yi-aditya/LCEC-IO/docs/review/M4-ethercat.md

# M4 - EtherCAT sheet for review

KiCad project: `hardware/lcec-io.kicad_pro`. New sheet `04_ethercat.kicad_sch` (page 4). The root sheet now wires the ten MCU/EtherCAT nets between sheets 3 and 4. Generated by `scripts/build_schematics.py`, checked from KiCad's own netlist by `scripts/check_sheets.py`.

**To review in the browser:** [`M4-schematics.pdf`](M4-schematics.pdf) (all four sheets, A3), [`M4-sheet4-ethercat.png`](M4-sheet4-ethercat.png), [`M4-sheet1-root.png`](M4-sheet1-root.png). ERC report: [`M4-erc.rpt`](M4-erc.rpt). Sheets 2 and 3 are unchanged from M3 (`M3-sheet2-power.png`, `M3-sheet3-mcu.png`).

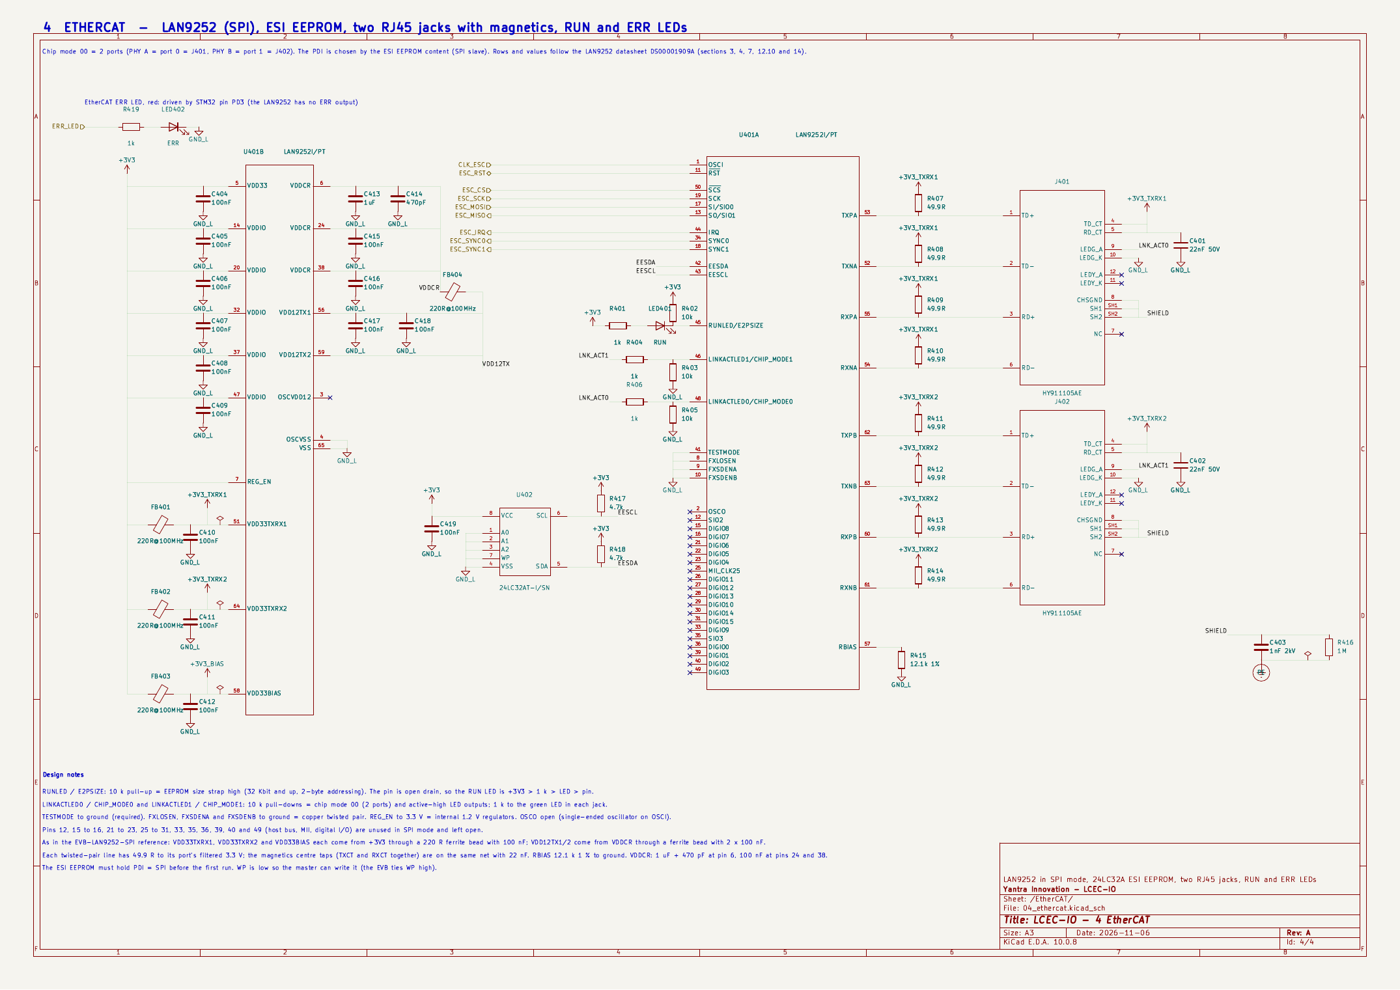
[picture p2: docs/review/M4-sheet4-ethercat.png]
EtherCAT


## Compared with the EVB-LAN9252-SPI reference (you supplied it)

I first drew this sheet from the datasheet because the reference could not be downloaded, then compared it with your PDF (`EVB_LAN9252-SPI` sheets 2 to 4) and **changed the sheet to match it where it differed**: the three PHY supplies and the VDD12TX supply each now come through their own 220 R ferrite bead (BLM18EG221SN1D, C85827, 187,060 on lcsc.com), the terminations and centre taps use each port's own filtered supply, and the centre-tap capacitor is 22 nF.

| Item | EVB reference | This sheet |
|---|---|---|
| SPI pins, IRQ, SYNC0/1 | SCK 19, SCS# 50, SI 17, SO 13, IRQ 44, SYNC0 34, SYNC1 18 | same |
| Straps | TESTMODE, FXLOSEN, FXSDENA/B to ground; REG_EN to 3.3 V; LINKACT0/1 pins 10 k to ground; E2PSIZE 10 k to 3.3 V | same |
| PHY supplies | FB1/FB2/FB3 from 3.3 V to VDD33TXRX1, VDD33TXRX2, VDD33BIAS, 100 nF each | same (FB401 to FB403, 100 nF each; the DNP 1 uF footprints are not drawn) |
| VDD12TX1/2 | from VDDCR through FB4, 2 x 100 nF | same (FB404, 2 x 100 nF) |
| VDDCR, VDD33, VDDIO | 1 uF + 470 pF + 2 x 100 nF; 6 x 100 nF | same |
| Terminations | 4 x 49.9 R per port to that port's VDD33TXRX net | same |
| Centre taps | both tied, 0 R to the port's VDD33TXRX net, 22 nF to ground | same, direct (no 0 R), 22 nF |
| RBIAS, OSCVDD12, OSCVSS | 12.1 k; OSCVDD12 open; OSCVSS to ground | same |
| Link LEDs | 1 k to the jack's green LED | same |

Differences, all from the plan or my choice (please confirm):

| Item | EVB | This sheet | Why |
|---|---|---|---|
| Clock | 25 MHz crystal with 18 pF caps | shared 25 MHz oscillator on OSCI, OSCO open | plan |
| EEPROM | 24FC512, 2 k pull-ups, A0-A2 through 4.7 k to ground, **WP tied high** | 24LC32A, 4.7 k pull-ups, A0-A2 direct to ground, **WP low** | plan; WP low so the master can write the ESI (with WP high it can only be programmed externally) |
| RUN LED resistor | 270 R | 1 k | same part as the other status LEDs, about 1 mA |
| RST# | 10 k pull-up, 0.1 uF, push-button | STM32 PC5 with 10 k pull-up (open drain), no capacitor | plan; the LAN9252 has its own power-on reset |
| Shield / chassis | CHS GND to ground, 10 pF EMI capacitors DNP | CHS GND and shield tabs to 1 nF/2 kV in parallel with 1 M to PE | plan |

## Definition of done

| Requirement | Result |
|---|---|
| `kicad-cli sch erc` zero errors, run from the root | **0 errors**, the same 2 warnings as M3 (`ground_pin_not_ground` on U201/U203) |
| LAN9252 matches the reference circuit | compared with the EVB-LAN9252-SPI schematic (table above); differences listed; every item checked by script against the netlist |
| SPI/IRQ/SYNC/RST nets match the pin map in `docs/plan.md` | checked from the netlist: STM32 PA4/PA5/PA6/PA7/PC4/PA0/PC13/PC5 are on the same nets as LAN9252 pins 50/19/13/17/44/34/18/11 |
| Drawing rules from M3 | style check passes on all four sheets: every instance at rotation 0, none mirrored, all text horizontal, no pin on the top or bottom edge |
| Every symbol has Value, Footprint, LCSC, MPN, Manufacturer, Datasheet | all parts, checked by script; BOM quantities not exceeded |

## What is on the sheet

- **U401 LAN9252I/PT**, two units: signals (U401A) and power (U401B). Host interface is **SPI** (SCS#, SCK, SI, SO); IRQ, SYNC0, SYNC1, RST# go to the STM32; OSCI takes the 25 MHz clock from the MCU sheet (OSCO open, as the datasheet says for a single-ended oscillator).
- **Chip mode 00 (2 ports):** CHIP_MODE0/1 share the link LED pins and are held low by 10 k pull-downs. PHY A is port 0 (J401), PHY B is port 1 (J402).
- **EEPROM:** U402 24LC32A on EESDA/EESCL with 4.7 k pull-ups, WP low so the master can write the ESI. **E2PSIZE** (RUNLED pin) has a 10 k pull-up: strap high = 32 Kbit and up, 2-byte addressing, as the 24LC32A needs. The EEPROM image must set PDI = SPI.
- **Straps:** TESTMODE to ground (datasheet: must be VSS); FXLOSEN, FXSDENA, FXSDENB to ground = copper; REG_EN to 3.3 V = internal 1.2 V regulators.
- **Supplies:** 100 nF at VDD33 and each of the 5 VDDIO pins; VDDCR (3 pins) 1 uF + 470 pF at pin 6 and 100 nF on the others; VDD12TX1 and VDD12TX2 tied together and fed from VDDCR through FB404 with 2 x 100 nF (datasheet: fed from the regulator via the PCB; EVB uses the ferrite). OSCVDD12 left open (datasheet: no external capacitor required).
- **PHY 3.3 V:** VDD33TXRX1, VDD33TXRX2 and VDD33BIAS each from +3V3 through a 220 R ferrite bead (FB401 to FB403) with 100 nF, nets `+3V3_TXRX1`, `+3V3_TXRX2`, `+3V3_BIAS`.
- **Twisted pairs:** TXP/TXN/RXP/RXN of each port go straight to the jack; each line has 49.9 R to its port's filtered supply (8 resistors). RBIAS 12.1 k 1 % to ground.
- **Jacks:** the HY911105AE has its own Bob Smith termination (4 x 75 R and 1 nF/2 kV to chassis, from its datasheet drawing). Both centre taps go to the port's `+3V3_TXRX` net with 22 nF. Green LED = link/activity from the LAN9252 pin through 1 k (active high, because the strap is low). Yellow LED unused. CHS GND and both shield tabs go to the shield net: **1 nF/2 kV in parallel with 1 M to PE** (plan).
- **RUN LED:** +3V3 > 1 k > LED401 > RUNLED pin (open drain, active low because E2PSIZE is high). **ERR LED:** LED402 red, driven from the STM32 (PD3 via the `ERR_LED` hierarchical label) through 1 k.
- **Unused pins** (host bus, MII, digital I/O, OSCO, 20 pins) carry no-connect flags.

## BOM changes (this milestone)

- 49.9 R is now a fixed quantity of 8 (was an estimate).
- Added 470 pF 50 V X7R 0603, **C1620** (77,200 in stock on lcsc.com); 4 ferrite beads 220 R **C85827** (FB401 to FB404, 187,060 in stock); 2 x 22 nF 50 V X7R **C106222** (246,700 in stock).
- LED references: RUN is LED401, ERR is LED402 (the plan list had LED401-LED402 and LED403).
- Removed the "10 uF x 4 (per LAN9252 reference in M4)" estimate row: the datasheet needs no 10 uF capacitor on this sheet.
- Still open from M3: Omron P2R-05P relay socket (C1524860) shows low stock, 44 on lcsc.com for 8 needed.

## Library changes

- `scripts/relayout_symbols.py` re-lays out the LAN9252 (two units, SPI signals grouped, blank rows where parts hang), the HY911105AE jack, and the 24LC32A EEPROM so no pin is on the top or bottom edge. Pin numbers are unchanged; the LAN9252 shows only the SPI-mode name of each pin, and `scripts/pin_tables.py` now compares by token for it. Datasheet pin check: 44 of 44 symbols clean.

## How it was built and checked

```
python3 -I scripts/relayout_symbols.py   # after fix_symbols.py; then finalize_lib.py
python3 -I scripts/build_schematics.py   # writes hardware/*.kicad_sch
python3 -I scripts/check_sheets.py       # ERC, pin map, netlist checks for sheets 2-4, style, fields, BOM quantities
```
