yi-aditya/LCEC-IO/docs/review/M3-sheet1-root.png

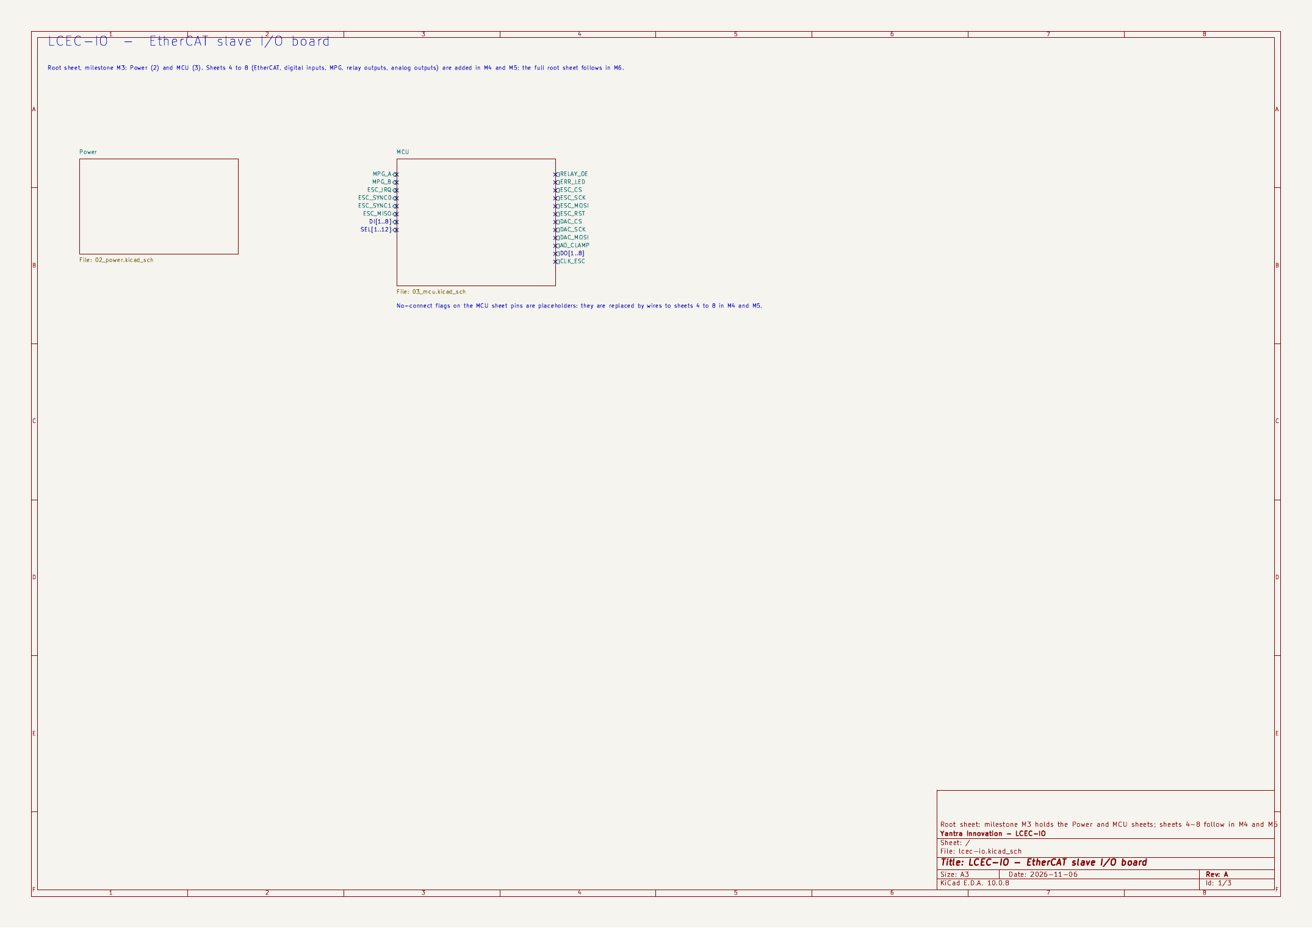
docs/review/M3-sheet1-root.png
