yi-aditya/LCEC-IO/docs/review/M4-sheet1-root.png

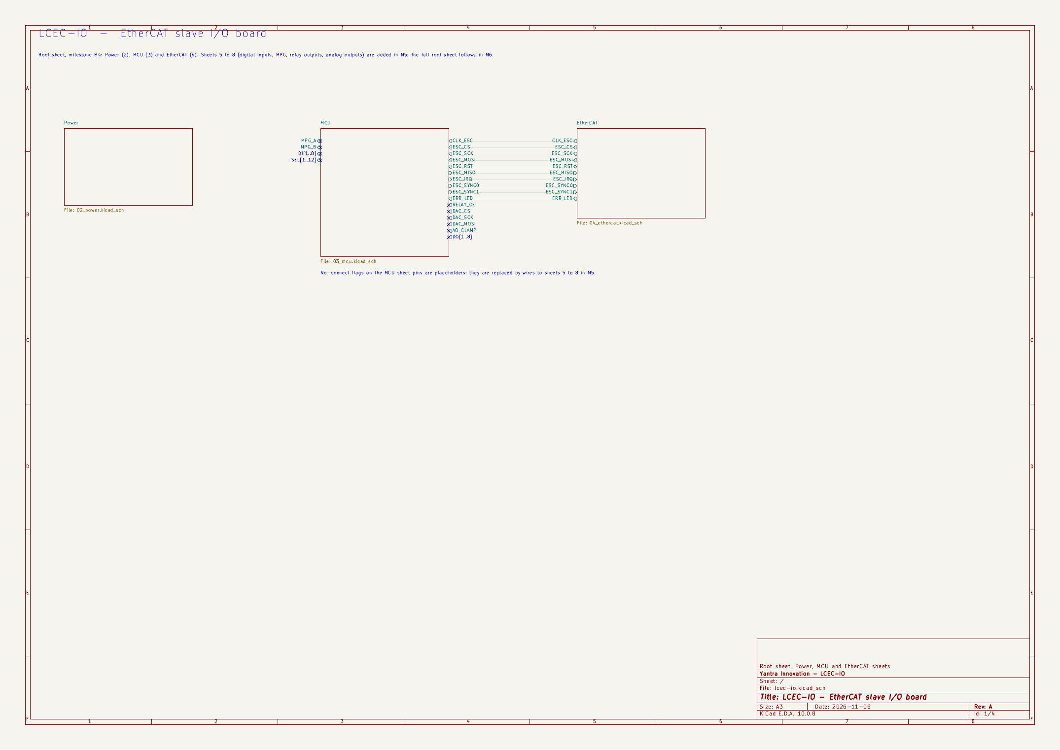
docs/review/M4-sheet1-root.png
