yi-aditya/LCEC-IO/docs/review/M5-sheet1-root.png

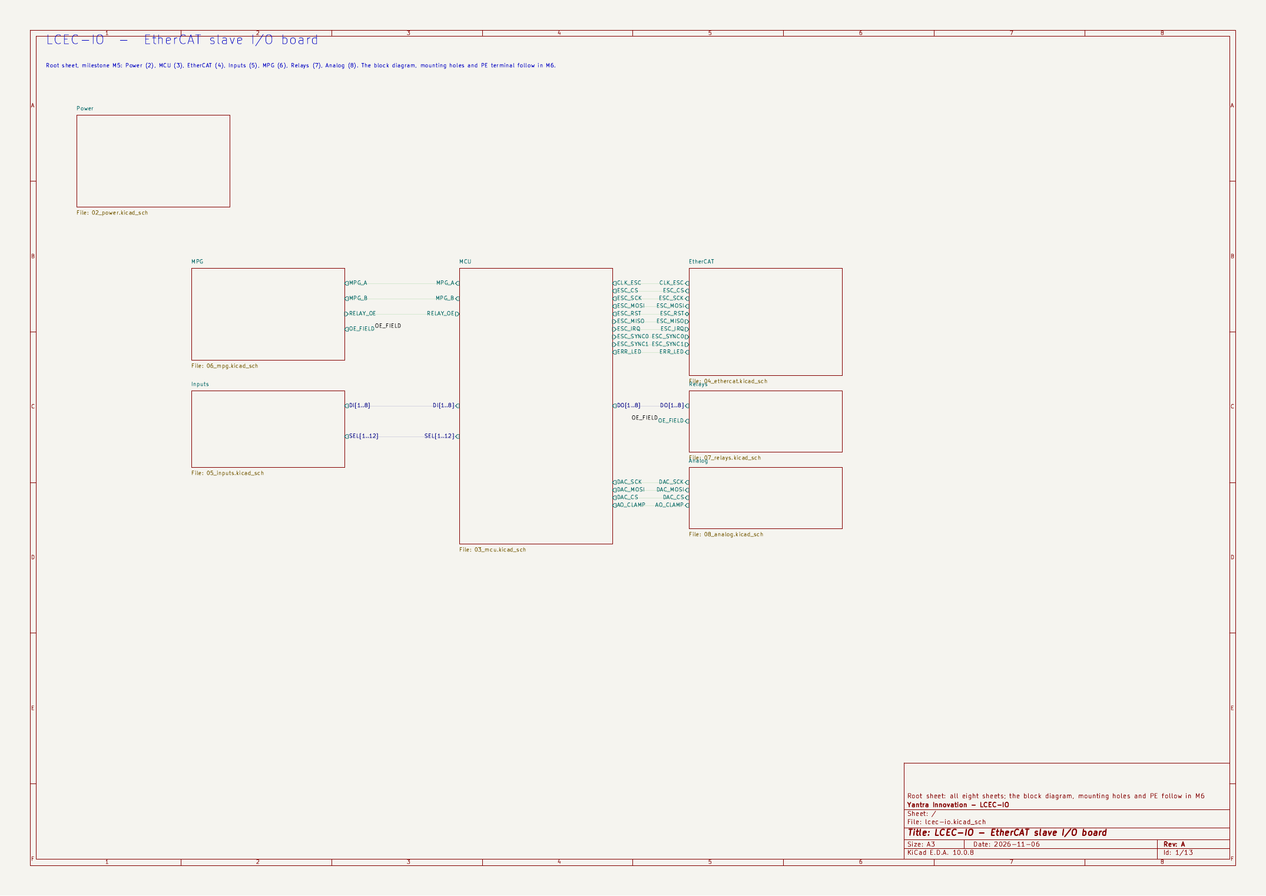
docs/review/M5-sheet1-root.png
