yi-aditya/LCEC-IO/docs/review/M5-sheet5-inputs.png

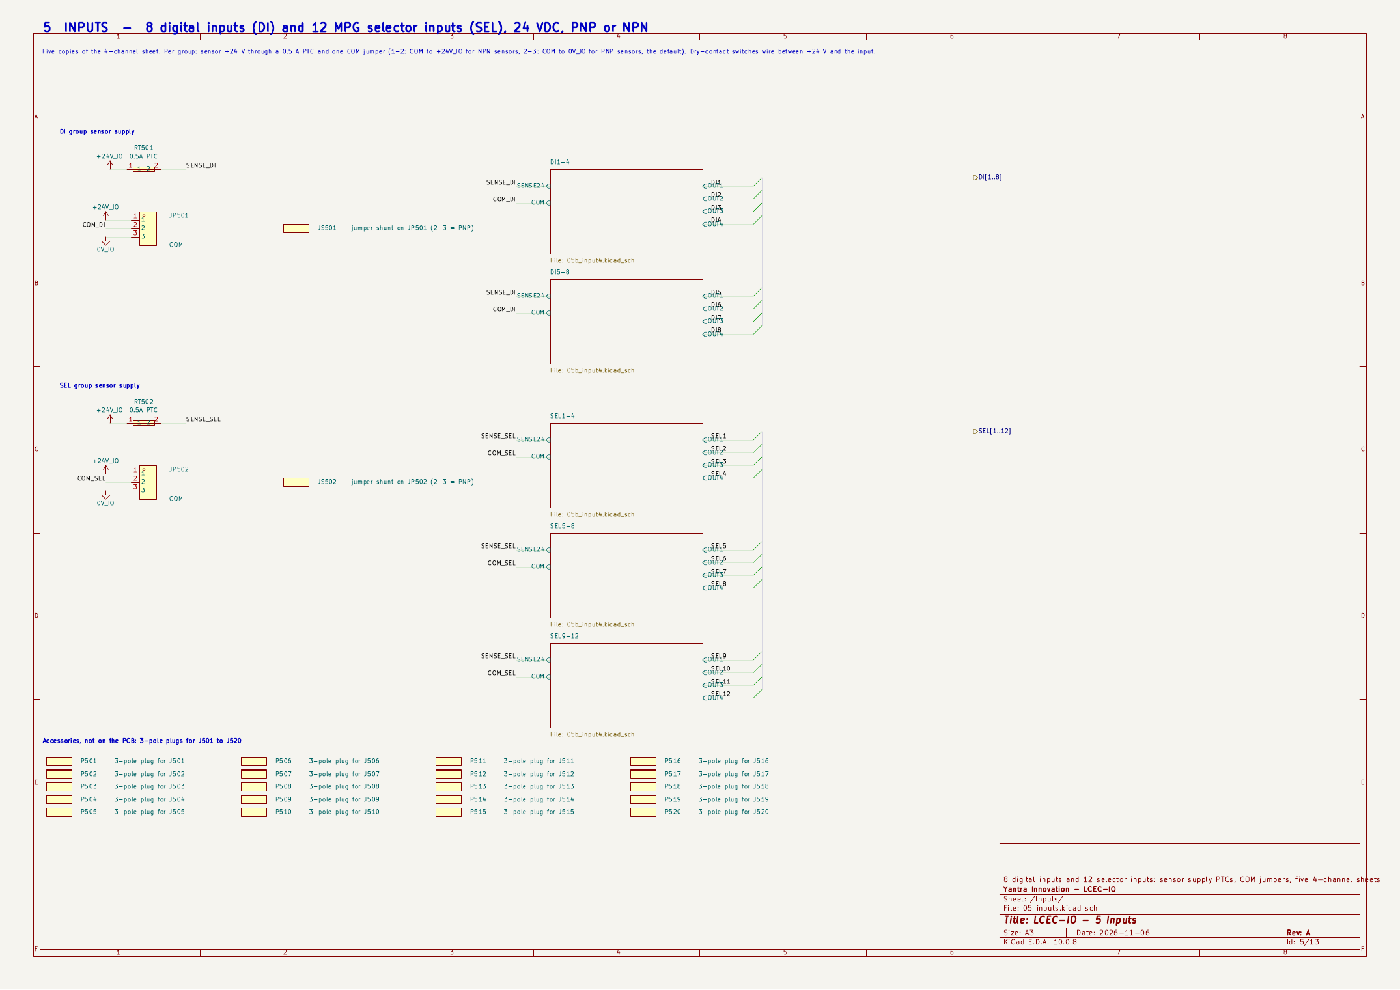
docs/review/M5-sheet5-inputs.png
