yi-aditya/LCEC-IO/docs/review/M5-sheet5b-input4.png

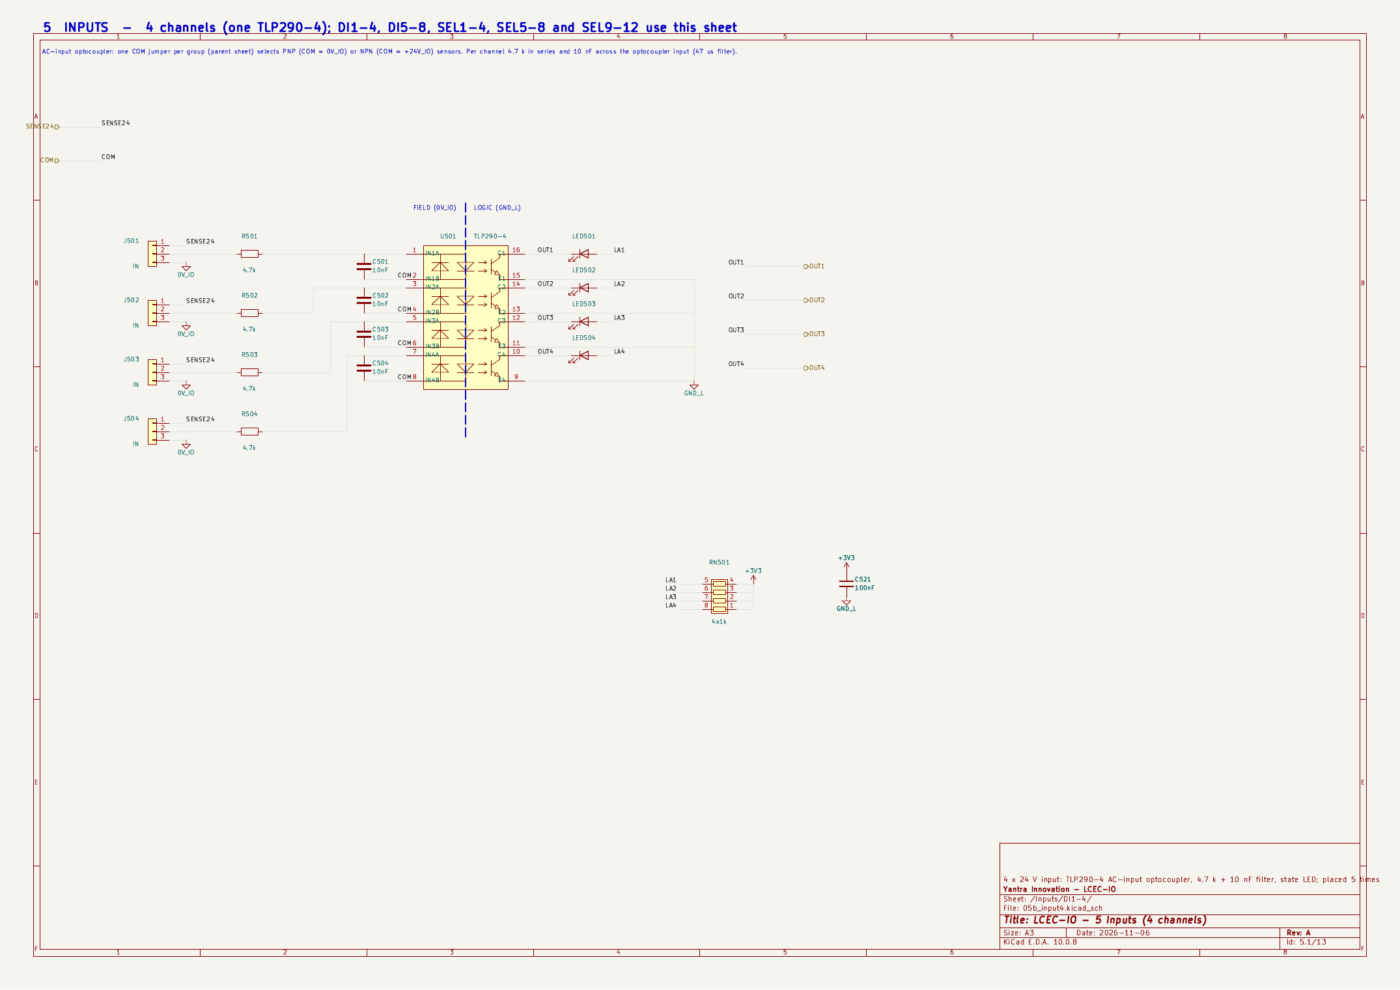
docs/review/M5-sheet5b-input4.png
