yi-aditya/LCEC-IO/docs/review/M5-sheet6-mpg.png

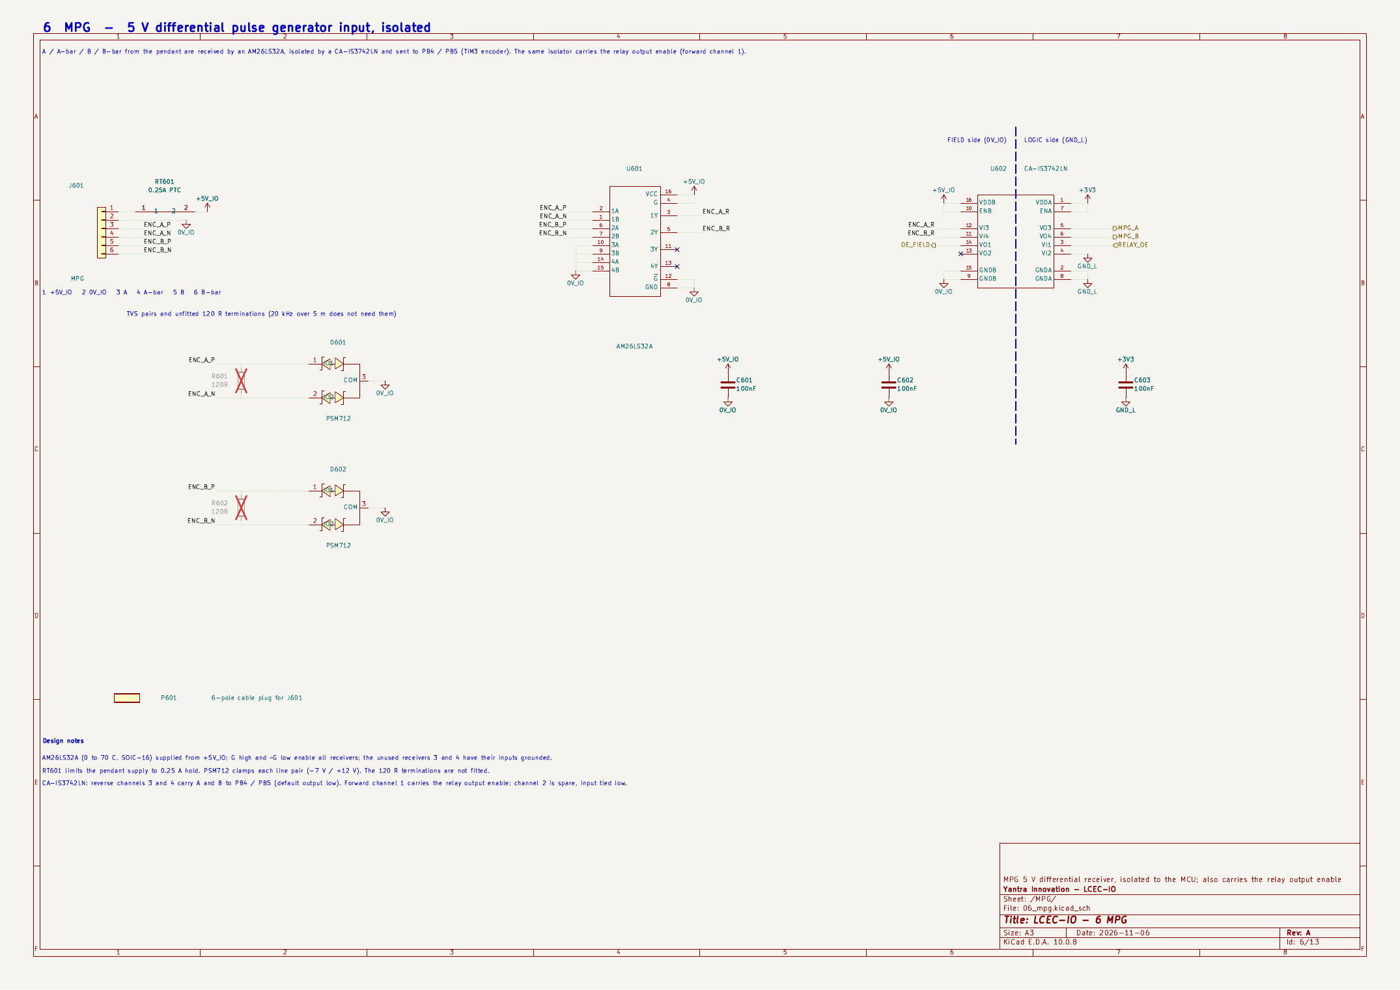
docs/review/M5-sheet6-mpg.png
