yi-aditya/LCEC-IO/docs/review/M5-sheet7-relays.png

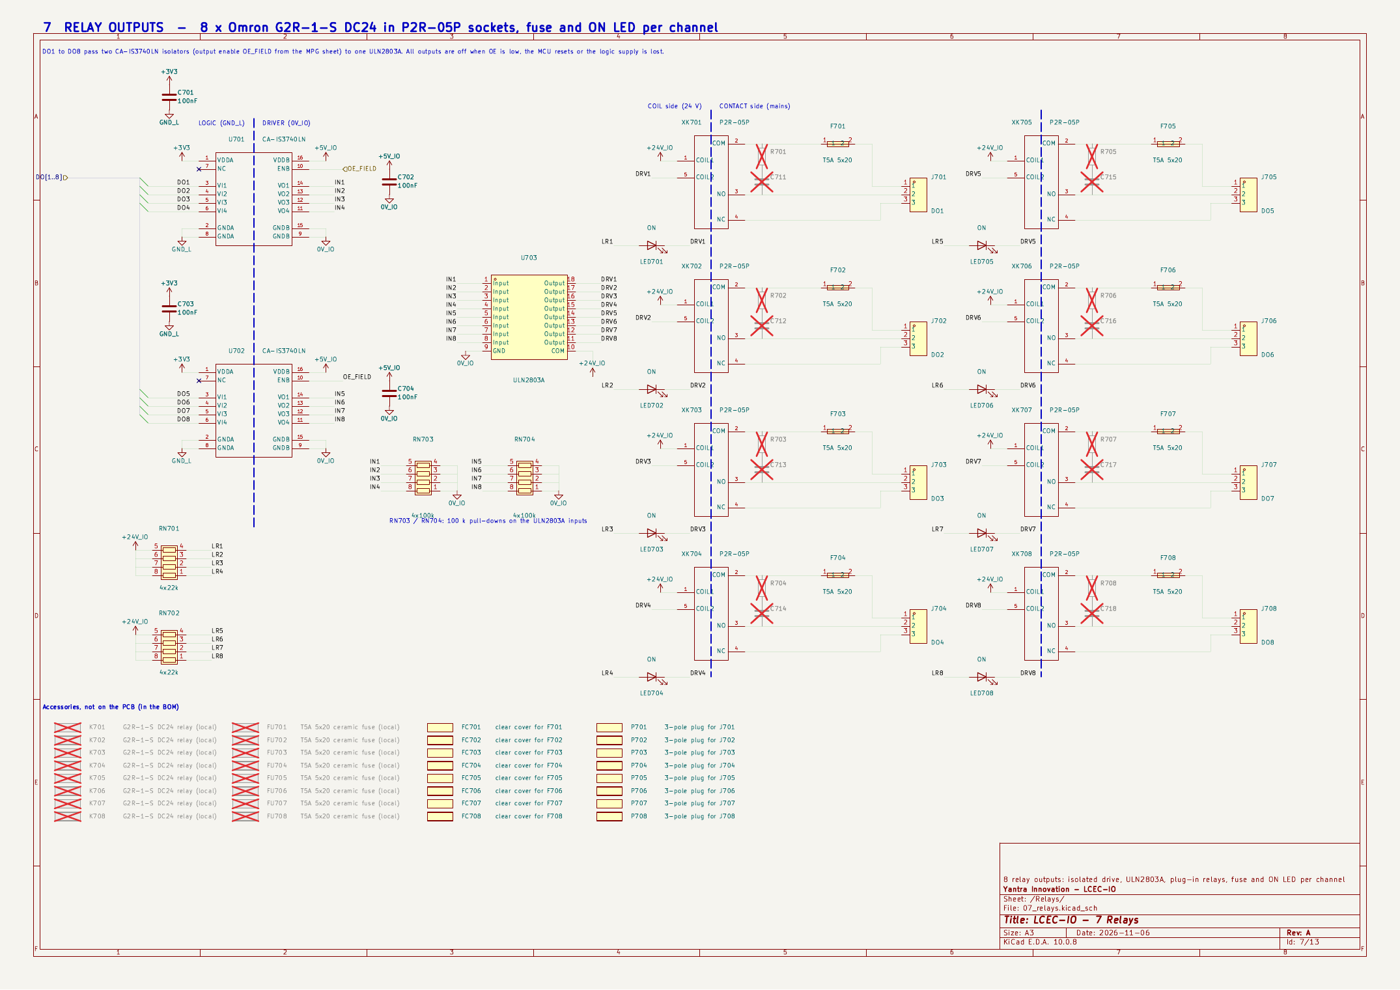
docs/review/M5-sheet7-relays.png
