yi-aditya/LCEC-IO/docs/review/M5-sheet8-analog.png

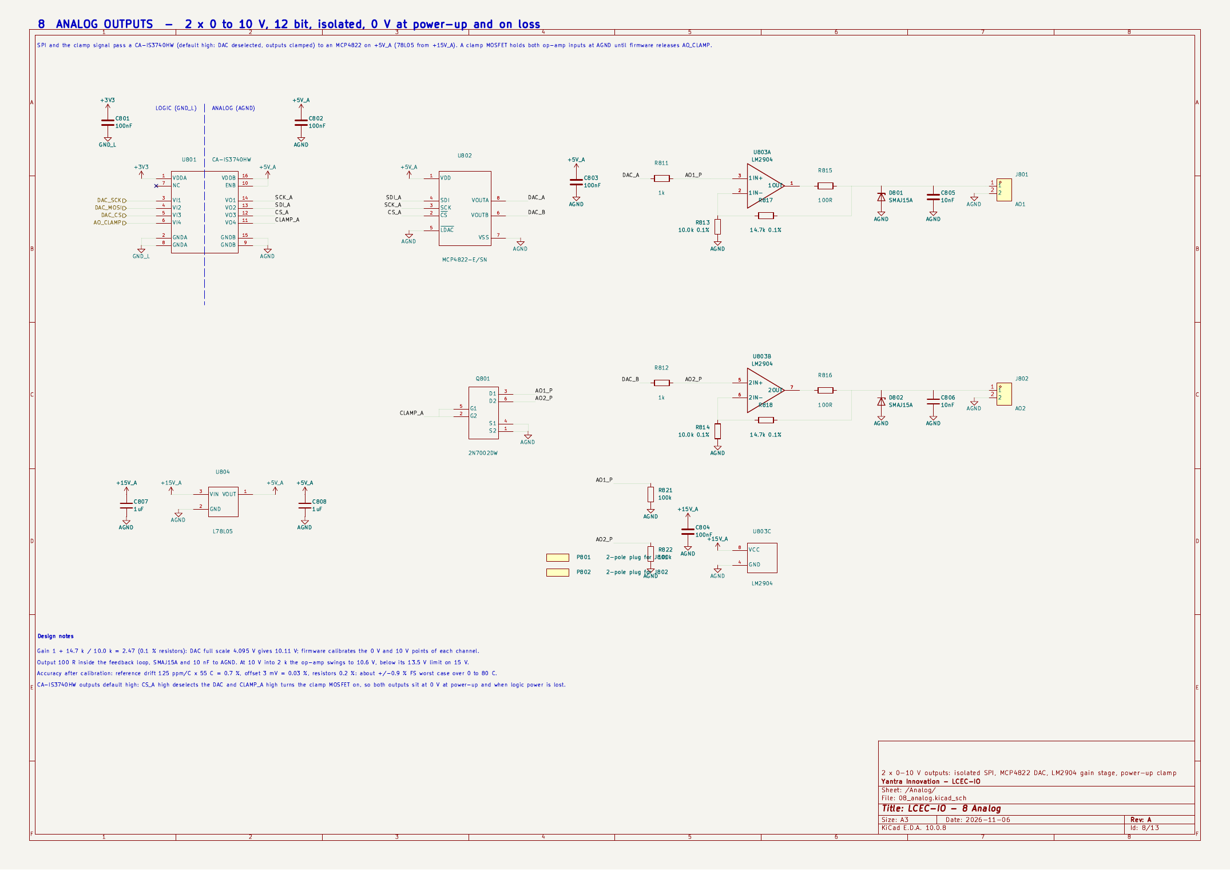
docs/review/M5-sheet8-analog.png
