yi-aditya/LCEC-IO/docs/review/M6-floorplan-v1-260x160.png

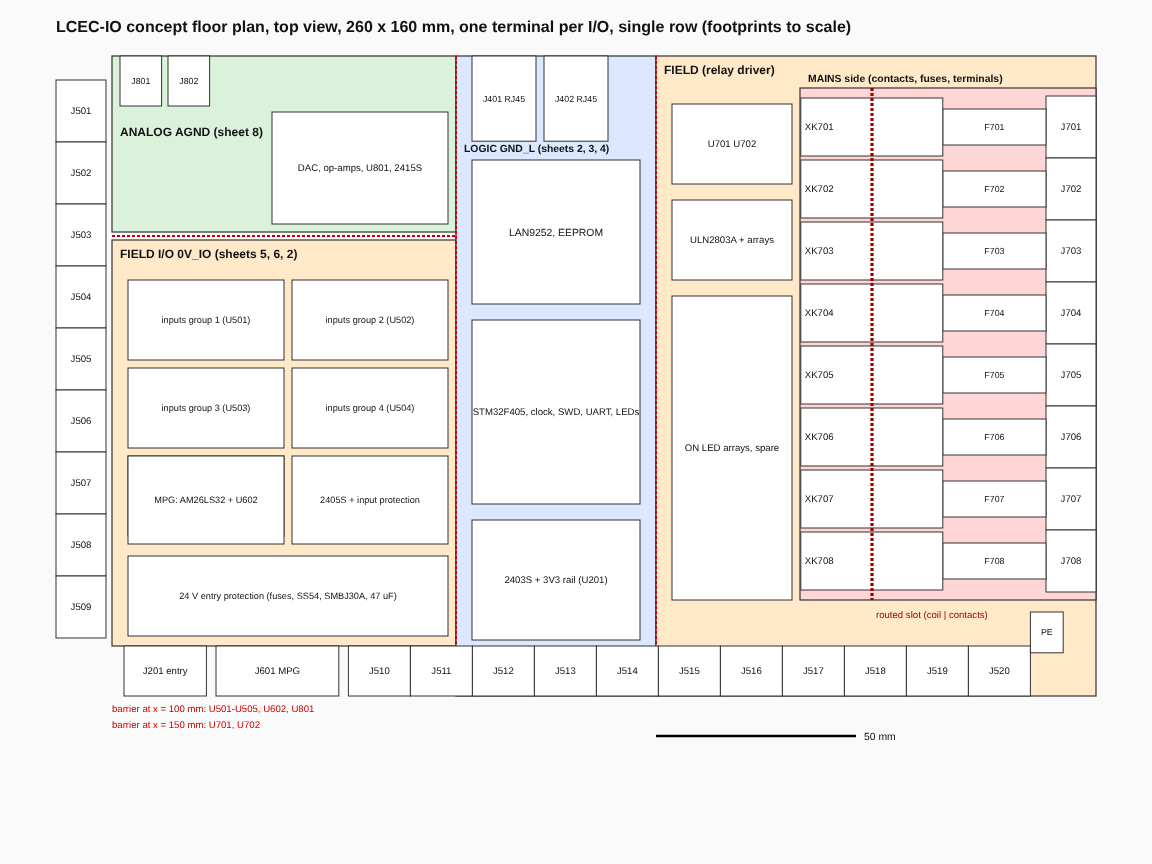
docs/review/M6-floorplan-v1-260x160.png
