yi-aditya/LCEC-IO/docs/review/M6-sheet1-root.png

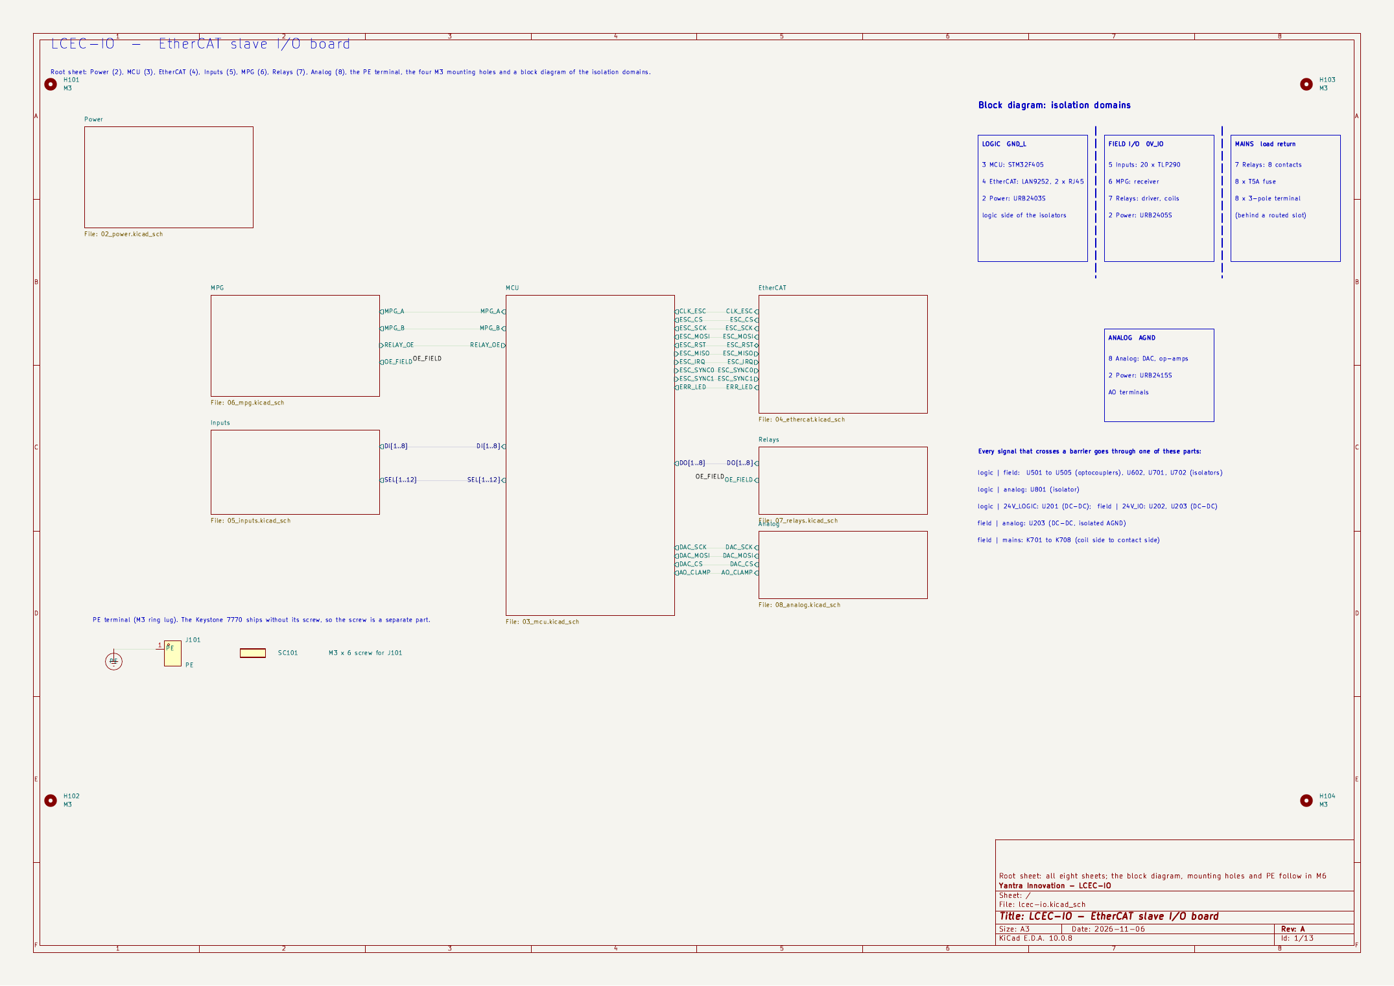
docs/review/M6-sheet1-root.png
