yi-aditya/LCEC-IO/bom/parts.csv

Sheet | RefGroup | Description | Qty | Qty_basis | Footprint | LCSC | MPN | Manufacturer | Package_LCSC | Temp_range | Stock | Price_USD_qty1 | Library | Fit | Status | Proposed_LCSC | Notes | Checked
3 MCU | U301 | STM32F405VGT6 MCU LQFP-100 | 1 | fixed | lcsc:LQFP-100_L14.0-W14.0-P0.50-LS16.0-BL | C56621 | STM32F405VGT6 | ST | LQFP-100(14x14) | -40℃~+85℃ | 920 | 7.6428 | extended | Y | CHANGED |  | Owner decision 2026-11-06: 100-pin package instead of the plan's LQFP-64 F405RGT6 (82 I/O, room for the EtherCAT ERR LED and future pins). Same F4 core, 1 MB flash. About $7.6 at qty 1 (plan: about $3.2) with about 900 in stock on lcsc.com. 6 VDD pins need 6 decoupling capacitors. | 2026-11-06
3 MCU | X301 | 25 MHz CMOS oscillator, 3.2x2.5 mm | 1 | fixed | lcsc:OSC-SMD_4P-L3.2-W2.5-BL_KYOCERA_KC3225A | C2595919 | ECS-3225MVQ-250-CN-TR | ECS | SMD3225-4P | -40℃~+85℃ | 45 | 2.028 | extended | Y | PLAN-FLAG |  | Ordering code -CN decodes to +/-25 ppm, -40..+85 C (datasheet ordering table), meets the <= +/-50 ppm target. Datasheet note says +/-25 ppm is 'contact ECS for availability' and LCSC stock is under 100: confirm before ordering. | 2026-11-06
3 MCU | J301 | SWD header 2x5 1.27 mm SMD | 1 | fixed | lcsc:HDR-SMD_10P-P1.27-V-M-R2-C5-LS5.3 | C3975188 | PZ127-2-05-S | HCTL | SMD,P=1.27mm | -40℃~+105℃ | 14970 | 0.1472 | extended | Y | NEW |  | PA13, PA14, PB3 SWO, NRST, 3V3, GND. | 2026-11-06
3 MCU | J302 | USART2 header 1x3 2.54 mm | 1 | fixed | lcsc:HDR-TH_3P-P2.54-V-M_PZ254V-11-03P | C2937625 | PZ254V-11-03P | XFCN | Through Hole,P=2.54mm | -40℃~+105℃ | 1011340 | 0.0201 | extended | Y | NEW |  | PA2/PA3 + GND. Same part as the two COM jumper headers. | 2026-11-06
3 MCU | FB301 | Ferrite bead 600R@100MHz 0603 (VDDA) | 1 | fixed | Inductor_SMD:L_0603_1608Metric | C19330 | BLM18AG601SN1D | muRata | 0603 | -55℃~+125℃ | 431100 | 0.0122 | extended | Y | NEW |  | VDDA filter. Murata, 500 mA. (Sunlord C1002 is basic but has no LCSC product page, so its stock cannot be checked.) | 2026-11-06
3 MCU | LED301 | Heartbeat LED yellow 0603 | 1 | fixed | LED_SMD:LED_0603_1608Metric | C2287 | KT-0603Y | Hubei KENTO Elec | 0603 | -40℃~+85℃ | 91350 | 0.0108 | extended | Y | NEW |  | PA1. | 2026-11-06
4 EtherCAT | U401 | LAN9252I/PT EtherCAT slave controller TQFP-64 | 1 | fixed | lcsc:TQFP-64_L10.0-W10.0-P0.50-LS12.0-BL-EP | C80933 | LAN9252I/PT | MICROCHIP | TQFP-64(10x10) | -40℃~+85℃ | 4189 | 8.6354 | extended | Y | PLAN |  |  | 2026-11-06
4 EtherCAT | U402 | 24LC32AT-I/SN EEPROM 32 Kbit SOIC-8 | 1 | fixed | lcsc:SOIC-8_L4.9-W3.9-P1.27-LS6.0-BL | C615715 | 24LC32AT-I/SN | MICROCHIP | SOIC-8 | -40℃~+85℃ | 2185 | 0.4696 | extended | Y | PLAN |  | ESI EEPROM. | 2026-11-06
4 EtherCAT | J401-J402 | RJ45 jack with integrated magnetics and LEDs | 2 | fixed | lcsc:RJ45-TH_HR911105A | C69427 | HY911105AE | HANRUN(Zhongshan HanRun Elec) | Through Hole | -40℃~+85℃ | 3023 | 2.8377 | extended | Y | PLAN |  | Datasheet checked: 1CT:1CT magnetics, green + yellow LEDs, 1500 Vrms, -40..+85 C. Image-only PDF, so magnetics wiring is re-read in M2/M4. | 2026-11-06
4 EtherCAT | LED401 | EtherCAT RUN LED (yellow-green) 0603 | 1 | fixed | LED_SMD:LED_0603_1608Metric | C89809 | NCD0603C3 | NATIONSTAR | 0603 | -30℃~+85℃ | 20640 | 0.0261 | extended | Y | CHANGED |  | Yellow-green accepted 2026-11-05 in place of 'green': no ~2 V green exists on LCSC and emerald-green (Vf 2.6-3.6 V) may not light from 3.3 V through 1 kOhm. | 2026-11-06
4 EtherCAT | LED402 | EtherCAT ERR LED red 0603 | 1 | fixed | LED_SMD:LED_0603_1608Metric | C2286 | KT-0603R | Hubei KENTO Elec | 0603 | -40℃~+85℃ | 4158200 | 0.0077 | basic | Y | NEW |  |  | 2026-11-06
4 EtherCAT | R4xx | 49.9 R 1% 0603 (LAN9252 TX/RX termination) | 8 | fixed | Resistor_SMD:R_0603_1608Metric | C23185 | 0603WAF499JT5E | UNI-ROYAL | 0603 | -55℃~+155℃ | 555100 | 0.002 | basic | Y | NEW |  | M4: one 49.9 R from each of the 8 twisted-pair lines (TXP/TXN/RXP/RXN, two ports) to the port's ferrite-filtered 3.3 V (EVB reference R4-R7, R15-R18). | 2026-11-06
4 EtherCAT | R4xx | 12.1 k 1% 0603 (RBIAS) | 1 | fixed | Resistor_SMD:R_0603_1608Metric | C22864 | 0603WAF1212T5E | UNI-ROYAL | 0603 | -55℃~+155℃ | 154400 | 0.0016 | extended | Y | NEW |  | Extended part (no basic 12.1 k). | 2026-11-06
4 EtherCAT | R4xx | 4.7 k 1% 0603 (EEPROM pull-ups) | 2 | fixed | Resistor_SMD:R_0603_1608Metric | C23162 | 0603WAF4701T5E | UNI-ROYAL | 0603 | -55℃~+155℃ | 4065700 | 0.0028 | basic | Y | NEW |  |  | 2026-11-06
4 EtherCAT | R4xx | 1 M 1% 0603 (shield bleed) | 1 | fixed | Resistor_SMD:R_0603_1608Metric | C22935 | 0603WAF1004T5E | UNI-ROYAL | 0603 | -55℃~+155℃ | 1542400 | 0.0018 | basic | Y | NEW |  | In parallel with the 1 nF/2 kV cap, shield to PE. | 2026-11-06
4 EtherCAT | FB401-FB404 | Ferrite bead 220R@100MHz 0603 (LAN9252 PHY supplies, VDD12TX) | 4 | fixed | Inductor_SMD:L_0603_1608Metric | C85827 | BLM18EG221SN1D | muRata | 0603 | -55℃~+125℃ | 186860 | 0.0597 | extended | Y | NEW |  | Same part as the EVB-LAN9252-SPI reference (FB1-FB4): one each for VDD33TXRX1, VDD33TXRX2, VDD33BIAS and VDD12TX. | 2026-11-06
4 EtherCAT | C4xx | 22 nF 50 V X7R 0603 (magnetics centre taps) | 2 | fixed | Capacitor_SMD:C_0603_1608Metric | C106222 | CC0603KRX7R9BB223 | YAGEO | 0603 | see MPN datasheet | 246600 | 0.0032 | extended | Y | NEW |  | EVB reference C27/C33 (0.022 uF/50 V), one per jack. | 2026-11-06
4 EtherCAT | C4xx | 470 pF 50 V X7R 0603 (LAN9252 VDDCR) | 1 | fixed | Capacitor_SMD:C_0603_1608Metric | C1620 | 0603B471K500NT | FH | 0603 | see MPN datasheet | 77100 | 0.0058 | basic | Y | NEW |  | DS00001909A section 3.x: 1 uF and 470 pF in parallel on the VDDCR pin 6. | 2026-11-06
4 EtherCAT | C4xx | 1 nF 2 kV X7R 1206 (shield to PE) | 1 | fixed | Capacitor_SMD:C_1206_3216Metric | C9196 | 1206B102K202NT | FH | 1206 | see MPN datasheet | 219120 | 0.0229 | basic | Y | NEW |  |  | 2026-11-06
2 Power | U201 | URB2403S-6WR3 isolated DC-DC 24V to 3.3V 1.35 A | 1 | fixed | lcsc:PWRM-TH_URBXXXXS-6WR3_1 | C5369843 | URB2403S-6WR3 | YLPTEC | SIP,22x9.5mm | -40℃~+105℃ | 182 | 5.6911 | extended | Y | PLAN-FLAG |  | Datasheet: absolute max input 40 V ('exceeding may cause permanent damage'). The plan's SMBJ33A clamped at 53.3 V; replaced by the SMBJ30A (48.4 V) on 2026-11-06. | 2026-11-06
2 Power | U202 | URB2405S-6WR3 isolated DC-DC 24V to 5V 1.2 A | 1 | fixed | lcsc:PWRM-TH_YLPTEC_URXXXXXS-6WR3 | C3031185 | URB2405S-6WR3 | YLPTEC | SIP,22x9.5mm | -40℃~+105℃ | 6188 | 4.8336 | extended | Y | PLAN-FLAG |  | Same 40 V input maximum. | 2026-11-06
2 Power | U203 | URB2415S-6WR3 isolated DC-DC 24V to 15V 0.4 A | 1 | fixed | lcsc:PWRM-TH_URBXXXXS-6WR3 | C5369844 | URB2415S-6WR3 | YLPTEC | SIP,22x9.5mm | -40℃~+105℃ | 109 | 5.7982 | extended | Y | PLAN-FLAG |  | LCSC rates -40..+105 C (plan said 'check datasheet'). Same 40 V input maximum; stock about 100. | 2026-11-06
2 Power | D201-D202 | SMBJ30A TVS 600 W, 30 V stand-off, SMB | 2 | fixed | lcsc:SMB_L4.4-W3.6-LS5.4-RD | C83851 | SMBJ30A | Littelfuse | DO-214AA | -65℃~+150℃ | 17085 | 0.1279 | extended | Y | CHANGED |  | Owner decision 2026-11-06: SMBJ30A replaces the plan's SMBJ33A (C320242). Vc = 48.4 V at 12.4 A, below the URB 50 V / 1 s surge rating; 30 V stand-off is above the 28.8 V maximum input. | 2026-11-06
2 Power | D203-D204 | SS54 Schottky 40 V 5 A SMA (reverse polarity) | 2 | fixed | lcsc:SMA_L4.4-W2.8-LS5.4-R-RD | C22452 | SS54 | MDD(Microdiode Semiconductor) | SMA(DO-214AC) | see MPN datasheet | 1462890 | 0.045 | basic | Y | NEW |  | Basic part. 40 V reverse rating vs 28.8 V max input. | 2026-11-06
2 Power | F201-F202 | Fuse block 5x20 mm PCB, Littelfuse 646 (24V_LOGIC, 24V_IO) | 2 | fixed | lcsc:64600001003 | C206887 | 64600001003 | Littelfuse | Through Hole | see MPN datasheet | 963 | 0.9428 | extended | Y | CHANGED |  | Owner chose replaceable 5x20 fuses for the two 24 V inputs (2026-11-05). Same block as the relay fuses (replaces the C58066 holder, which had no dimensioned drawing). Footprint checked against the Littelfuse hole-pattern drawing (22.6 mm). | 2026-11-06
2 Power | F201 | Fuse 5x20 mm 1 A 250 V glass (24V_LOGIC) | 1 | fixed | n/a (accessory, not on the PCB) | C3116 | 5F.1000210000R1 | Xucheng Elec | D5.2xL20mm | -40℃~+125℃ | 10940 | 0.0648 | extended | Y | CHANGED |  | Fitted at assembly (cheap, on LCSC). 5F series = fast-acting; confirm blow characteristic vs inrush into 47 uF at M3. | 2026-11-06
2 Power | F202 | Fuse 5x20 mm 3 A 250 V glass (24V_IO) | 1 | fixed | n/a (accessory, not on the PCB) | C3118 | 5G.3000210000S1 | Xucheng Elec | D5.2xL20mm | -40℃~+125℃ | 1830 | 0.0648 | extended | Y | CHANGED |  | Fitted at assembly. Confirm blow characteristic at M3. | 2026-11-06
2 Power | C2xx | 47 uF 50 V aluminium electrolytic SMD 6.3x7.7 | 2 | fixed | lcsc:CAP-SMD_BD6.3-L6.6-W6.6-LS7.2-FD | C970679 | RVT1H470M0607 47UF 50V | DMBJ | SMD,D6.3xL7.7mm | -55℃~+105℃ | 31920 | 0.0378 | extended | Y | NEW |  | One per 24 V input. | 2026-11-06
2 Power | C2xx | 1 uF 50 V X7R 0805 | 2 | fixed | Capacitor_SMD:C_0805_2012Metric | C91185 | CC0805KKX7R9BB105 | YAGEO | 0805 | see MPN datasheet | 154860 | 0.035 | extended | Y | CHANGED |  | One per 24 V input. Replaces C28323 (lcsc.com stock 0). | 2026-11-06
2 Power | C2xx | 22 uF 25 V X5R 0805 (URB output capacitor) | 3 | fixed | Capacitor_SMD:C_0805_2012Metric | C45783 | CL21A226MAQNNNE | Samsung Electro-Mechanics | 0805 | see MPN datasheet | 118800 | 0.1851 | basic | Y | NEW |  | Datasheet Cout: 22 uF/16 V for 3.3 V and 5 V, 22 uF/25 V for 15 V. One 25 V part covers all three. | 2026-11-06
2 Power | C2xx | 100 uF 100 V electrolytic radial (URB input capacitor) | 3 | fixed | lcsc:CAP-TH_BD10.0-P5.00-D0.6-FD | C2960285 | 100V100uF CD288 | HRK | Through Hole,D10xL20mm | -40℃~+105℃ | 2075 | 0.094 | extended | Y | CHANGED |  | Approved 2026-11-05. URB datasheet (Fig. 2/3) recommends Cin 100 uF/100 V per module on a 24 V input. 10 mm diameter radial: reserve layout space. | 2026-11-06
3 MCU | C3xx | 2.2 uF 16 V X5R 0603 (VCAP) | 2 | fixed | Capacitor_SMD:C_0603_1608Metric | C23630 | CL10A225KO8NNNC | Samsung Electro-Mechanics | 0603 | see MPN datasheet | 225750 | 0.012 | basic | Y | NEW |  |  | 2026-11-06
3 MCU | C3xx | 4.7 uF 16 V X5R 0603 (bulk) | 1 | fixed | Capacitor_SMD:C_0603_1608Metric | C19666 | CL10A475KO8NNNC | Samsung Electro-Mechanics | 0603 | see MPN datasheet | 1103370 | 0.0151 | basic | Y | NEW |  | STM32 bulk plus LAN9252 supply; final count at schematic. | 2026-11-06
3 MCU | R3xx | 22 R 1% 0603 (clock series) | 2 | fixed | Resistor_SMD:R_0603_1608Metric | C23345 | 0603WAF220JT5E | UNI-ROYAL | 0603 | -55℃~+155℃ | 2563300 | 0.0017 | basic | Y | NEW |  | Oscillator to PH0 and to LAN9252 OSCI. | 2026-11-06
3 MCU | R3xx | 10 k 1% 0603 | 7 | fixed | Resistor_SMD:R_0603_1608Metric | C25804 | 0603WAF1002T5E | UNI-ROYAL | 0603 | -55℃~+155℃ | 4409600 | 0.0024 | basic | Y | NEW |  | BOOT0, PD2 pull-down, PB14 and PC5 pull-ups, LAN9252 straps. Final count at schematic. | 2026-11-06
3 MCU | R3xx | 1 k 1% 0603 (status LED resistors) | 5 | fixed | Resistor_SMD:R_0603_1608Metric | C21190 | 0603WAF1001T5E | UNI-ROYAL | 0603 | -55℃~+155℃ | 2407100 | 0.0017 | basic | Y | NEW |  | Heartbeat, RUN, ERR and four jack LEDs. | 2026-11-06
all | C xx | 100 nF 50 V X7R 0603 | 40 | fixed | Capacitor_SMD:C_0603_1608Metric | C1591 | CL10B104KB8NNNC | Samsung Electro-Mechanics | 0603 | see MPN datasheet | 1328900 | 0.0072 | extended | Y | CHANGED |  | Estimate: 6 VDD + VDDA + VBAT on the STM32, 1 NRST, about 10 LAN9252, 2 per isolator package x4, oscillator, EEPROM, DAC, op-amp, 78L05. Exact count at schematic. | 2026-11-06
5 Inputs | U501-U505 | TLP290-4(GB) AC-input quad optocoupler SOP-16 | 5 | fixed | lcsc:SOP-16_L10.3-W4.4-P1.27-LS7.0-BL | C39031 | TLP290-4(GB-TP,E | TOSHIBA | SOP-16-4.4mm | -55℃~+110℃ | 15749 | 0.545 | extended | Y | PLAN |  | Datasheet input type AC/DC, -55..+110 C, 2.5 kV. | 2026-11-06
5 Inputs | R501-R520 | 4.7 k 1% 1206 (24 V input resistor) | 20 | fixed | Resistor_SMD:R_1206_3216Metric | C17936 | 1206W4F4701T5E | UNI-ROYAL | 1206 | -55℃~+155℃ | 1252900 | 0.0078 | basic | Y | NEW |  | 0.16 W worst case of 0.25 W. | 2026-11-06
5 Inputs | C501-C520 | 10 nF 50 V X7R 0603 (input filter) | 20 | fixed | Capacitor_SMD:C_0603_1608Metric | C1589 | CL10B103KB8NNNC | Samsung Electro-Mechanics | 0603 | see MPN datasheet | 1850750 | 0.0075 | extended | Y | CHANGED |  | Replaces C57112 (lcsc.com stock 0). | 2026-11-06
5 Inputs | LED501-LED520 | Input state LED (yellow-green) 0603 | 20 | fixed | LED_SMD:LED_0603_1608Metric | C89809 | NCD0603C3 | NATIONSTAR | 0603 | -30℃~+85℃ | 20640 | 0.0261 | extended | Y | CHANGED |  | Yellow-green accepted (see RUN LED). | 2026-11-06
5 Inputs | RN501-RN505 | 1 k x4 resistor array 0603 (LED resistors) | 5 | fixed | Resistor_SMD:R_Array_Convex_4x0603 | C20197 | 4D03WGJ0102T5E | UNI-ROYAL | 0603x4 | see MPN datasheet | 336800 | 0.0096 | basic | Y | NEW |  | Basic part. | 2026-11-06
5 Inputs | J501-J520 | Terminal header 3-pole 5.08 mm, one per input (+24V via PTC, IN, 0V) | 20 | fixed | lcsc:CONN-TH_3P-P5.08_KF2EDGR-5.08-3P | C441205 | KF2EDGR-5.08-3P | Cixi Kefa Elec | Through Hole,Right Angle,P=5.08mm | -40℃~+105℃ | 23010 | 0.0634 | extended | Y | CHANGED |  | Owner decision 2026-11-05: one 3-pole connector per input, DI1-8 and SEL1-12 (replaces the 10-pole and 14-pole terminals, which also removes the 14-pole stock problem). | 2026-11-06
5 Inputs | P501-P520 | Terminal plug 3-pole 5.08 mm | 20 | fixed | n/a (accessory, not on the PCB) | C440881 | KF2EDGK-5.08-3P-AA | Cixi Kefa Elec | P=5.08mm | -40℃~+105℃ | 25375 | 0.2848 | extended | Y | CHANGED |  | See J501-J520. | 2026-11-06
5 Inputs | RT501-RT502 | PTC 0.5 A hold, 30 V, 1812 (sensor +24 V) | 2 | fixed | lcsc:F1812 | C151168 | 1812L050/30PR | Littelfuse | 1812 | -40℃~+85℃ | 10620 | 0.1214 | extended | Y | NEW-FLAG |  | 0.5 A hold / 1 A trip, 30 V max vs 28.8 V input, thin margin. One per input terminal (DI, SEL). | 2026-11-06
5 Inputs | JP501-JP502 | COM jumper header 1x3 2.54 mm | 2 | fixed | lcsc:HDR-TH_3P-P2.54-V-M_PZ254V-11-03P | C2937625 | PZ254V-11-03P | XFCN | Through Hole,P=2.54mm | -40℃~+105℃ | 1011340 | 0.0201 | extended | Y | NEW |  | One for DI, one for SEL. | 2026-11-06
5 Inputs | JP501-JP502 | Jumper shunt 2.54 mm | 2 | fixed | n/a (accessory, not on the PCB) | C5305 | 2.54 | BOOMELE(Boom Precision Elec) | P=2.54mm | see MPN datasheet | 892550 | 0.0099 | extended | Y | NEW |  | Fitted shunt on each COM header. | 2026-11-06
6 MPG | U601 | AM26LS32ACDRG4 quad line receiver SOIC-16 (0..70 C) | 1 | fixed | lcsc:SOIC-16_L9.9-W3.9-P1.27-LS6.0-BL | C6180 | AM26LS32ACDR | TI | SOIC-16 | 0℃~+70℃ | 49432 | 0.4765 | extended | Y | CHANGED |  | Approved 2026-11-05. Plan number C2671811 (AM26LS32ACDRG4) has zero stock; C6180 is the same TI part and pinout, 0..70 C, SOIC-16. | 2026-11-06
6 MPG | U602 | CA-IS3742LN digital isolator 2 fwd + 2 rev SOIC-16 | 1 | fixed | lcsc:SOP-16_L10.0-W3.9-P1.27-LS6.0-BL | C5347249 | CA-IS3742LN | Chipanalog | SOIC-16NB | -40℃~+125℃ | 3174 | 0.8184 | extended | Y | PLAN |  | Default output low, -40..+125 C. | 2026-11-06
6 MPG | J601 | Terminal header 6-pole 5.08 mm | 1 | fixed | lcsc:CONN-TH_6P-P5.08_KF2EDGR-5.08-6P | C441208 | KF2EDGR-5.08-6P | Cixi Kefa Elec | Through Hole,Right Angle,P=5.08mm | -40℃~+105℃ | 2565 | 0.1251 | extended | Y | NEW |  |  | 2026-11-06
6 MPG | P601 | Terminal plug 6-pole 5.08 mm | 1 | fixed | n/a (accessory, not on the PCB) | C440884 | KF2EDGK-5.08-6P | Cixi Kefa Elec | P=5.08mm | -40℃~+105℃ | 5698 | 0.5051 | extended | Y | NEW |  |  | 2026-11-06
6 MPG | RT601 | PTC 0.25 A hold, 16 V, 1206 (+5V_IO to MPG) | 1 | fixed | lcsc:F1206 | C70068 | nSMD025 | TECHFUSE | 1206 | -40℃~+85℃ | 11320 | 0.0403 | extended | Y | NEW |  | 0.25 A hold / 0.5 A trip. | 2026-11-06
6 MPG | D601-D602 | PSM712 TVS pair SOT-23 (one per A and B pair) | 2 | fixed | lcsc:SOT-23-3_L3.0-W1.7-P0.95-LS2.9-BR | C32677 | PSM712-LF-T7 | PROTEK | SOT-23 | -55℃~+150℃ | 60690 | 0.347 | basic | Y | NEW |  | RS-485 class asymmetric clamp (-7/+12 V), basic part. | 2026-11-06
6 MPG | R6xx | 120 R 1% 0603 (line termination, not fitted) | 2 | fixed | Resistor_SMD:R_0603_1608Metric | C22787 | 0603WAF1200T5E | UNI-ROYAL | 0603 | -55℃~+155℃ | 1002600 | 0.0017 | basic | DNP | NEW |  | Footprints left unfitted per plan. | 2026-11-06
7 Relays | U701-U702 | CA-IS3740LN digital isolator 4 fwd SOIC-16 | 2 | fixed | lcsc:SOIC-16_L9.9-W3.9-P1.27-LS6.0-BL | C428888 | CA-IS3740LN | Chipanalog | SOIC-16 | -40℃~+125℃ | 2086 | 0.8184 | extended | Y | PLAN |  | Default output low. | 2026-11-06
7 Relays | U703 | ULN2803A 8-ch Darlington driver SOP-18 | 1 | fixed | lcsc:SOP-18_L11.4-W7.6-P1.27-LS10.6-BL | C845537 | ULN2803A | UMW | SOP-18-300mil | -40℃~+85℃ | 209205 | 0.2123 | extended | Y | CHANGED |  | Approved 2026-11-05. Plan number C181731 (Mixic) has zero stock; C845537 is UMW ULN2803A, SOP-18-300mil, -40..+85 C. Pin-check against its datasheet in M2. | 2026-11-06
7 Relays | XK701-XK708 | Omron P2R-05P PCB relay socket | 8 | fixed | lcsc:RELAY-TH_P2R-05P | C1524860 | P2R-05P | OMRON | - | see MPN datasheet | 44 | 6.4839 | extended | Y | PLAN-FLAG |  | Stock 44 (need 8 per board). Plan allows Mouser/DigiKey if LCSC runs out. | 2026-11-06
7 Relays | K701-K708 | Omron G2R-1-S DC24 relay (buy locally in India) | 8 | fixed | n/a (plugs into socket) |  |  | Omron |  | -40..+70 C (plan, check) |  |  |  | DNP | LOCAL |  | Not on the assembly line. Rating: -40..+70 C per plan, confirm against the Omron datasheet. | 2026-11-06
7 Relays | F701-F708 | Fuse block 5x20 mm PCB, Littelfuse 646 | 8 | fixed | lcsc:64600001003 | C206887 | 64600001003 | Littelfuse | Through Hole | see MPN datasheet | 963 | 0.9428 | extended | Y | CHANGED |  | Owner decision 2026-11-06: replace the C58066 holder (no dimensioned drawing, 80 C rating) with the Littelfuse 646 series, which has a full drawing. 250 V, 6.3 A (5 A / 1 W with the 648 cover). The datasheet states no operating temperature (PA 6.6 housing, UL 94 V-0): ask Littelfuse or accept. | 2026-11-06
7 Relays | F701-F708 + F201-F202 (cover) | Clear cover for the 646 fuse block (Littelfuse 648, polycarbonate) | 10 | fixed | n/a (accessory, not on the PCB) | C187509 | 64800001009 | Littelfuse | Through Hole,P=22.7mm | see MPN datasheet | 595 | 0.3258 | extended | Y | CHANGED |  | Covers the live fuse clips (mains side on F701-F708). Ordered with the block; accessory, no footprint. | 2026-11-06
7 Relays | F701-F708 (fuse) | Fuse 5x20 mm T5A 250 VAC ceramic (buy locally in India) | 8 | fixed | n/a (in holder) |  |  | (local India) |  |  |  |  |  | DNP | LOCAL |  | Not on the assembly line. | 2026-11-06
7 Relays | J701-J708 | Terminal header 3-pole 5.08 mm, one per relay (COM via fuse, NO, NC) | 8 | fixed | lcsc:CONN-TH_3P-P5.08_KF2EDGR-5.08-3P | C441205 | KF2EDGR-5.08-3P | Cixi Kefa Elec | Through Hole,Right Angle,P=5.08mm | -40℃~+105℃ | 23010 | 0.0634 | extended | Y | CHANGED |  | Owner decision 2026-11-05: one 3-pole connector per relay, NC brought out too (replaces two 8-pole terminals). 300 V rated; mains clearance handled at layout. | 2026-11-06
7 Relays | P701-P708 | Terminal plug 3-pole 5.08 mm | 8 | fixed | n/a (accessory, not on the PCB) | C440881 | KF2EDGK-5.08-3P-AA | Cixi Kefa Elec | P=5.08mm | -40℃~+105℃ | 25375 | 0.2848 | extended | Y | CHANGED |  | See J701-J708. | 2026-11-06
7 Relays | LED701-LED708 | Relay ON LED (yellow-green) 0603 | 8 | fixed | LED_SMD:LED_0603_1608Metric | C89809 | NCD0603C3 | NATIONSTAR | 0603 | -30℃~+85℃ | 20640 | 0.0261 | extended | Y | CHANGED |  | Yellow-green accepted (see RUN LED). | 2026-11-06
7 Relays | RN701-RN702 | 22 k x4 resistor array 0603 (LED series) | 2 | fixed | Resistor_SMD:R_Array_Convex_4x0603 | C25729 | 4D03WGJ0223T5E | UNI-ROYAL | 0603x4 | see MPN datasheet | 8800 | 0.0076 | extended | Y | NEW |  |  | 2026-11-06
7 Relays | RN703-RN704 | 100 k x4 resistor array 0603 (driver pull-downs) | 2 | fixed | Resistor_SMD:R_Array_Convex_4x0603 | C1996 | 4D03WGJ0104T5E | UNI-ROYAL | 0603x4 | see MPN datasheet | 12650 | 0.0104 | extended | Y | NEW |  |  | 2026-11-06
7 Relays | R7xx/C7xx | RC snubber across each contact (not fitted) | 8 | fixed | TBD at layout |  |  |  |  |  |  |  |  | DNP | FOOTPRINT |  | Footprint only (resistor + X-class capacitor). Values chosen in M5/layout. | 2026-11-06
8 Analog | U801 | CA-IS3740HW wide-body isolator 4 fwd, default high | 1 | fixed | lcsc:SOIC-16_L10.3-W7.5-P1.27-LS10.3-BL | C528653 | CA-IS3740HW | Chipanalog | SOIC-16-WB | -40℃~+125℃ | 1872 | 0.913 | extended | Y | PLAN |  | Default output HIGH (verified on LCSC page); 5 kVrms. | 2026-11-06
8 Analog | U802 | MCP4822-E/SN dual 12-bit DAC SOIC-8 | 1 | fixed | lcsc:SOIC-8_L4.9-W3.9-P1.27-LS6.0-BL | C16040 | MCP4822-E/SN | MICROCHIP | SOIC-8 | -40℃~+125℃ | 5994 | 2.4525 | extended | Y | PLAN |  |  | 2026-11-06
8 Analog | U803 | LM2904DR dual op-amp SOIC-8 | 1 | fixed | lcsc:SOIC-8_L4.9-W3.9-P1.27-LS6.0-BL | C7934 | LM2904DR | TI | SOIC-8 | -40℃~+125℃ | 65350 | 0.0854 | extended | Y | PLAN |  |  | 2026-11-06
8 Analog | U804 | L78L05ABUTR 5 V LDO SOT-89 (DAC supply) | 1 | fixed | lcsc:SOT-89-3_L4.5-W2.5-P1.50-LS4.2-TL | C42738 | L78L05ABUTR | ST | SOT-89-3 | -40℃~+125℃@(Tj) | 170580 | 0.0752 | extended | Y | NEW |  | -40..+125 C, 100 mA, input to 30 V. | 2026-11-06
8 Analog | Q801 | 2N7002DW dual N-MOSFET SOT-363 (clamp) | 1 | fixed | lcsc:SOT-363_L2.0-W1.3-P0.65-LS2.1-TL | C83571 | 2N7002DW-7-F | DIODES | SOT-363 | -55℃~+150℃ | 97005 | 0.1146 | extended | Y | NEW |  | One package shorts both op-amp inputs. | 2026-11-06
8 Analog | D801-D802 | SMAJ15A TVS 15 V SMA (AO outputs) | 2 | fixed | lcsc:SMA_L4.3-W2.6-LS5.2-RD | C148216 | SMAJ15A | Littelfuse | DO-214AC(SMA) | -65℃~+150℃ | 15335 | 0.1533 | extended | Y | NEW |  |  | 2026-11-06
8 Analog | R8xx | 14.7 k 0.1% thin film 0603 (gain) | 2 | fixed | Resistor_SMD:R_0603_1608Metric | C705725 | RT0603BRD0714K7L | YAGEO | 0603 | -55℃~+155℃ | 35840 | 0.0423 | extended | Y | NEW |  | 0.1%, 25 ppm/C. | 2026-11-06
8 Analog | R8xx | 10.0 k 0.1% thin film 0603 (gain) | 2 | fixed | Resistor_SMD:R_0603_1608Metric | C95204 | RT0603BRD0710KL | YAGEO | 0603 | -55℃~+155℃ | 498980 | 0.0305 | extended | Y | NEW |  | 0.1%, 25 ppm/C. | 2026-11-06
8 Analog | R8xx | 100 k 1% 0603 (input pull-down) | 2 | fixed | Resistor_SMD:R_0603_1608Metric | C25803 | 0603WAF1003T5E | UNI-ROYAL | 0603 | -55℃~+155℃ | 7501200 | 0.003 | basic | Y | NEW |  |  | 2026-11-06
8 Analog | R8xx | 100 R 1% 0603 (output series) | 2 | fixed | Resistor_SMD:R_0603_1608Metric | C22775 | 0603WAF1000T5E | UNI-ROYAL | 0603 | -55℃~+155℃ | 1063000 | 0.0021 | basic | Y | NEW |  |  | 2026-11-06
8 Analog | R8xx | 1 k 1% 0603 (DAC to op-amp) | 2 | fixed | Resistor_SMD:R_0603_1608Metric | C21190 | 0603WAF1001T5E | UNI-ROYAL | 0603 | -55℃~+155℃ | 2407100 | 0.0017 | basic | Y | NEW |  |  | 2026-11-06
8 Analog | C8xx | 1 uF 50 V X7R 0603 | 4 | fixed | Capacitor_SMD:C_0603_1608Metric | C559769 | CC0603KRX7R9BB105 | YAGEO | 0603 | see MPN datasheet | 609740 | 0.0569 | extended | Y | CHANGED |  | VDDA, 78L05 in/out, URB Cout0 and others; final count at schematic. X7R replaces X5R at 50 V (less DC-bias loss); replaces C15849. | 2026-11-06
8 Analog | C8xx | 10 nF 50 V X7R 0603 (AO output) | 2 | fixed | Capacitor_SMD:C_0603_1608Metric | C1589 | CL10B103KB8NNNC | Samsung Electro-Mechanics | 0603 | see MPN datasheet | 1850750 | 0.0075 | extended | Y | CHANGED |  |  | 2026-11-06
8 Analog | J801-J802 | Terminal header 2-pole 5.08 mm, one per output (AO, AGND) | 2 | fixed | lcsc:CONN-TH_2P-P5.08_KF2EDGR-5.08-2P | C441204 | KF2EDGR-5.08-2P | Cixi Kefa Elec | Through Hole,Right Angle,P=5.08mm | -40℃~+105℃ | 47950 | 0.0468 | extended | Y | CHANGED |  | Owner decision 2026-11-05: one connector per I/O (replaces the single 3-pole AO1/AO2/AGND terminal). | 2026-11-06
8 Analog | P801-P802 | Terminal plug 2-pole 5.08 mm | 2 | fixed | n/a (accessory, not on the PCB) | C440880 | KF2EDGK-5.08-2P-AA | Cixi Kefa Elec | P=5.08mm | -40℃~+105℃ | 52875 | 0.1568 | extended | Y | CHANGED |  | See J801-J802. | 2026-11-06
2 Power | J201 | Terminal header 4-pole 5.08 mm (24V entry) | 1 | fixed | lcsc:CONN-TH_4P-P5.08_KF2EDGR-5.08-4P | C441206 | KF2EDGR-5.08-4P | Cixi Kefa Elec | Through Hole,Right Angle,P=5.08mm | -40℃~+105℃ | 6825 | 0.0861 | extended | Y | NEW |  |  | 2026-11-06
2 Power | P201 | Terminal plug 4-pole 5.08 mm | 1 | fixed | n/a (accessory, not on the PCB) | C440882 | KF2EDGK-5.08-4P-AA | Cixi Kefa Elec | P=5.08mm | -40℃~+105℃ | 8450 | 0.3608 | extended | Y | NEW |  |  | 2026-11-06
1 Root | J101 | PE screw terminal M3 PCB (Keystone 7770) | 1 | fixed | lcsc:Keystone_7770_M3_PCB_Terminal | C5272782 | 7770 | Keystone | Through Hole | see MPN datasheet | 281 | 0.803 | extended | Y | NEW |  | Takes an M3 ring lug; also the shield-to-PE point. The 7770 ships WITHOUT its screw (Keystone datasheet), so the M3 screw below is a separate part. Footprint drawn from the Keystone drawing (5.00 x 7.01 mm, 1.85 mm holes). | 2026-11-06
1 Root | J101 (screw) | M3 x 6 pan-head cross-slot screw for the PE terminal (M3 x 0.5) | 1 | fixed | n/a (accessory, not on the PCB) | C357543 | PM3X6 | Shuntian | - | see MPN datasheet | 34400 | 0.0027 | extended | Y | CHANGED |  | Owner decision 2026-11-06: keep the 7770 and add a screw. Nickel-plated carbon steel, head 5 mm. Length 6 mm: confirm against the ring lug and wire at the mechanical review. | 2026-11-06
