yi-aditya/LCEC-IO/docs/review/M4-schematics.pdf

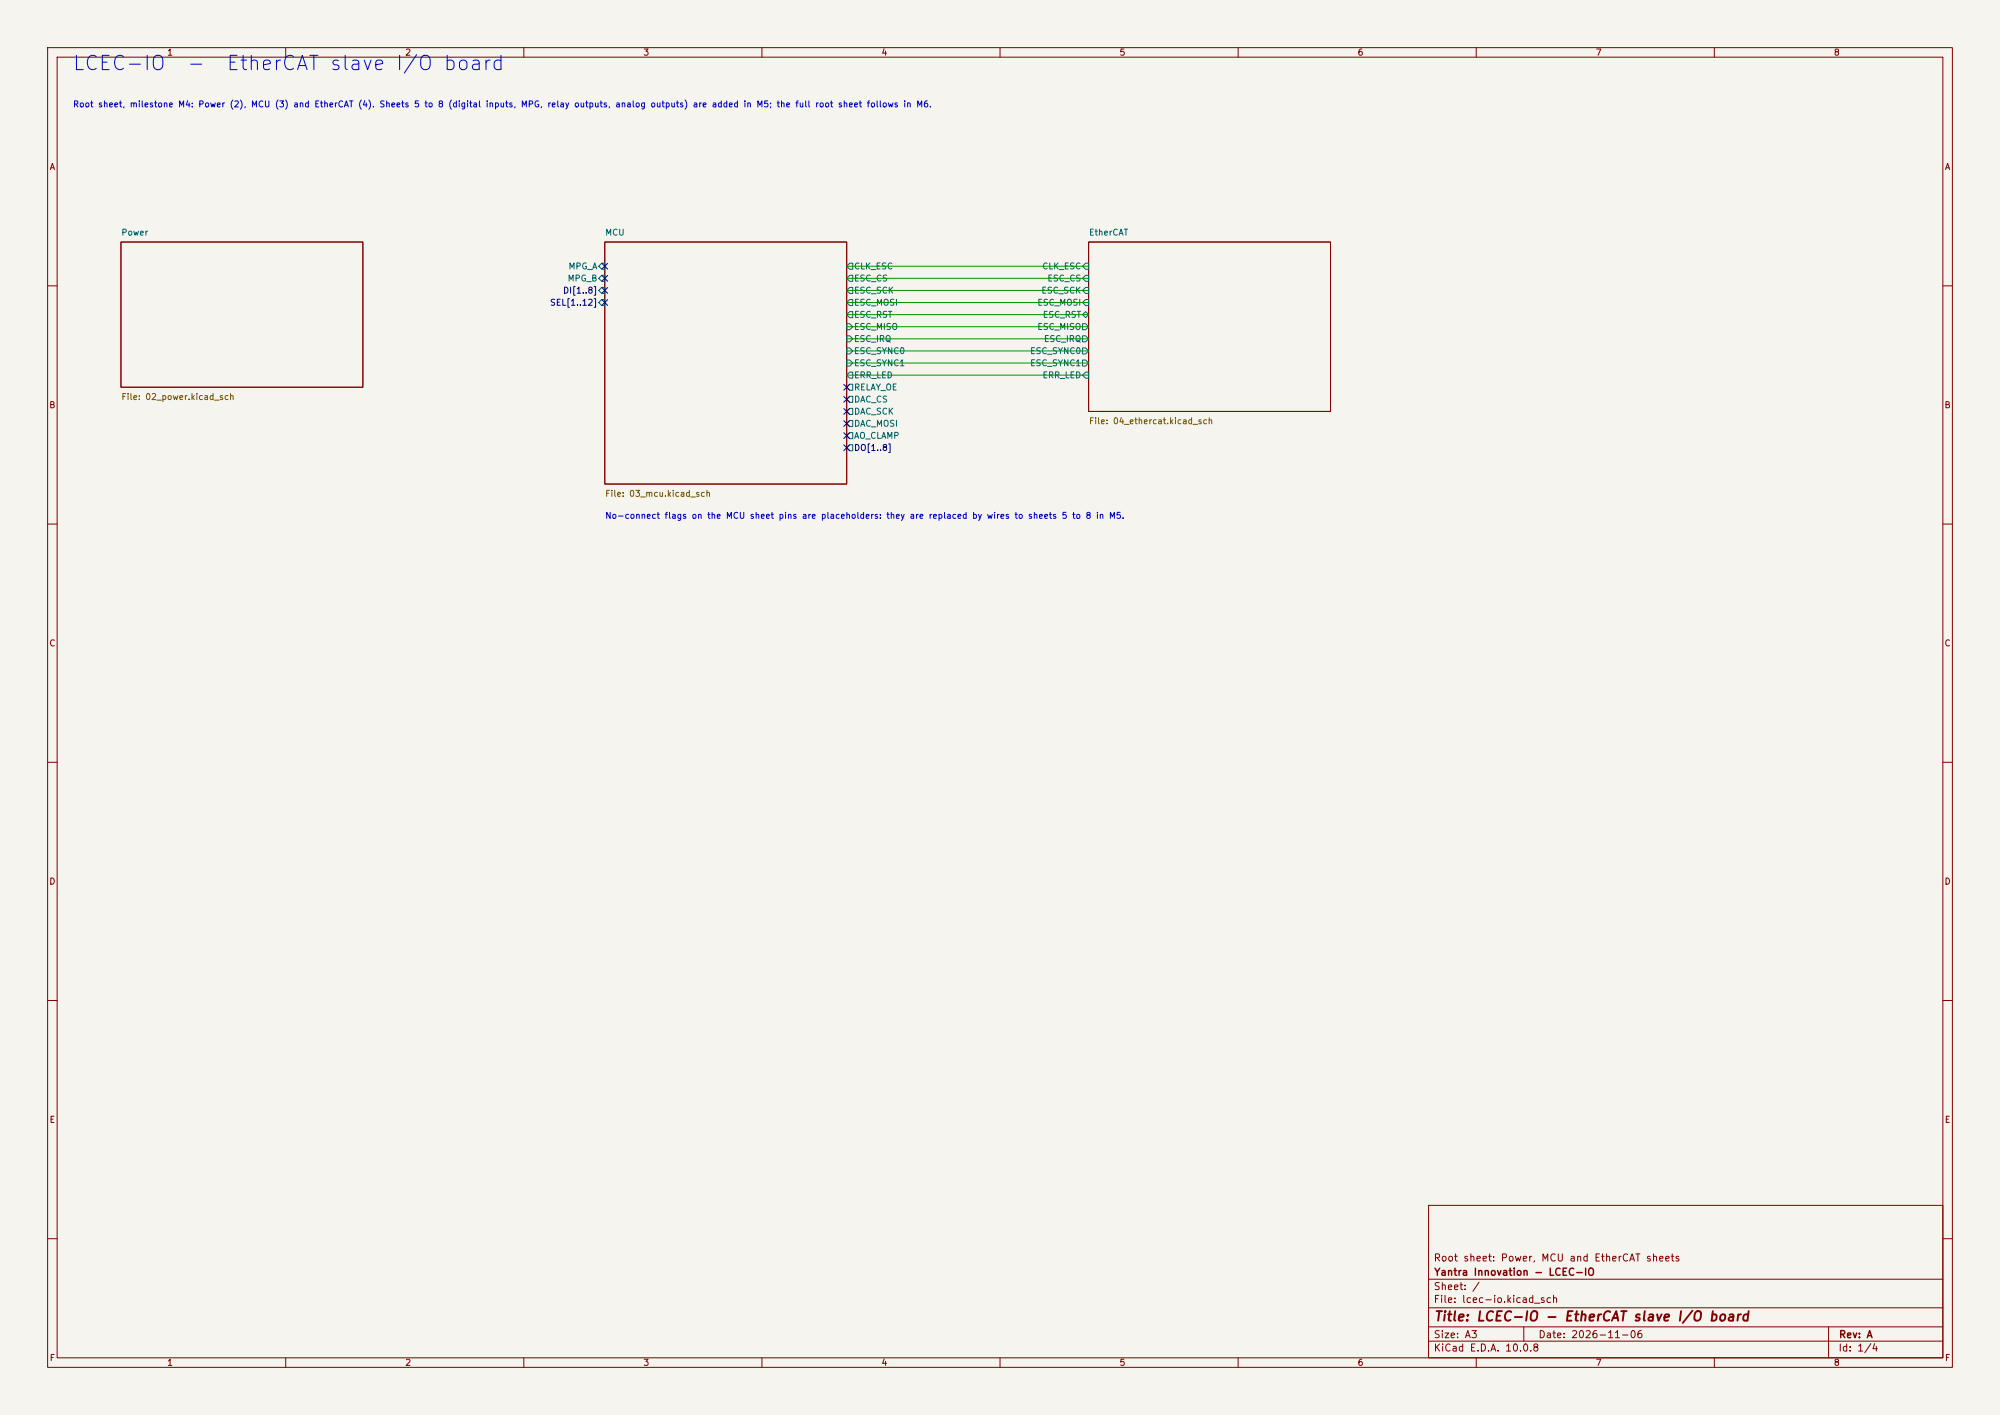
[picture p29: page 1]

LCEC-IO - EtherCAT slave I/O board

No-connect flags on the MCU sheet pins are placeholders: they are replaced by wires to sheets 5 to 8 in M5. Root sheet, milestone M4: Power (2), MCU (3) and EtherCAT (4). Sheets 5 to 8 (digital inputs, MPG, relay outputs, analog outputs) are added in M5; the full root sheet follows in M6.

EtherCAT File: 04_ethercat.kicad_sch Power File: 02_power.kicad_sch

Root sheet: Power, MCU and EtherCAT sheets
Yantra Innovation - LCEC-IO
Sheet: /
File: lcec-io.kicad_sch
Title: LCEC-IO - EtherCAT slave I/O board

Size: A3 | Rev: A | F Date: 2026-11-06
KiCad E.D.A. 10.0.8 | Id: 1/4

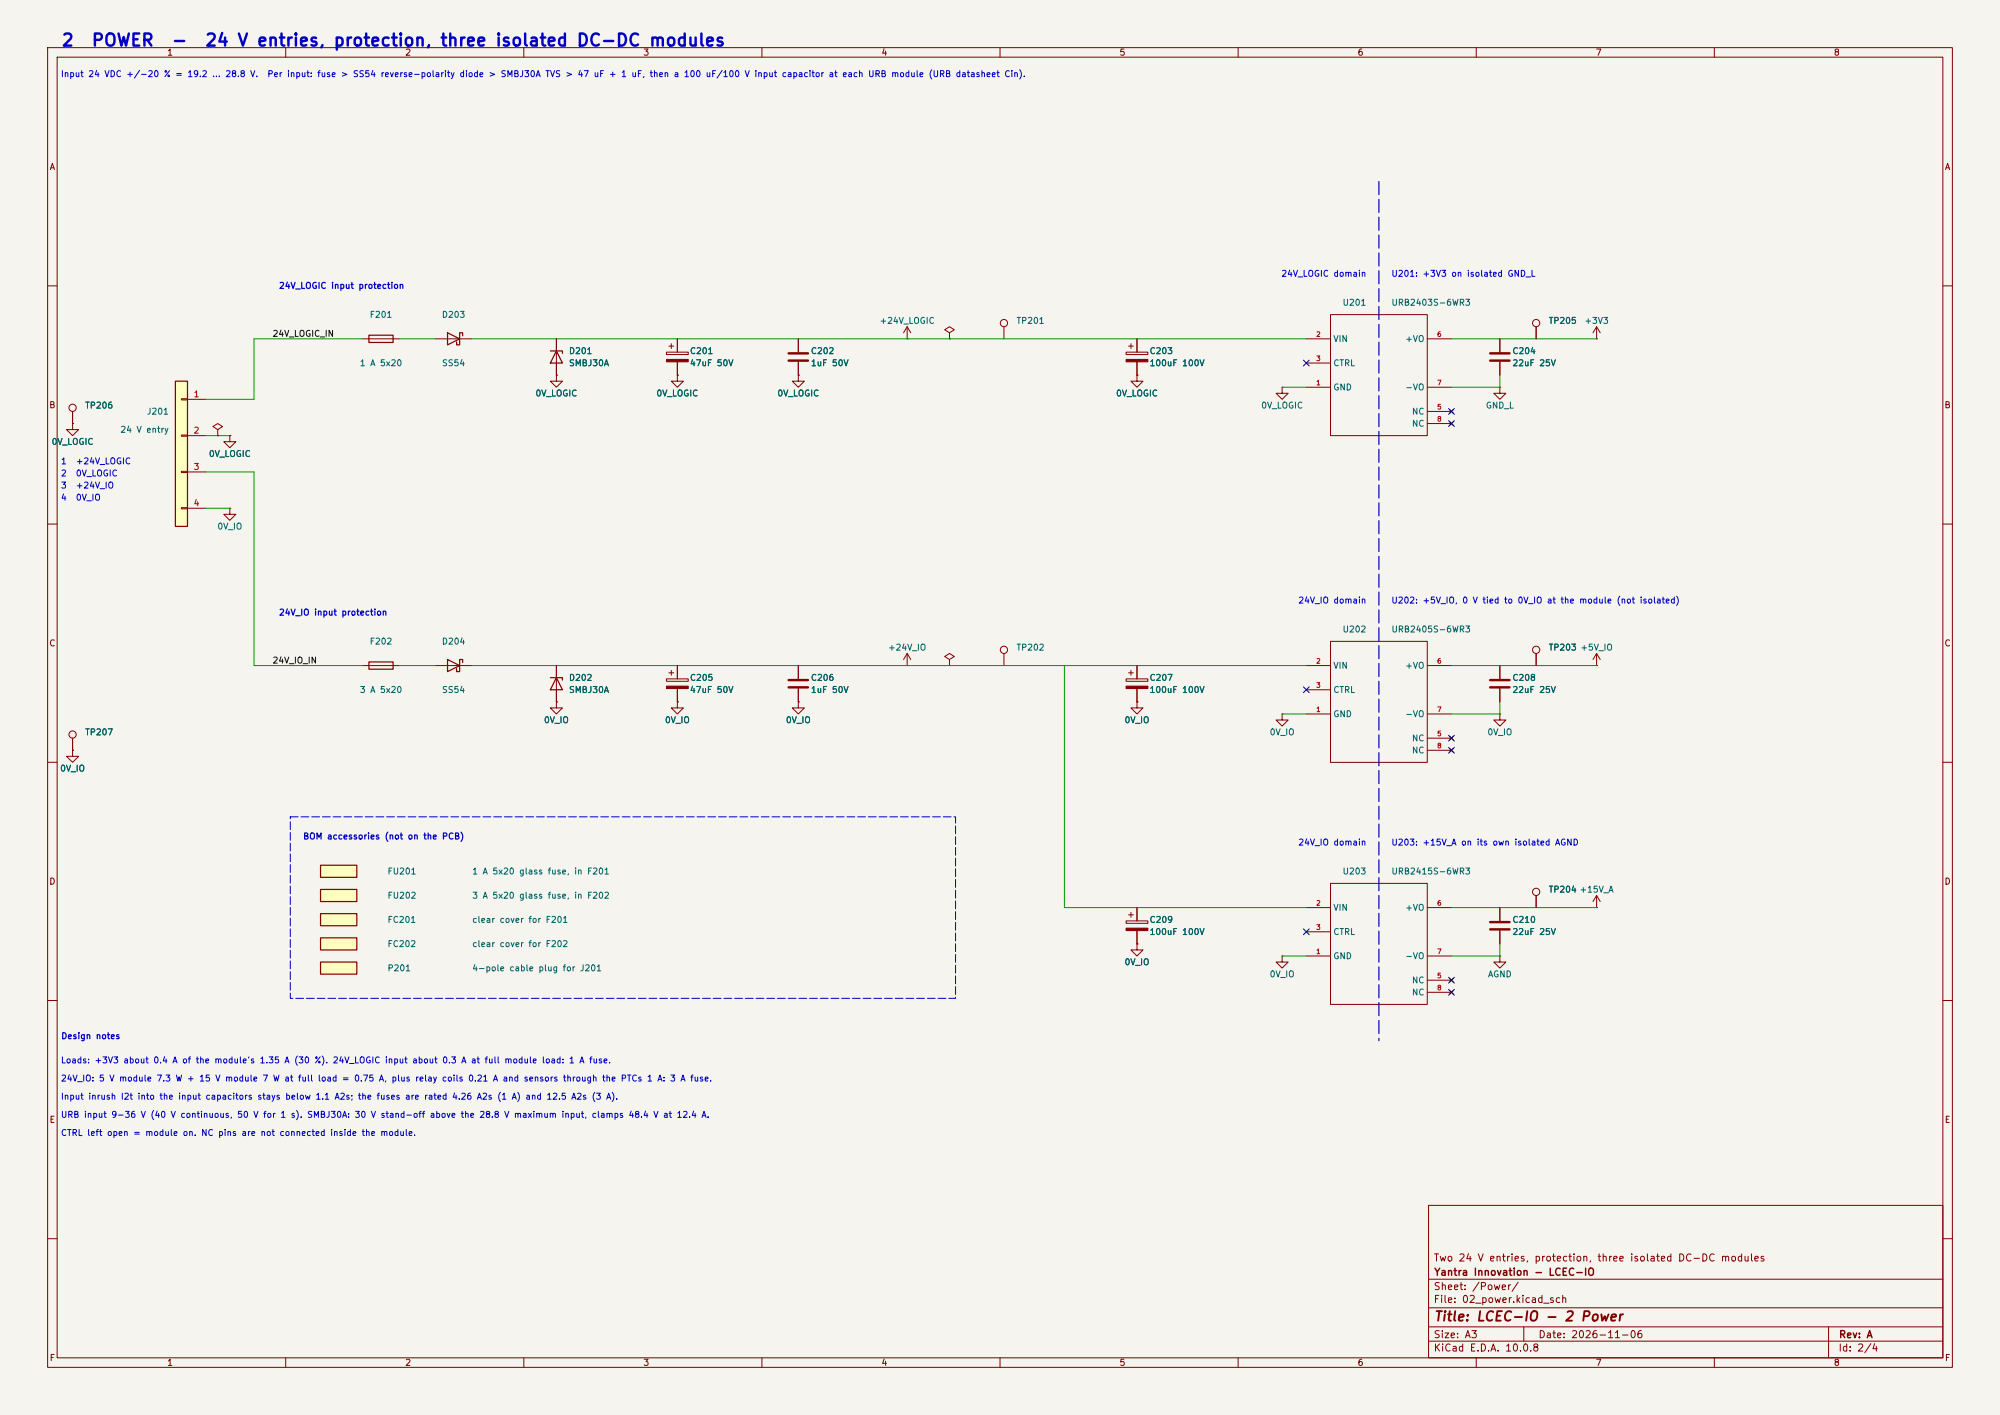
[picture p30: page 2]

2 POWER - 24 V entries, protection, three isolated DC-DC modules

Input 24 VDC +/-20 % = 19.2 ... 28.8 V. Per input: fuse > SS54 reverse-polarity diode > SMBJ30A TVS > 47 uF + 1 uF, then a 100 uF/100 V input capacitor at each URB module (URB datasheet Cin).

U202: +5V_IO, 0 V tied to 0V_IO at the module (not isolated)

24V_IO: 5 V module 7.3 W + 15 V module 7 W at full load = 0.75 A, plus relay coils 0.21 A and sensors through the PTCs 1 A: 3 A fuse. BOM accessories (not on the PCB) URB input 9-36 V (40 V continuous, 50 V for 1 s). SMBJ30A: 30 V stand-off above the 28.8 V maximum input, clamps 48.4 V at 12.4 A.

Loads: +3V3 about 0.4 A of the module's 1.35 A (30 %). 24V_LOGIC input about 0.3 A at full module load: 1 A fuse. CTRL left open = module on. NC pins are not connected inside the module.

Input inrush I2t into the input capacitors stays below 1.1 A2s; the fuses are rated 4.26 A2s (1 A) and 12.5 A2s (3 A).

Two 24 V entries, protection, three isolated DC-DC modules
Yantra Innovation - LCEC-IO
Sheet: /Power/
File: 02_power.kicad_sch
Title: LCEC-IO - 2 Power

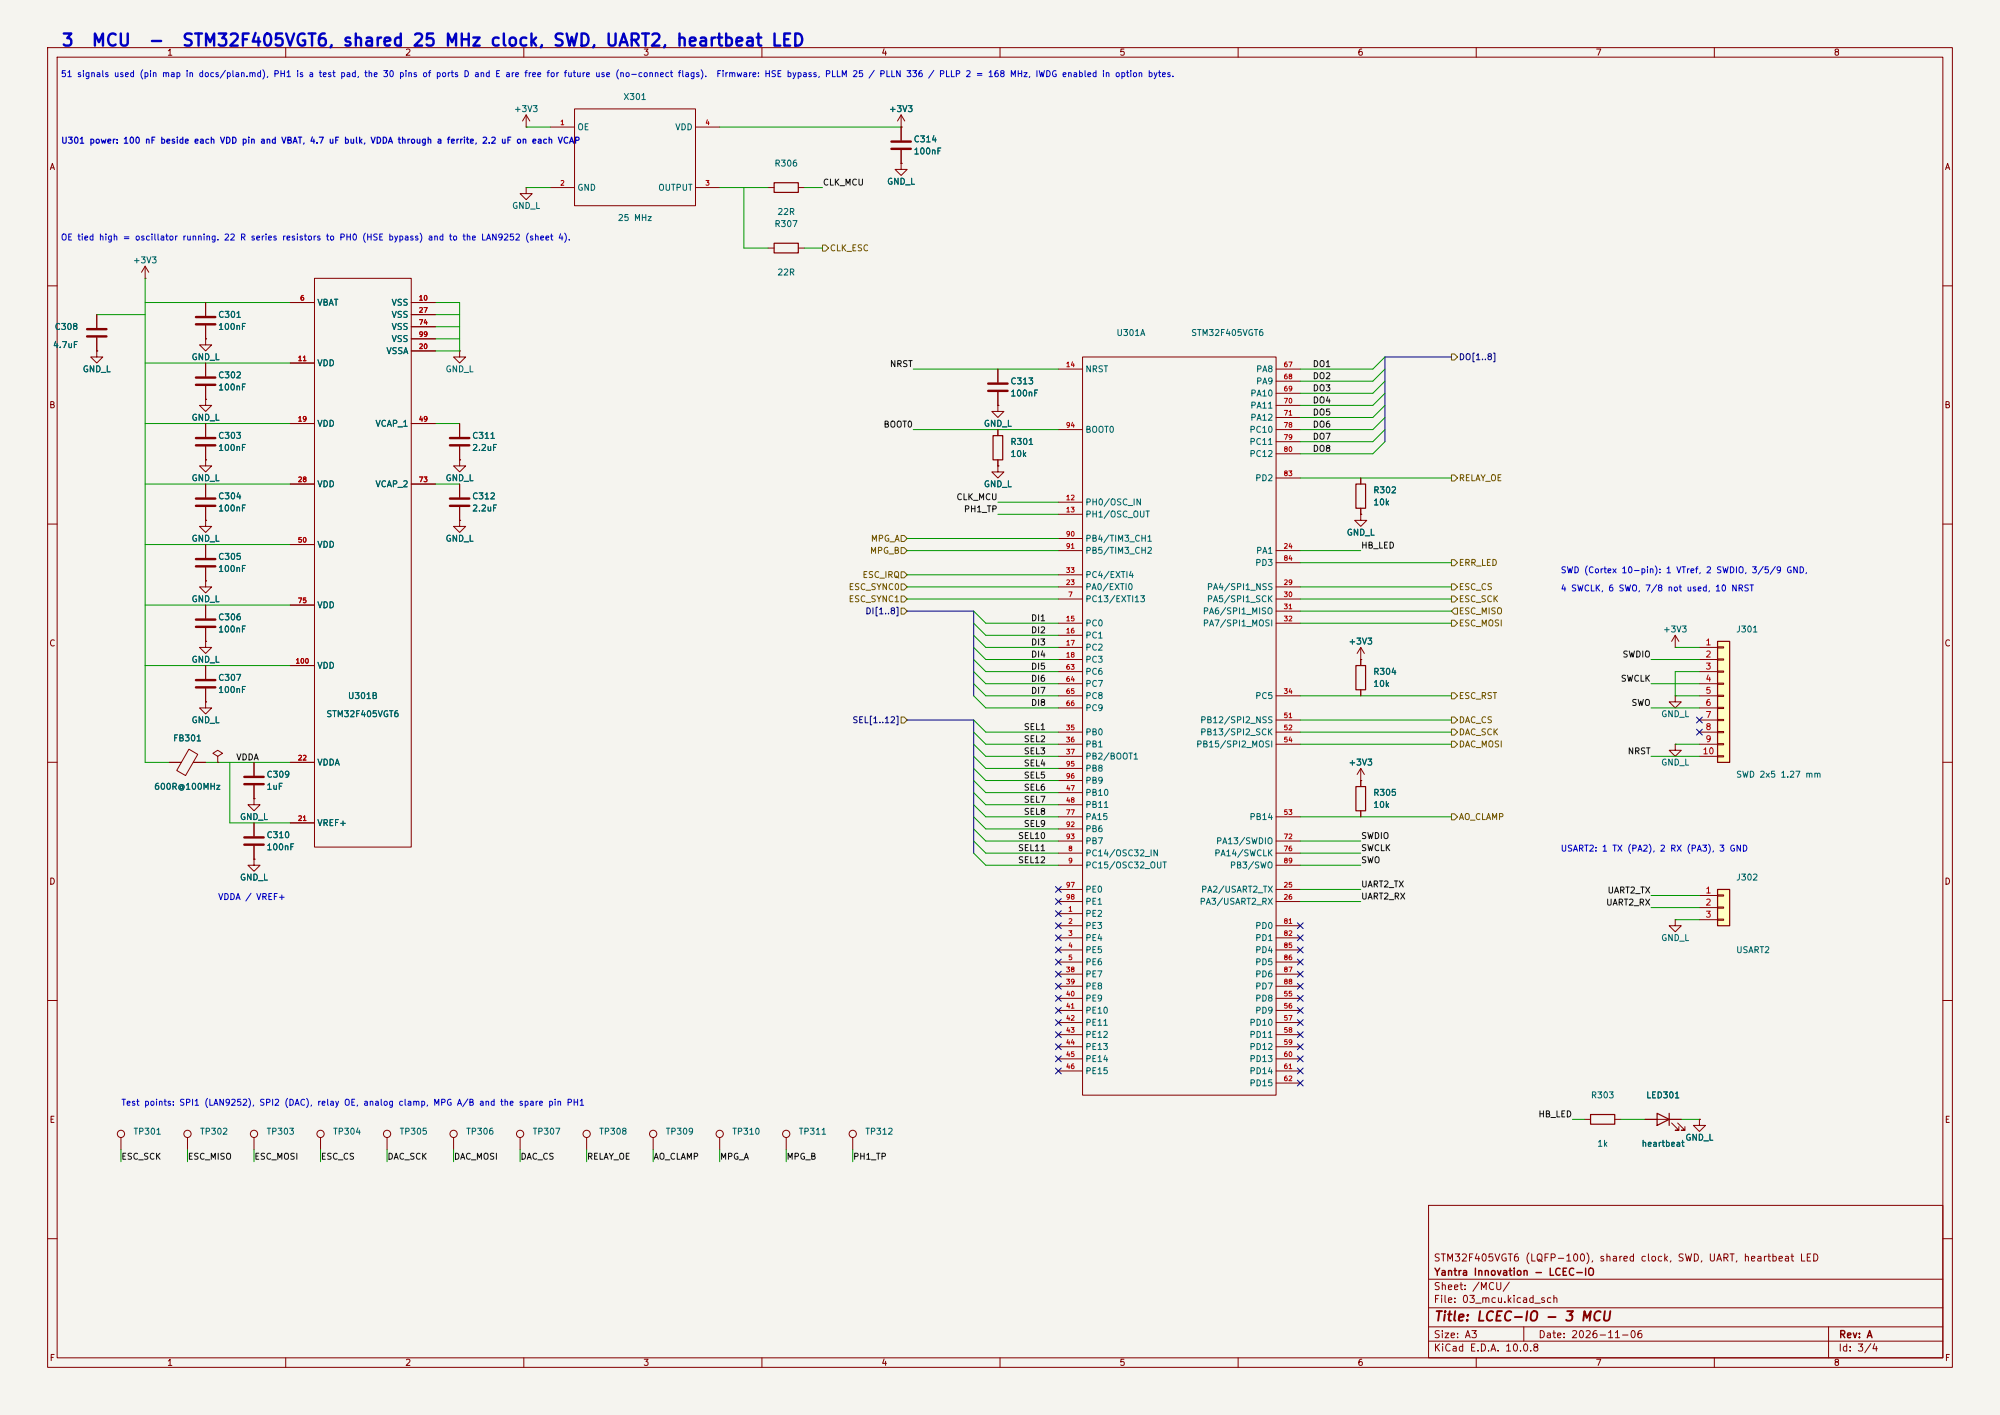
[picture p31: page 3]

3 MCU - STM32F405VGT6, shared 25 MHz clock, SWD, UART2, heartbeat LED

51 signals used (pin map in docs/plan.md), PH1 is a test pad, the 30 pins of ports D and E are free for future use (no-connect flags). Firmware: HSE bypass, PLLM 25 / PLLN 336 / PLLP 2 = 168 MHz, IWDG enabled in option bytes.
100nF GND_LC301
10k GND_LC313

4 SWCLK, 6 SWO, 7/8 not used, 10 NRST SWD (Cortex 10-pin): 1 VTref, 2 SWDIO, 3/5/9 GND, U301 power: 100 nF beside each VDD pin and VBAT, 4.7 uF bulk, VDDA through a ferrite, 2.2 uF on each VCAP

OE tied high = oscillator running. 22 R series resistors to PH0 (HSE bypass) and to the LAN9252 (sheet 4).

STM32F405VGT6 C303

Test points: SPI1 (LAN9252), SPI2 (DAC), relay OE, analog clamp, MPG A/B and the spare pin PH1

STM32F405VGT6 (LQFP-100), shared clock, SWD, UART, heartbeat LED
Yantra Innovation - LCEC-IO
Sheet: /MCU/
File: 03_mcu.kicad_sch
Title: LCEC-IO - 3 MCU

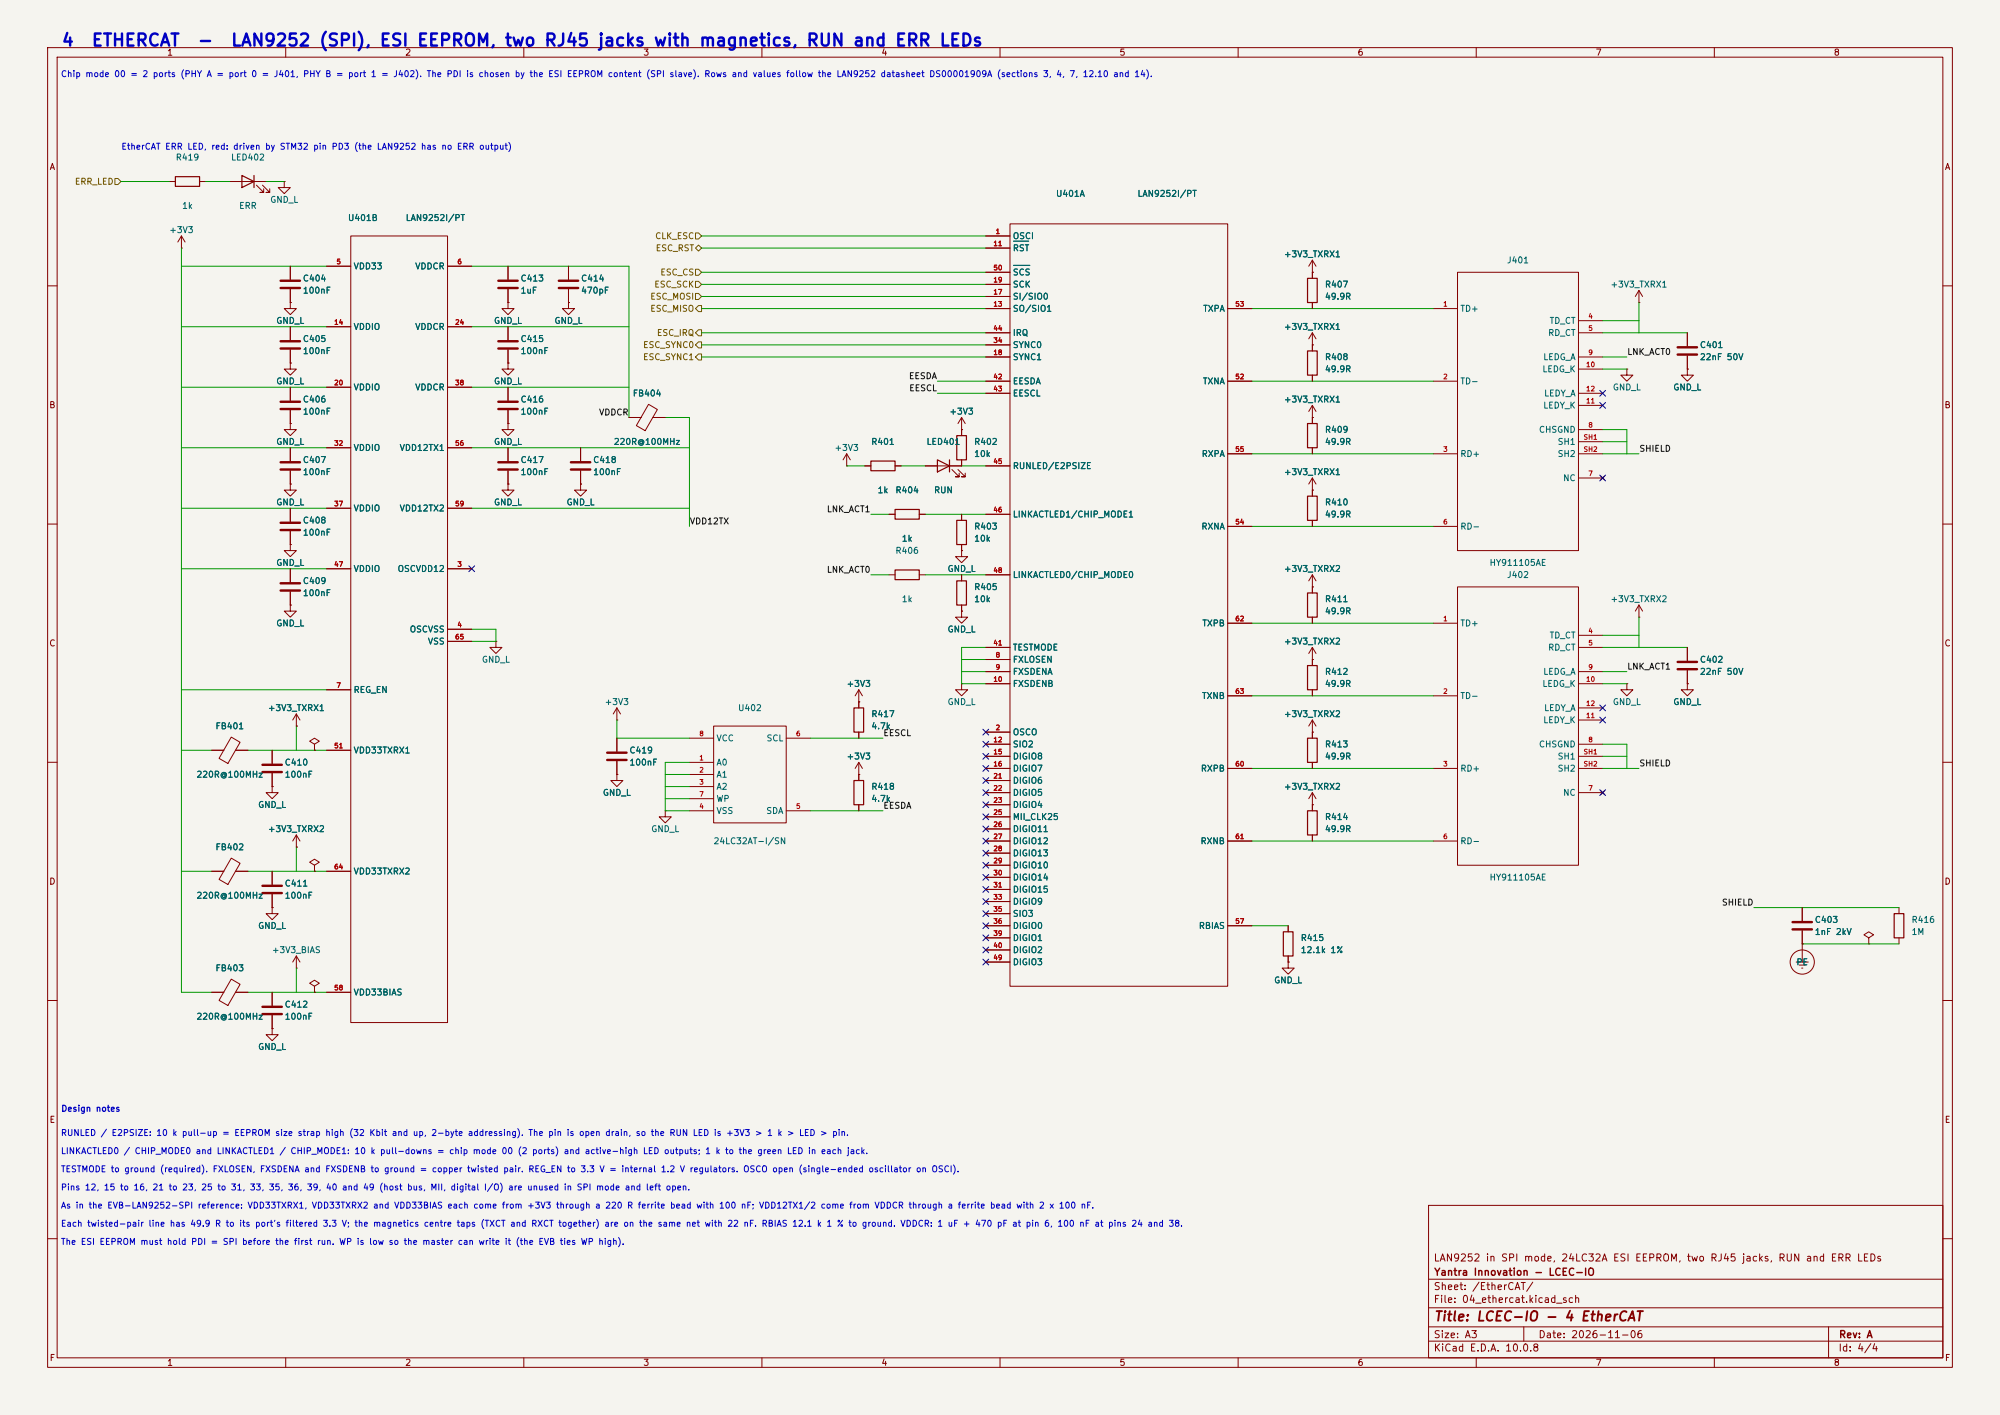
[picture p32: page 4]

4 ETHERCAT - LAN9252 (SPI), ESI EEPROM, two RJ45 jacks with magnetics, RUN and ERR LEDs

Chip mode 00 = 2 ports (PHY A = port 0 = J401, PHY B = port 1 = J402). The PDI is chosen by the ESI EEPROM content (SPI slave). Rows and values follow the LAN9252 datasheet DS00001909A (sections 3, 4, 7, 12.10 and 14).

EtherCAT ERR LED, red: driven by STM32 pin PD3 (the LAN9252 has no ERR output)

100nF C404 | | 470pF C413
100nF C406 100nF C405 100nF C406 | 100nF C416

LAN9252 in SPI mode, 24LC32A ESI EEPROM, two RJ45 jacks, RUN and ERR LEDs +3V3_BIAS

Design notes
The ESI EEPROM must hold PDI = SPI before the first run. WP is low so the master can write it (the EVB ties WP high). Pins 12, 15 to 16, 21 to 23, 25 to 31, 33, 35, 36, 39, 40 and 49 (host bus, MII, digital I/O) are unused in SPI mode and left open. TESTMODE to ground (required). FXLOSEN, FXSDENA and FXSDENB to ground = copper twisted pair. REG_EN to 3.3 V = internal 1.2 V regulators. OSCO open (single-ended oscillator on OSCI). LINKACTLED0 / CHIP_MODE0 and LINKACTLED1 / CHIP_MODE1: 10 k pull-downs = chip mode 00 (2 ports) and active-high LED outputs; 1 k to the green LED in each jack. As in the EVB-LAN9252-SPI reference: VDD33TXRX1, VDD33TXRX2 and VDD33BIAS each come from +3V3 through a 220 R ferrite bead with 100 nF; VDD12TX1/2 come from VDDCR through a ferrite bead with 2 x 100 nF. Each twisted-pair line has 49.9 R to its port's filtered 3.3 V; the magnetics centre taps (TXCT and RXCT together) are on the same net with 22 nF. RBIAS 12.1 k 1 % to ground. VDDCR: 1 uF + 470 pF at pin 6, 100 nF at pins 24 and 38. RUNLED / E2PSIZE: 10 k pull-up = EEPROM size strap high (32 Kbit and up, 2-byte addressing). The pin is open drain, so the RUN LED is +3V3 > 1 k > LED > pin.

Yantra Innovation - LCEC-IO
Sheet: /EtherCAT/
File: 04_ethercat.kicad_sch
Title: LCEC-IO - 4 EtherCAT
