yi-aditya/LCEC-IO/hardware/02_power.kicad_sch

## KiCad design hardware/02_power.kicad_sch (2026-11-06)

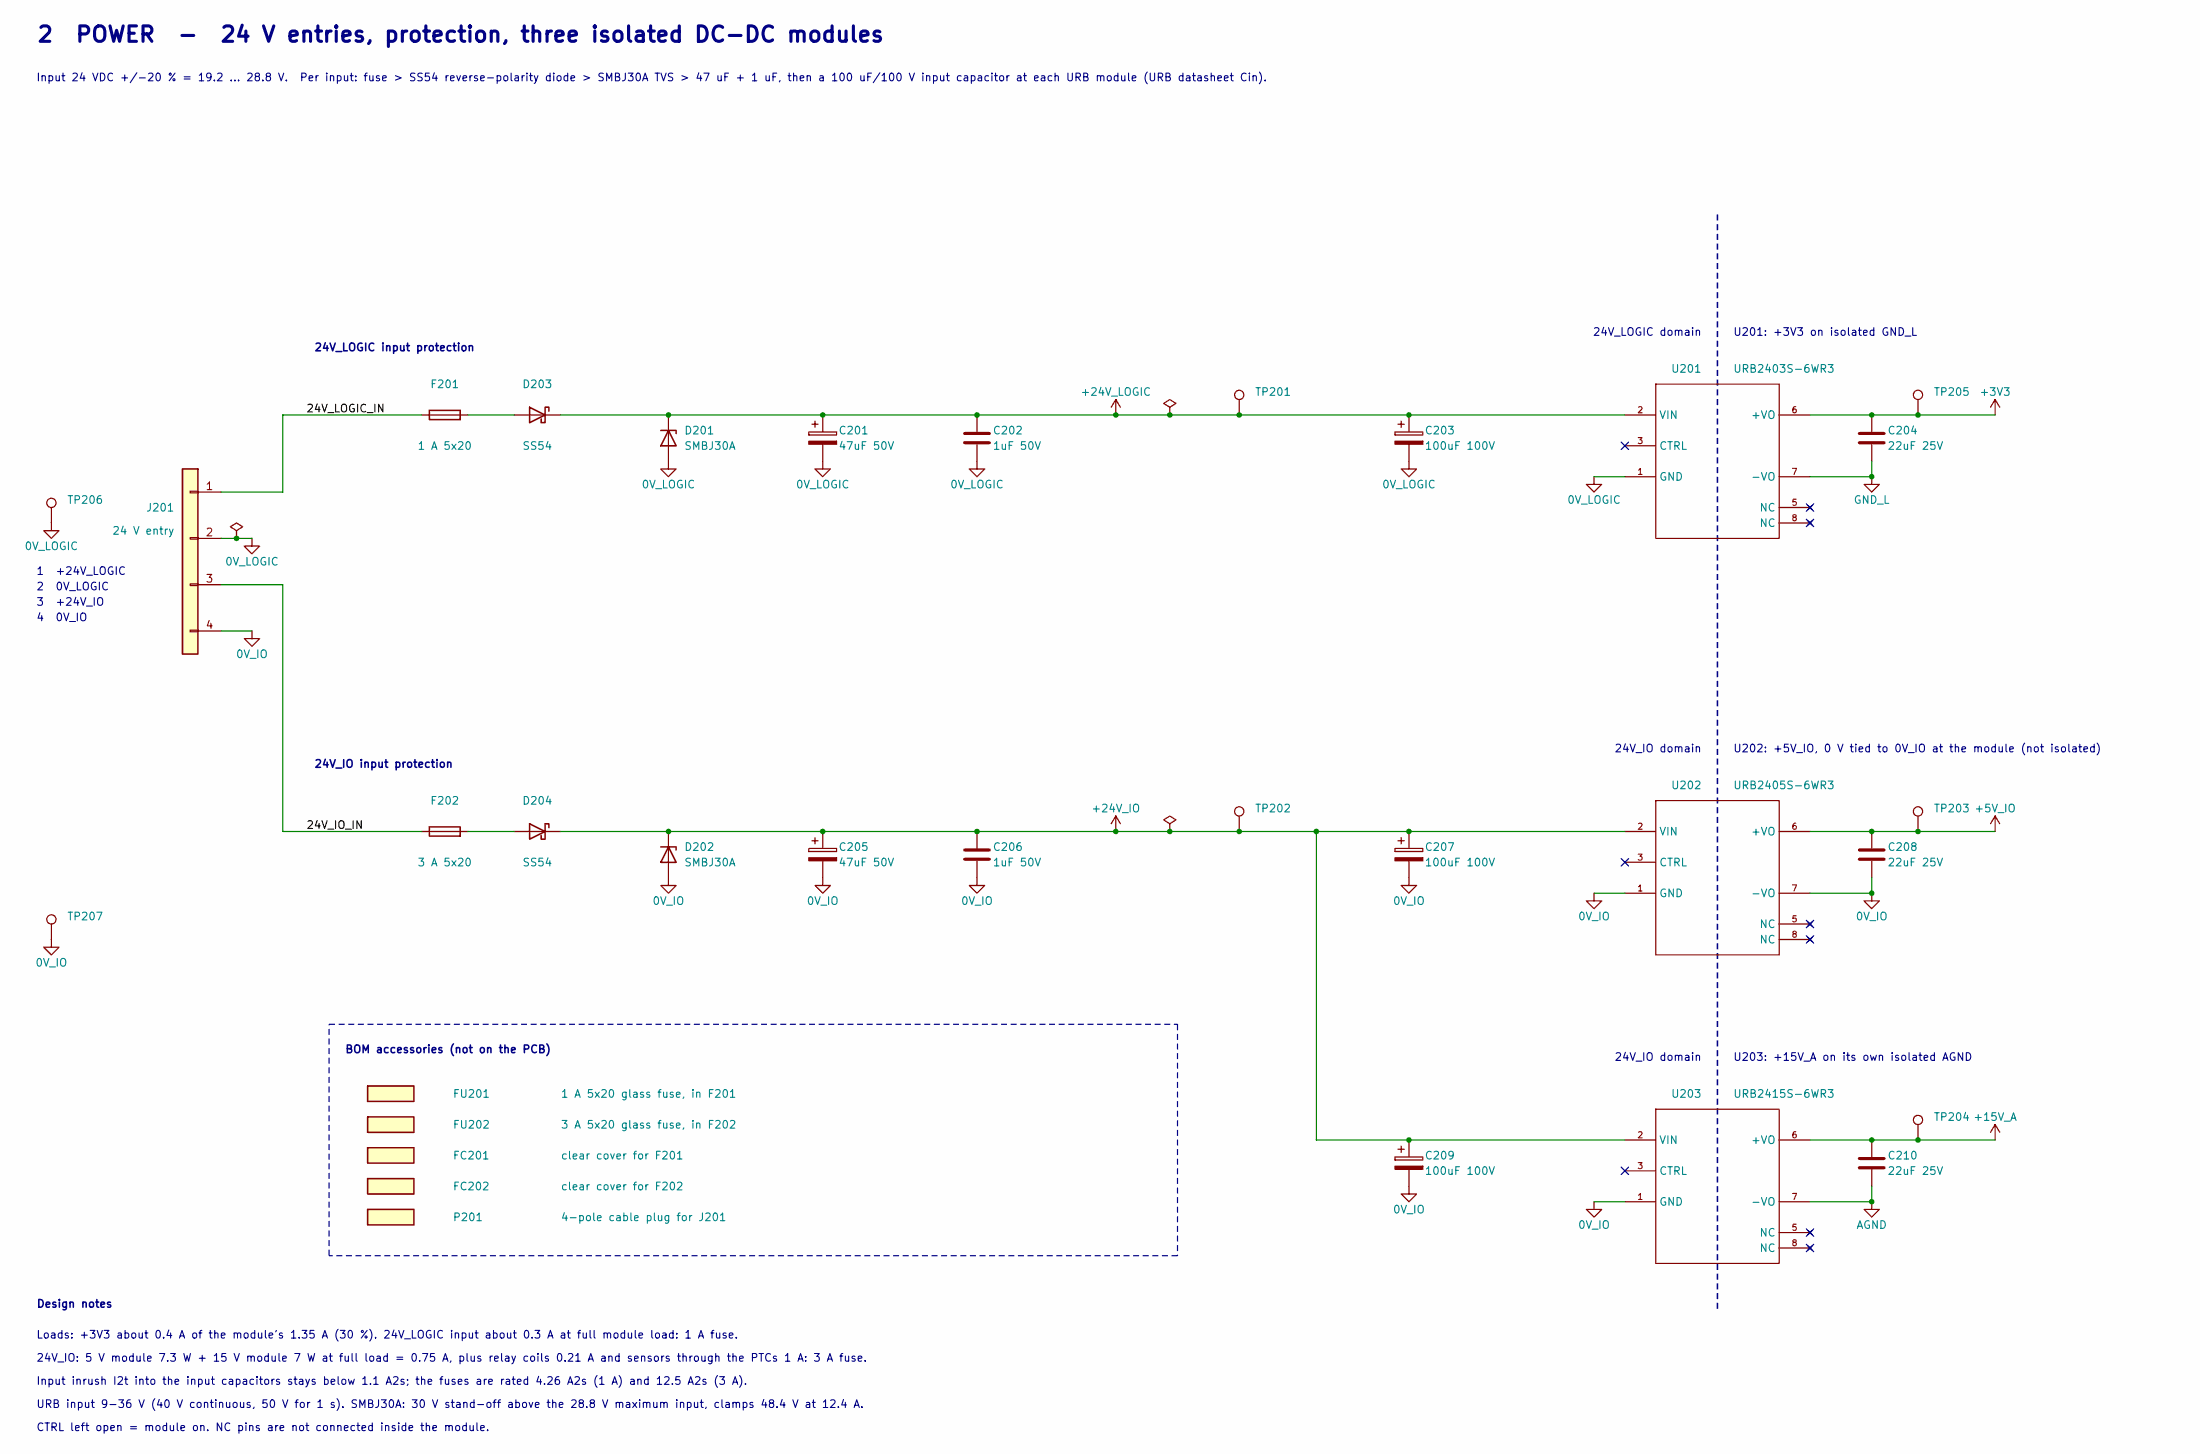
[picture p36: schematic 02_power.kicad_sch]

Parts:
C201, C205: 47uF 50V; CAP-SMD_BD6.3-L6.6-W6.6-LS7.2-FD; MPN RVT1H470M0607 47UF 50V; LCSC C970679
C202, C206: 1uF 50V; C_0805_2012Metric; MPN CC0805KKX7R9BB105; LCSC C91185
C203, C207, C209: 100uF 100V; CAP-TH_BD10.0-P5.00-D0.6-FD; MPN 100V100uF CD288; LCSC C2960285
C204, C208, C210: 22uF 25V; C_0805_2012Metric; MPN CL21A226MAQNNNE; LCSC C45783
D201, D202: SMBJ30A; SMB_L4.4-W3.6-LS5.4-RD; MPN SMBJ30A; LCSC C83851
D203, D204: SS54; SMA_L4.4-W2.8-LS5.4-R-RD; MPN SS54; LCSC C22452
F201: 1 A 5x20; 64600001003; MPN 64600001003; LCSC C206887
F202: 3 A 5x20; 64600001003; MPN 64600001003; LCSC C206887
FC201: clear cover for F201; MPN 64800001009; LCSC C187509
FC202: clear cover for F202; MPN 64800001009; LCSC C187509
FU201: 1 A 5x20 glass fuse, in F201; MPN 5F.1000210000R1; LCSC C3116
FU202: 3 A 5x20 glass fuse, in F202; MPN 5G.3000210000S1; LCSC C3118
J201: 24 V entry; CONN-TH_4P-P5.08_KF2EDGR-5.08-4P; MPN KF2EDGR-5.08-4P; LCSC C441206
P201: 4-pole cable plug for J201; MPN KF2EDGK-5.08-4P-AA; LCSC C440882
TP201: +24V_LOGIC; TestPoint_Pad_D2.0mm; LCSC n/a (bare pad)
TP202: +24V_IO; TestPoint_Pad_D2.0mm; LCSC n/a (bare pad)
TP203: +5V_IO; TestPoint_Pad_D2.0mm; LCSC n/a (bare pad)
TP204: +15V_A; TestPoint_Pad_D2.0mm; LCSC n/a (bare pad)
TP205: +3V3; TestPoint_Pad_D2.0mm; LCSC n/a (bare pad)
TP206: 0V_LOGIC; TestPoint_Pad_D2.0mm; LCSC n/a (bare pad)
TP207: 0V_IO; TestPoint_Pad_D2.0mm; LCSC n/a (bare pad)
U201: URB2403S-6WR3; PWRM-TH_URBXXXXS-6WR3_1; MPN URB2403S-6WR3; LCSC C5369843
U202: URB2405S-6WR3; PWRM-TH_YLPTEC_URXXXXXS-6WR3; MPN URB2405S-6WR3; LCSC C3031185
U203: URB2415S-6WR3; PWRM-TH_URBXXXXS-6WR3; MPN URB2415S-6WR3; LCSC C5369844

Connections:
0V_IO: C205.2, C206.2, C207.2, C208.2, C209.2, D202.2 (A), J201.4, TP207.1, U202.1 (GND), U202.7 (-VO), U203.1 (GND)
0V_LOGIC: C201.2, C202.2, C203.2, D201.2 (A), J201.2, TP206.1, U201.1 (GND)
24V_IO_IN: F202.1, J201.3
24V_LOGIC_IN: F201.1, J201.1
+3V3: C204.1, TP205.1, U201.6 (+VO)
+5V_IO: C208.1, TP203.1, U202.6 (+VO)
+15V_A: C210.1, TP204.1, U203.6 (+VO)
+24V_IO: C205.1, C206.1, C207.1, C209.1, D202.1 (K), D204.2 (K), TP202.1, U202.2 (VIN), U203.2 (VIN)
+24V_LOGIC: C201.1, C202.1, C203.1, D201.1 (K), D203.2 (K), TP201.1, U201.2 (VIN)
AGND: C210.2, U203.7 (-VO)
GND_L: C204.2, U201.7 (-VO)
unnamed: D203.1 (A), F201.2
unnamed: D204.1 (A), F202.2

Notes on the sheet:
2 POWER - 24 V entries, protection, three isolated DC-DC modules
2 0V_LOGIC
24V_IO domain
U203: +15V_A on its own isolated AGND
24V_LOGIC domain
1 +24V_LOGIC
4 0V_IO
3 +24V_IO
Loads: +3V3 about 0.4 A of the module's 1.35 A (30 %). 24V_LOGIC input about 0.3 A at full module load: 1 A fuse.
24V_LOGIC input protection
CTRL left open = module on. NC pins are not connected inside the module.
24V_IO input protection
Input inrush I2t into the input capacitors stays below 1.1 A2s; the fuses are rated 4.26 A2s (1 A) and 12.5 A2s (3 A).
24V_IO: 5 V module 7.3 W + 15 V module 7 W at full load = 0.75 A, plus relay coils 0.21 A and sensors through the PTCs 1 A: 3 A fuse.
Design notes
Input 24 VDC +/-20 % = 19.2 ... 28.8 V. Per input: fuse > SS54 reverse-polarity diode > SMBJ30A TVS > 47 uF + 1 uF, then a 100 uF/100 V input capacitor at each URB module (URB datasheet Cin).
U201: +3V3 on isolated GND_L
BOM accessories (not on the PCB)
U202: +5V_IO, 0 V tied to 0V_IO at the module (not isolated)
URB input 9-36 V (40 V continuous, 50 V for 1 s). SMBJ30A: 30 V stand-off above the 28.8 V maximum input, clamps 48.4 V at 12.4 A.
