yi-aditya/LCEC-IO/hardware/03_mcu.kicad_sch

## KiCad design hardware/03_mcu.kicad_sch (2026-11-06)

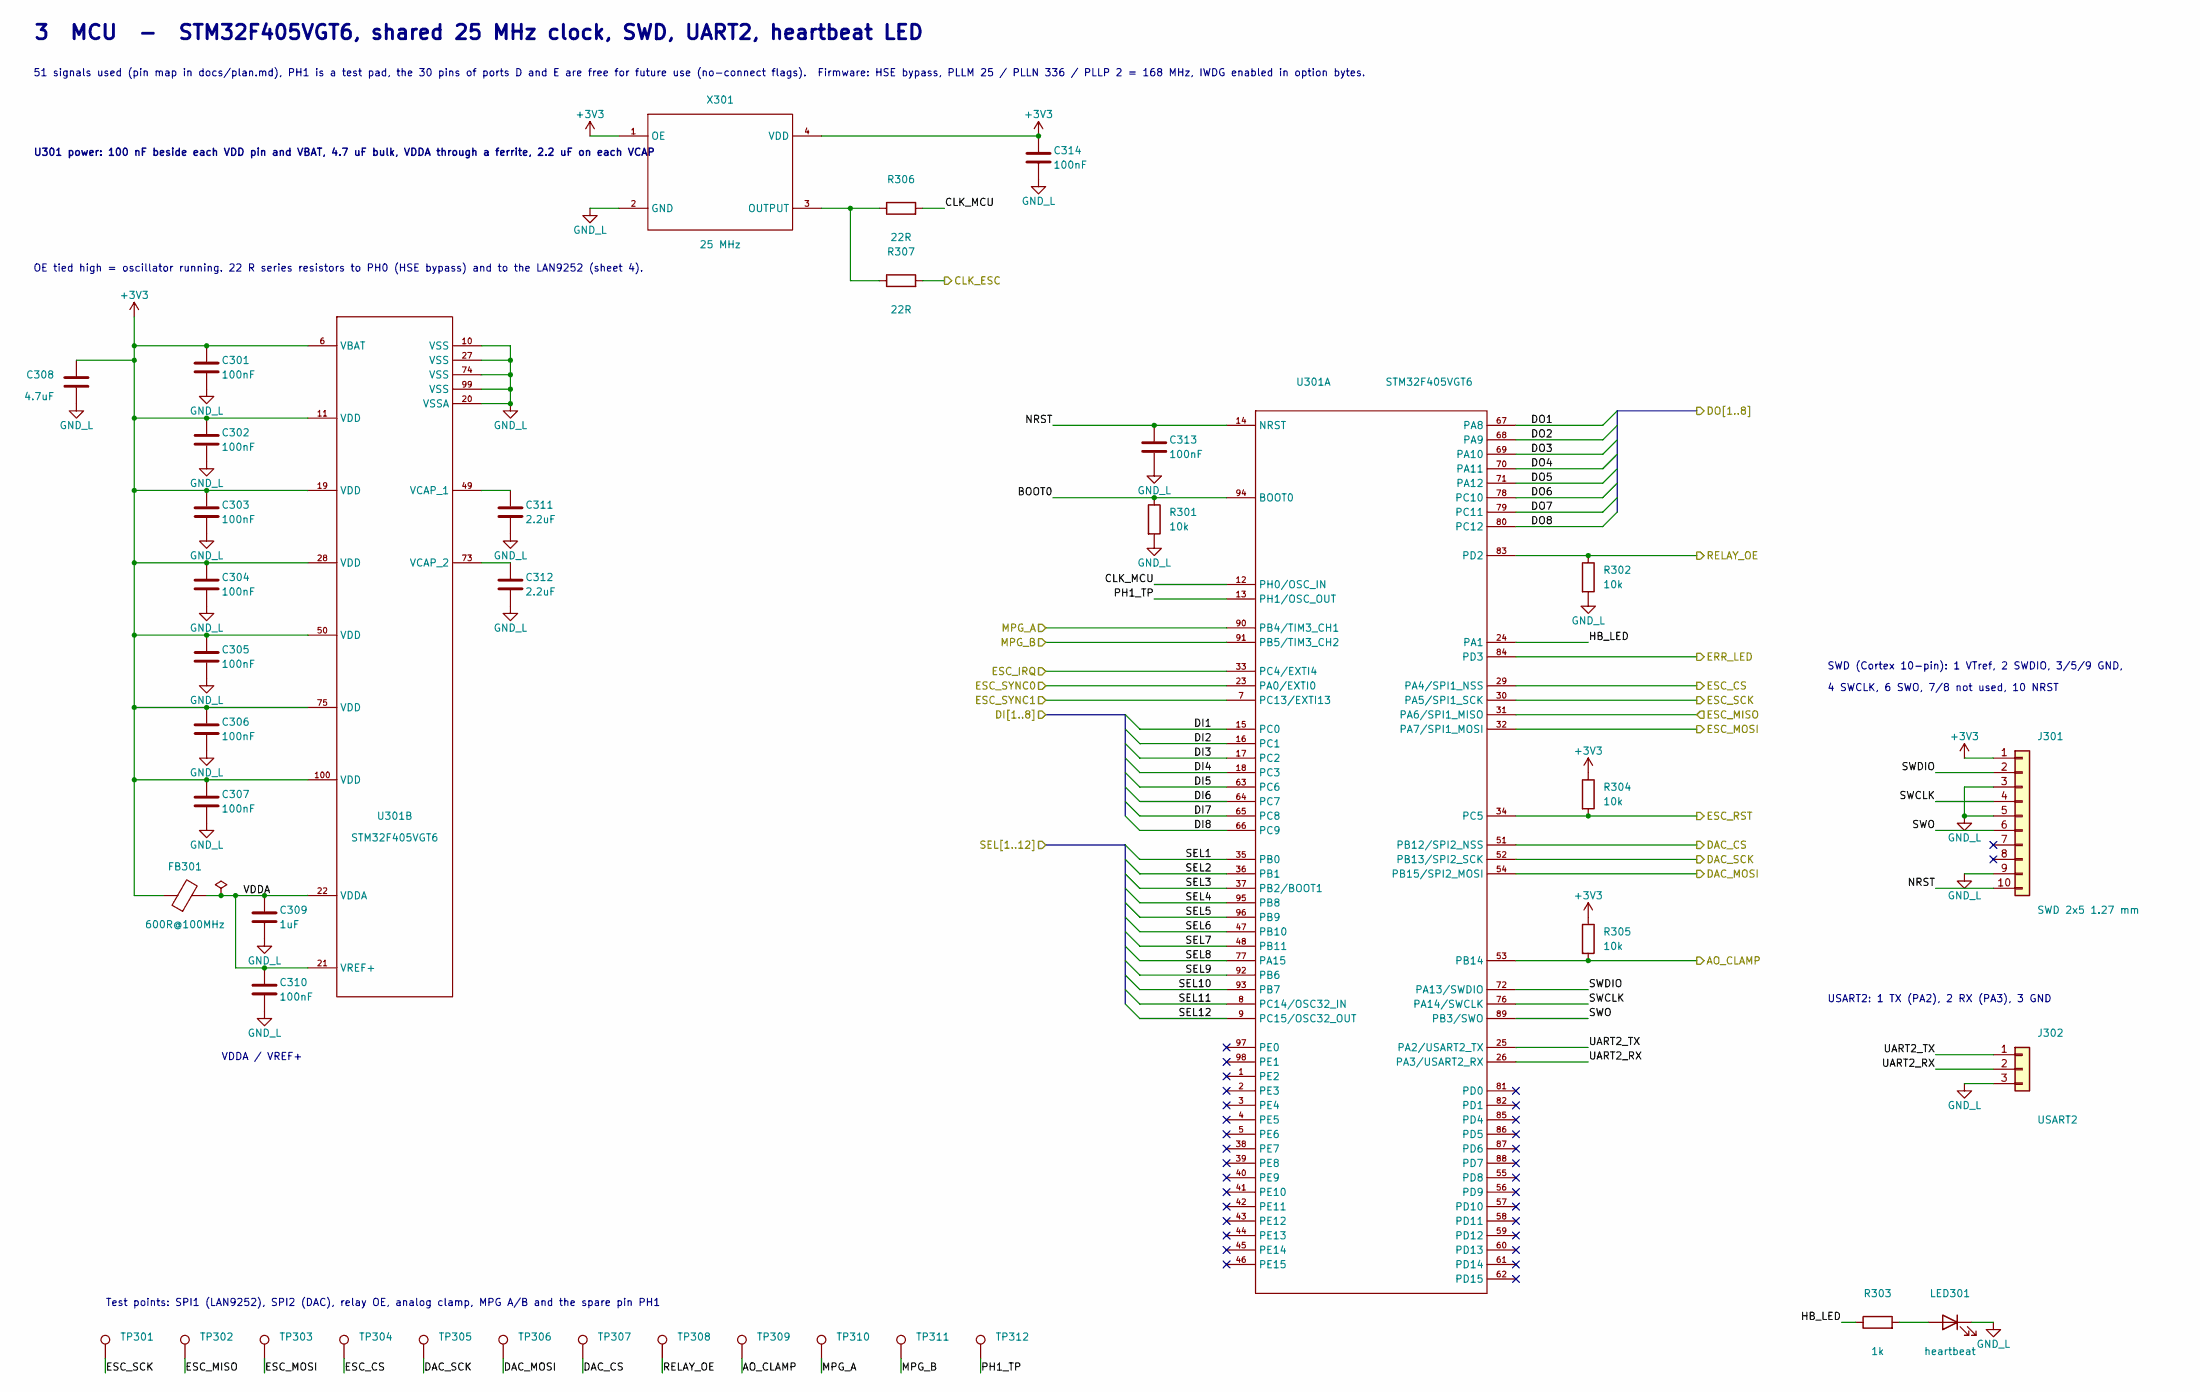
[picture p37: schematic 03_mcu.kicad_sch]

Parts:
C301, C302, C303, C304, C305, C306, C307, C310, C313, C314: 100nF; C_0603_1608Metric; MPN CL10B104KB8NNNC; LCSC C1591
C308: 4.7uF; C_0603_1608Metric; MPN CL10A475KO8NNNC; LCSC C19666
C309: 1uF; C_0603_1608Metric; MPN CC0603KRX7R9BB105; LCSC C559769
C311, C312: 2.2uF; C_0603_1608Metric; MPN CL10A225KO8NNNC; LCSC C23630
FB301: 600R@100MHz; L_0603_1608Metric; MPN BLM18AG601SN1D; LCSC C19330
J301: SWD 2x5 1.27 mm; HDR-SMD_10P-P1.27-V-M-R2-C5-LS5.3; MPN PZ127-2-05-S; LCSC C3975188
J302: USART2; HDR-TH_3P-P2.54-V-M_PZ254V-11-03P; MPN PZ254V-11-03P; LCSC C2937625
LED301: heartbeat; LED_0603_1608Metric; MPN KT-0603Y; LCSC C2287
R301, R302, R304, R305: 10k; R_0603_1608Metric; MPN 0603WAF1002T5E; LCSC C25804
R303: 1k; R_0603_1608Metric; MPN 0603WAF1001T5E; LCSC C21190
R306, R307: 22R; R_0603_1608Metric; MPN 0603WAF220JT5E; LCSC C23345
TP301: ESC_SCK; TestPoint_Pad_D2.0mm; LCSC n/a (bare pad)
TP302: ESC_MISO; TestPoint_Pad_D2.0mm; LCSC n/a (bare pad)
TP303: ESC_MOSI; TestPoint_Pad_D2.0mm; LCSC n/a (bare pad)
TP304: ESC_CS; TestPoint_Pad_D2.0mm; LCSC n/a (bare pad)
TP305: DAC_SCK; TestPoint_Pad_D2.0mm; LCSC n/a (bare pad)
TP306: DAC_MOSI; TestPoint_Pad_D2.0mm; LCSC n/a (bare pad)
TP307: DAC_CS; TestPoint_Pad_D2.0mm; LCSC n/a (bare pad)
TP308: RELAY_OE; TestPoint_Pad_D2.0mm; LCSC n/a (bare pad)
TP309: AO_CLAMP; TestPoint_Pad_D2.0mm; LCSC n/a (bare pad)
TP310: MPG_A; TestPoint_Pad_D2.0mm; LCSC n/a (bare pad)
TP311: MPG_B; TestPoint_Pad_D2.0mm; LCSC n/a (bare pad)
TP312: PH1_TP; TestPoint_Pad_D2.0mm; LCSC n/a (bare pad)
U301: STM32F405VGT6; LQFP-100_L14.0-W14.0-P0.50-LS16.0-BL; MPN STM32F405VGT6; LCSC C56621
X301: 25 MHz; OSC-SMD_4P-L3.2-W2.5-BL_KYOCERA_KC3225A; MPN ECS-3225MVQ-250-CN-TR; LCSC C2595919

Connections:
+3V3: C301.1, C302.1, C303.1, C304.1, C305.1, C306.1, C307.1, C308.1, C314.1, FB301.1, J301.1, R304.1, R305.1, U301.6 (VBAT), U301.11 (VDD), U301.19 (VDD), U301.28 (VDD), U301.50 (VDD), U301.75 (VDD), U301.100 (VDD), X301.1 (OE), X301.4 (VDD)
AO_CLAMP: R305.2, TP309.1, U301.53 (PB14)
BOOT0: R301.1, U301.94 (BOOT0)
CLK_ESC: R307.2
CLK_MCU: R306.2, U301.12 (PH0/OSC_IN)
DAC_CS: TP307.1, U301.51 (PB12/SPI2_NSS)
DAC_MOSI: TP306.1, U301.54 (PB15/SPI2_MOSI)
DAC_SCK: TP305.1, U301.52 (PB13/SPI2_SCK)
DI1: U301.15 (PC0)
DI2: U301.16 (PC1)
DI3: U301.17 (PC2)
DI4: U301.18 (PC3)
DI5: U301.63 (PC6)
DI6: U301.64 (PC7)
DI7: U301.65 (PC8)
DI8: U301.66 (PC9)
DO1: U301.67 (PA8)
DO2: U301.68 (PA9)
DO3: U301.69 (PA10)
DO4: U301.70 (PA11)
DO5: U301.71 (PA12)
DO6: U301.78 (PC10)
DO7: U301.79 (PC11)
DO8: U301.80 (PC12)
ERR_LED: U301.84 (PD3)
ESC_CS: TP304.1, U301.29 (PA4/SPI1_NSS)
ESC_IRQ: U301.33 (PC4/EXTI4)
ESC_MISO: TP302.1, U301.31 (PA6/SPI1_MISO)
ESC_MOSI: TP303.1, U301.32 (PA7/SPI1_MOSI)
ESC_RST: R304.2, U301.34 (PC5)
ESC_SCK: TP301.1, U301.30 (PA5/SPI1_SCK)
ESC_SYNC0: U301.23 (PA0/EXTI0)
ESC_SYNC1: U301.7 (PC13/EXTI13)
GND_L: C301.2, C302.2, C303.2, C304.2, C305.2, C306.2, C307.2, C308.2, C309.2, C310.2, C311.2, C312.2, C313.2, C314.2, J301.3, J301.5, J301.9, J302.3, LED301.1 (K), R301.2, R302.2, U301.10 (VSS), U301.20 (VSSA), U301.27 (VSS), U301.74 (VSS), U301.99 (VSS), X301.2 (GND)
HB_LED: R303.1, U301.24 (PA1)
MPG_A: TP310.1, U301.90 (PB4/TIM3_CH1)
MPG_B: TP311.1, U301.91 (PB5/TIM3_CH2)
NRST: C313.1, J301.10, U301.14 (NRST)
unnamed: C311.1, U301.49 (VCAP_1)
unnamed: C312.1, U301.73 (VCAP_2)
unnamed: LED301.2 (A), R303.2
unnamed: R306.1, R307.1, X301.3 (OUTPUT)
PH1_TP: TP312.1, U301.13 (PH1/OSC_OUT)
RELAY_OE: R302.1, TP308.1, U301.83 (PD2)
SEL1: U301.35 (PB0)
SEL2: U301.36 (PB1)
SEL3: U301.37 (PB2/BOOT1)
SEL4: U301.95 (PB8)
SEL5: U301.96 (PB9)
SEL6: U301.47 (PB10)
SEL7: U301.48 (PB11)
SEL8: U301.77 (PA15)
SEL9: U301.92 (PB6)
SEL10: U301.93 (PB7)
SEL11: U301.8 (PC14/OSC32_IN)
SEL12: U301.9 (PC15/OSC32_OUT)
SWCLK: J301.4, U301.76 (PA14/SWCLK)
SWDIO: J301.2, U301.72 (PA13/SWDIO)
SWO: J301.6, U301.89 (PB3/SWO)
UART2_RX: J302.2, U301.26 (PA3/USART2_RX)
UART2_TX: J302.1, U301.25 (PA2/USART2_TX)
VDDA: C309.1, C310.1, FB301.2, U301.21 (VREF+), U301.22 (VDDA)

Notes on the sheet:
51 signals used (pin map in docs/plan.md), PH1 is a test pad, the 30 pins of ports D and E are free for future use (no-connect flags). Firmware: HSE bypass, PLLM 25 / PLLN 336 / PLLP 2 = 168 MHz, IWDG enabled in option bytes.
USART2: 1 TX (PA2), 2 RX (PA3), 3 GND
VDDA / VREF+
U301 power: 100 nF beside each VDD pin and VBAT, 4.7 uF bulk, VDDA through a ferrite, 2.2 uF on each VCAP
SWD (Cortex 10-pin): 1 VTref, 2 SWDIO, 3/5/9 GND,
Test points: SPI1 (LAN9252), SPI2 (DAC), relay OE, analog clamp, MPG A/B and the spare pin PH1
4 SWCLK, 6 SWO, 7/8 not used, 10 NRST
OE tied high = oscillator running. 22 R series resistors to PH0 (HSE bypass) and to the LAN9252 (sheet 4).
3 MCU - STM32F405VGT6, shared 25 MHz clock, SWD, UART2, heartbeat LED
