yi-aditya/LCEC-IO/hardware/04_ethercat.kicad_sch

## KiCad design hardware/04_ethercat.kicad_sch (2026-11-06)

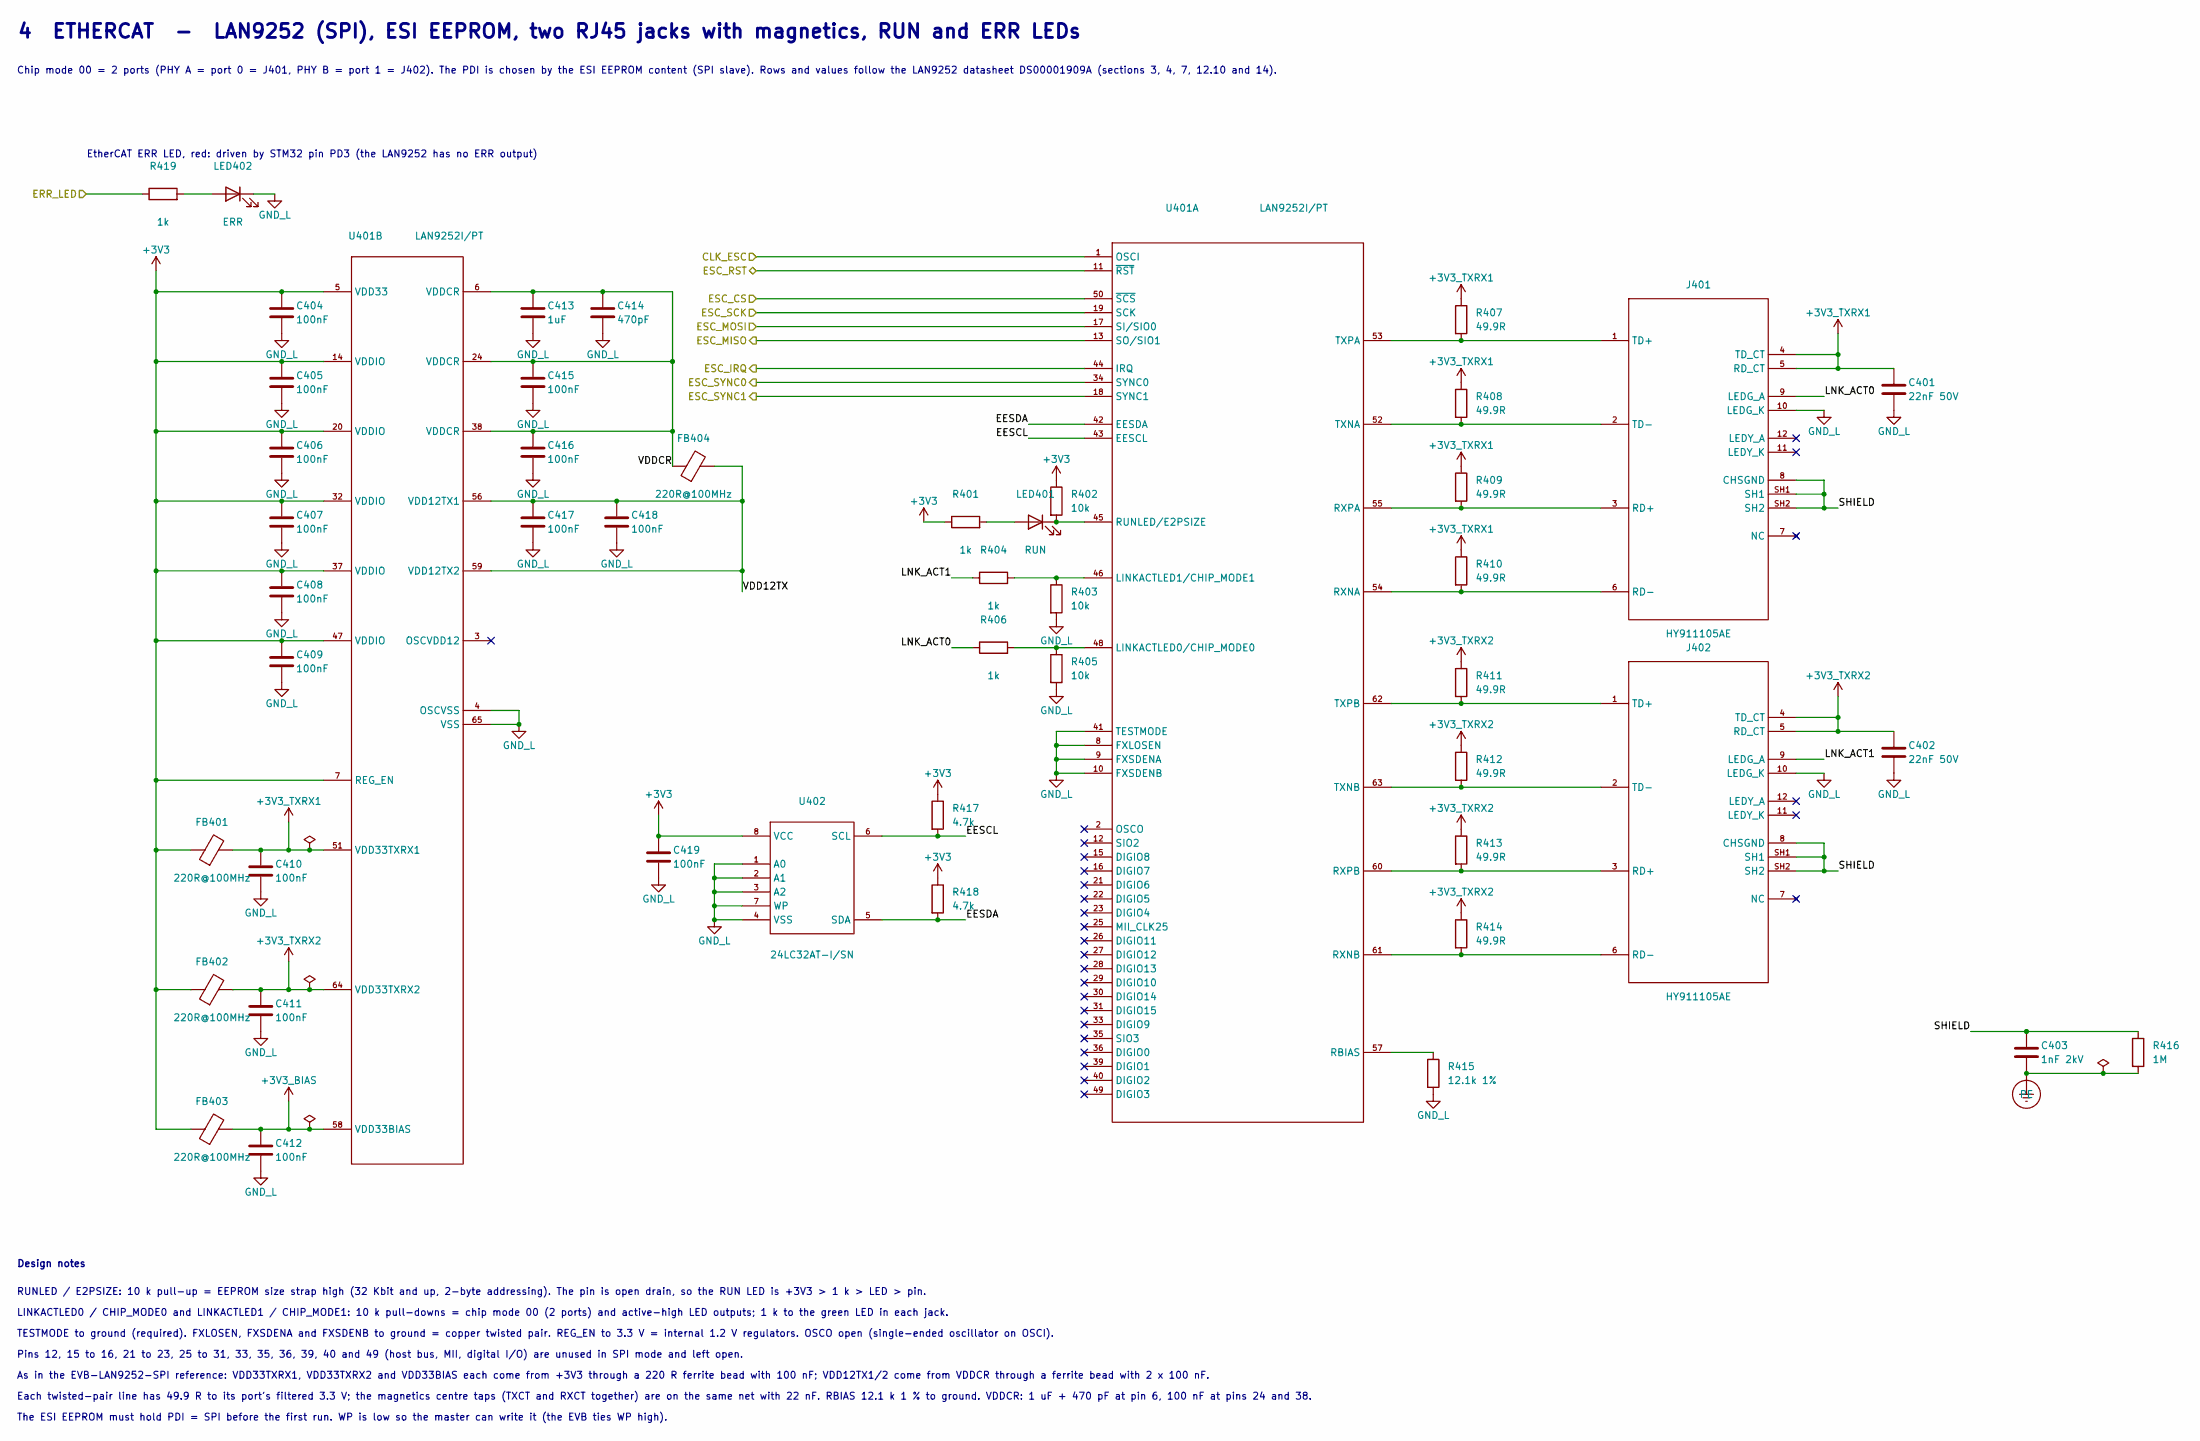
[picture p38: schematic 04_ethercat.kicad_sch]

Parts:
C401, C402: 22nF 50V; C_0603_1608Metric; MPN CC0603KRX7R9BB223; LCSC C106222
C403: 1nF 2kV; C_1206_3216Metric; MPN 1206B102K202NT; LCSC C9196
C404, C405, C406, C407, C408, C409, C410, C411, C412, C415, C416, C417, C418, C419: 100nF; C_0603_1608Metric; MPN CL10B104KB8NNNC; LCSC C1591
C413: 1uF; C_0603_1608Metric; MPN CC0603KRX7R9BB105; LCSC C559769
C414: 470pF; C_0603_1608Metric; MPN 0603B471K500NT; LCSC C1620
FB401, FB402, FB403, FB404: 220R@100MHz; L_0603_1608Metric; MPN BLM18EG221SN1D; LCSC C85827
J401, J402: HY911105AE; RJ45-TH_HR911105A; MPN HY911105AE; LCSC C69427
LED401: RUN; LED_0603_1608Metric; MPN NCD0603C3; LCSC C89809
LED402: ERR; LED_0603_1608Metric; MPN KT-0603R; LCSC C2286
R401, R404, R406, R419: 1k; R_0603_1608Metric; MPN 0603WAF1001T5E; LCSC C21190
R402, R403, R405: 10k; R_0603_1608Metric; MPN 0603WAF1002T5E; LCSC C25804
R407, R408, R409, R410, R411, R412, R413, R414: 49.9R; R_0603_1608Metric; MPN 0603WAF499JT5E; LCSC C23185
R415: 12.1k 1%; R_0603_1608Metric; MPN 0603WAF1212T5E; LCSC C22864
R416: 1M; R_0603_1608Metric; MPN 0603WAF1004T5E; LCSC C22935
R417, R418: 4.7k; R_0603_1608Metric; MPN 0603WAF4701T5E; LCSC C23162
U401: LAN9252I/PT; TQFP-64_L10.0-W10.0-P0.50-LS12.0-BL-EP; MPN LAN9252I/PT; LCSC C80933
U402: 24LC32AT-I/SN; SOIC-8_L4.9-W3.9-P1.27-LS6.0-BL; MPN 24LC32AT-I/SN; LCSC C615715

Connections:
+3V3: C404.1, C405.1, C406.1, C407.1, C408.1, C409.1, C419.1, FB401.1, FB402.1, FB403.1, R401.1, R402.1, R417.1, R418.1, U401.5 (VDD33), U401.7 (REG_EN), U401.14 (VDDIO), U401.20 (VDDIO), U401.32 (VDDIO), U401.37 (VDDIO), U401.47 (VDDIO), U402.8 (VCC)
+3V3_BIAS: C412.1, FB403.2, U401.58 (VDD33BIAS)
+3V3_TXRX1: C401.1, C410.1, FB401.2, J401.4 (TD_CT), J401.5 (RD_CT), R407.1, R408.1, R409.1, R410.1, U401.51 (VDD33TXRX1)
+3V3_TXRX2: C402.1, C411.1, FB402.2, J402.4 (TD_CT), J402.5 (RD_CT), R411.1, R412.1, R413.1, R414.1, U401.64 (VDD33TXRX2)
CLK_ESC: U401.1 (OSCI)
EESCL: R417.2, U401.43 (EESCL), U402.6 (SCL)
EESDA: R418.2, U401.42 (EESDA), U402.5 (SDA)
ERR_LED: R419.1
ESC_CS: U401.50 (~SCS)
ESC_IRQ: U401.44 (IRQ)
ESC_MISO: U401.13 (SO/SIO1)
ESC_MOSI: U401.17 (SI/SIO0)
ESC_RST: U401.11 (~RST)
ESC_SCK: U401.19 (SCK)
ESC_SYNC0: U401.34 (SYNC0)
ESC_SYNC1: U401.18 (SYNC1)
GND_L: C401.2, C402.2, C404.2, C405.2, C406.2, C407.2, C408.2, C409.2, C410.2, C411.2, C412.2, C413.2, C414.2, C415.2, C416.2, C417.2, C418.2, C419.2, J401.10 (LEDG_K), J402.10 (LEDG_K), LED402.1 (K), R403.2, R405.2, R415.2, U401.4 (OSCVSS), U401.8 (FXLOSEN), U401.9 (FXSDENA), U401.10 (FXSDENB), U401.41 (TESTMODE), U401.65 (VSS), U402.1 (A0), U402.2 (A1), U402.3 (A2), U402.4 (VSS), U402.7 (WP)
LNK_ACT0: J401.9 (LEDG_A), R406.1
LNK_ACT1: J402.9 (LEDG_A), R404.1
unnamed: J401.1 (TD+), R407.2, U401.53 (TXPA)
unnamed: J401.2 (TD-), R408.2, U401.52 (TXNA)
unnamed: J401.3 (RD+), R409.2, U401.55 (RXPA)
unnamed: J401.6 (RD-), R410.2, U401.54 (RXNA)
unnamed: J402.1 (TD+), R411.2, U401.62 (TXPB)
unnamed: J402.2 (TD-), R412.2, U401.63 (TXNB)
unnamed: J402.3 (RD+), R413.2, U401.60 (RXPB)
unnamed: J402.6 (RD-), R414.2, U401.61 (RXNB)
unnamed: LED401.1 (K), R402.2, U401.45 (RUNLED/E2PSIZE)
unnamed: LED401.2 (A), R401.2
unnamed: LED402.2 (A), R419.2
unnamed: R403.1, R404.2, U401.46 (LINKACTLED1/CHIP_MODE1)
unnamed: R405.1, R406.2, U401.48 (LINKACTLED0/CHIP_MODE0)
unnamed: R415.1, U401.57 (RBIAS)
PE: C403.2, R416.2
SHIELD: C403.1, J401.8 (CHSGND), J401.SH1, J401.SH2, J402.8 (CHSGND), J402.SH1, J402.SH2, R416.1
VDD12TX: C417.1, C418.1, FB404.2, U401.56 (VDD12TX1), U401.59 (VDD12TX2)
VDDCR: C413.1, C414.1, C415.1, C416.1, FB404.1, U401.6 (VDDCR), U401.24 (VDDCR), U401.38 (VDDCR)

Notes on the sheet:
Pins 12, 15 to 16, 21 to 23, 25 to 31, 33, 35, 36, 39, 40 and 49 (host bus, MII, digital I/O) are unused in SPI mode and left open.
TESTMODE to ground (required). FXLOSEN, FXSDENA and FXSDENB to ground = copper twisted pair. REG_EN to 3.3 V = internal 1.2 V regulators. OSCO open (single-ended oscillator on OSCI).
RUNLED / E2PSIZE: 10 k pull-up = EEPROM size strap high (32 Kbit and up, 2-byte addressing). The pin is open drain, so the RUN LED is +3V3 > 1 k > LED > pin.
Design notes
The ESI EEPROM must hold PDI = SPI before the first run. WP is low so the master can write it (the EVB ties WP high).
Each twisted-pair line has 49.9 R to its port's filtered 3.3 V; the magnetics centre taps (TXCT and RXCT together) are on the same net with 22 nF. RBIAS 12.1 k 1 % to ground. VDDCR: 1 uF + 470 pF at pin 6, 100 nF at pins 24 and 38.
EtherCAT ERR LED, red: driven by STM32 pin PD3 (the LAN9252 has no ERR output)
LINKACTLED0 / CHIP_MODE0 and LINKACTLED1 / CHIP_MODE1: 10 k pull-downs = chip mode 00 (2 ports) and active-high LED outputs; 1 k to the green LED in each jack.
4 ETHERCAT - LAN9252 (SPI), ESI EEPROM, two RJ45 jacks with magnetics, RUN and ERR LEDs
As in the EVB-LAN9252-SPI reference: VDD33TXRX1, VDD33TXRX2 and VDD33BIAS each come from +3V3 through a 220 R ferrite bead with 100 nF; VDD12TX1/2 come from VDDCR through a ferrite bead with 2 x 100 nF.
Chip mode 00 = 2 ports (PHY A = port 0 = J401, PHY B = port 1 = J402). The PDI is chosen by the ESI EEPROM content (SPI slave). Rows and values follow the LAN9252 datasheet DS00001909A (sections 3, 4, 7, 12.10 and 14).
