yi-aditya/LCEC-IO/hardware/05_inputs.kicad_sch

## KiCad design hardware/05_inputs.kicad_sch (2026-11-06)

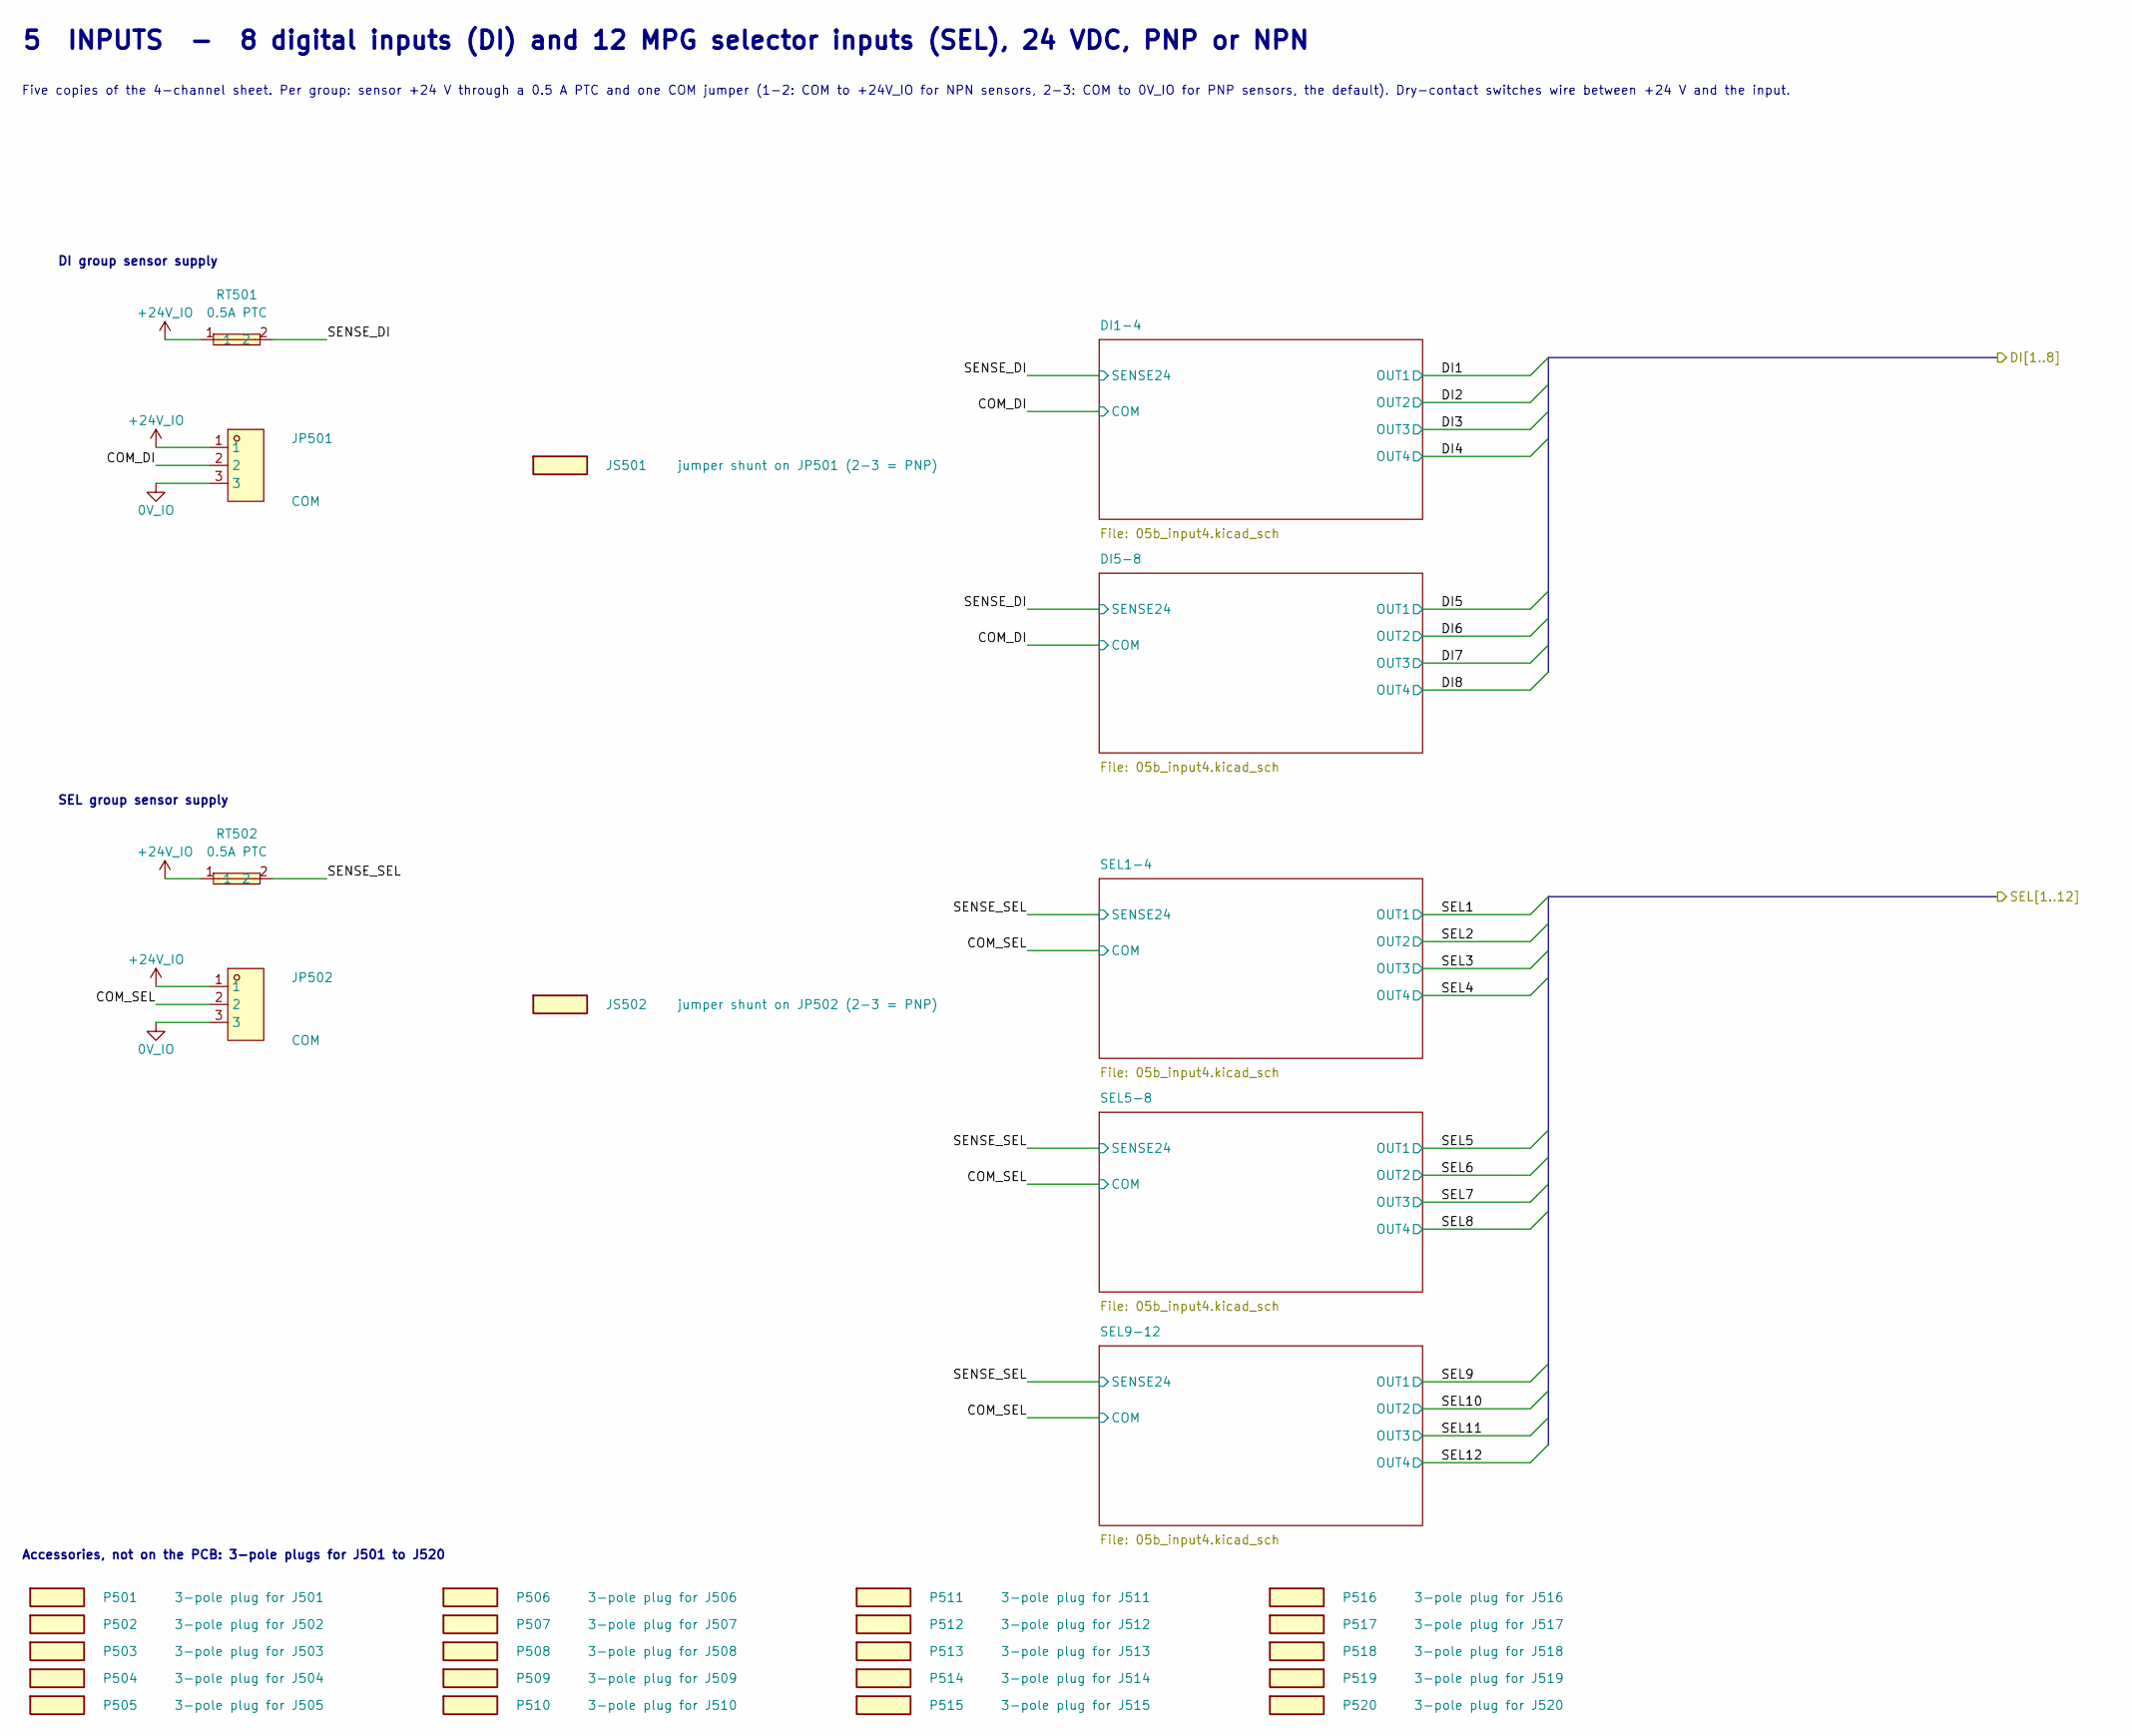
[picture p39: schematic 05_inputs.kicad_sch]

Parts:
JP501, JP502: COM; HDR-TH_3P-P2.54-V-M_PZ254V-11-03P; MPN PZ254V-11-03P; LCSC C2937625
JS501: jumper shunt on JP501 (2-3 = PNP); MPN 2.54; LCSC C5305
JS502: jumper shunt on JP502 (2-3 = PNP); MPN 2.54; LCSC C5305
P501: 3-pole plug for J501; MPN KF2EDGK-5.08-3P-AA; LCSC C440881
P502: 3-pole plug for J502; MPN KF2EDGK-5.08-3P-AA; LCSC C440881
P503: 3-pole plug for J503; MPN KF2EDGK-5.08-3P-AA; LCSC C440881
P504: 3-pole plug for J504; MPN KF2EDGK-5.08-3P-AA; LCSC C440881
P505: 3-pole plug for J505; MPN KF2EDGK-5.08-3P-AA; LCSC C440881
P506: 3-pole plug for J506; MPN KF2EDGK-5.08-3P-AA; LCSC C440881
P507: 3-pole plug for J507; MPN KF2EDGK-5.08-3P-AA; LCSC C440881
P508: 3-pole plug for J508; MPN KF2EDGK-5.08-3P-AA; LCSC C440881
P509: 3-pole plug for J509; MPN KF2EDGK-5.08-3P-AA; LCSC C440881
P510: 3-pole plug for J510; MPN KF2EDGK-5.08-3P-AA; LCSC C440881
P511: 3-pole plug for J511; MPN KF2EDGK-5.08-3P-AA; LCSC C440881
P512: 3-pole plug for J512; MPN KF2EDGK-5.08-3P-AA; LCSC C440881
P513: 3-pole plug for J513; MPN KF2EDGK-5.08-3P-AA; LCSC C440881
P514: 3-pole plug for J514; MPN KF2EDGK-5.08-3P-AA; LCSC C440881
P515: 3-pole plug for J515; MPN KF2EDGK-5.08-3P-AA; LCSC C440881
P516: 3-pole plug for J516; MPN KF2EDGK-5.08-3P-AA; LCSC C440881
P517: 3-pole plug for J517; MPN KF2EDGK-5.08-3P-AA; LCSC C440881
P518: 3-pole plug for J518; MPN KF2EDGK-5.08-3P-AA; LCSC C440881
P519: 3-pole plug for J519; MPN KF2EDGK-5.08-3P-AA; LCSC C440881
P520: 3-pole plug for J520; MPN KF2EDGK-5.08-3P-AA; LCSC C440881
RT501, RT502: 0.5A PTC; F1812; MPN 1812L050/30PR; LCSC C151168

Connections:
0V_IO: JP501.3, JP502.3
+24V_IO: JP501.1, JP502.1, RT501.1, RT502.1
COM_DI: JP501.2
COM_SEL: JP502.2
SENSE_DI: RT501.2
SENSE_SEL: RT502.2

Notes on the sheet:
Accessories, not on the PCB: 3-pole plugs for J501 to J520
5 INPUTS - 8 digital inputs (DI) and 12 MPG selector inputs (SEL), 24 VDC, PNP or NPN
SEL group sensor supply
DI group sensor supply
Five copies of the 4-channel sheet. Per group: sensor +24 V through a 0.5 A PTC and one COM jumper (1-2: COM to +24V_IO for NPN sensors, 2-3: COM to 0V_IO for PNP sensors, the default). Dry-contact switches wire between +24 V and the input.
