yi-aditya/LCEC-IO/hardware/05b_input4.kicad_sch

## KiCad design hardware/05b_input4.kicad_sch (2026-11-06)

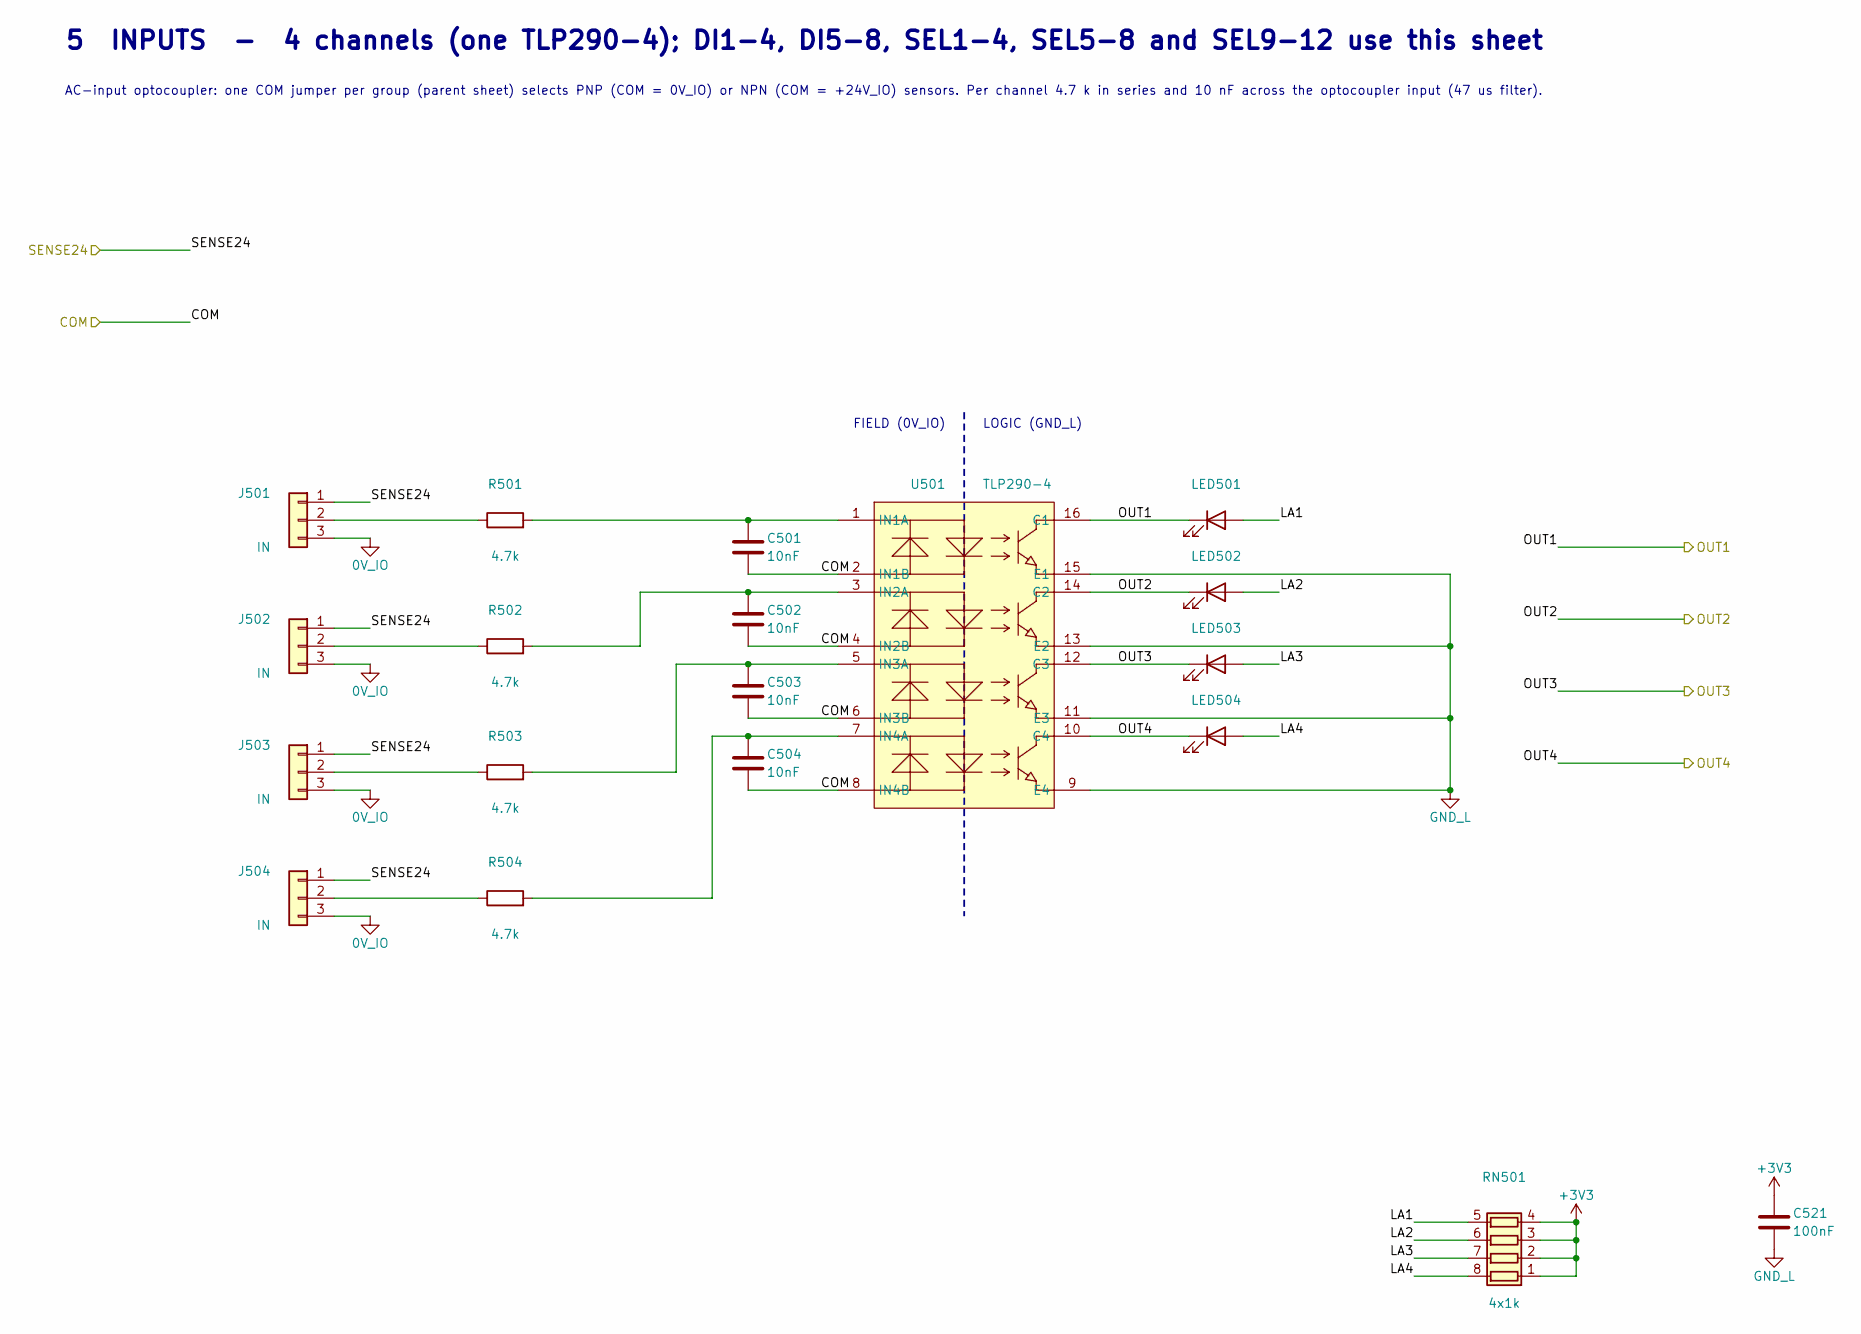
[picture p40: schematic 05b_input4.kicad_sch]

Parts:
C501, C502, C503, C504: 10nF; C_0603_1608Metric; MPN CL10B103KB8NNNC; LCSC C1589
C521: 100nF; C_0603_1608Metric; MPN CL10B104KB8NNNC; LCSC C1591
J501, J502, J503, J504: IN; CONN-TH_3P-P5.08_KF2EDGR-5.08-3P; MPN KF2EDGR-5.08-3P; LCSC C441205
LED501, LED502, LED503, LED504: IN; LED_0603_1608Metric; MPN NCD0603C3; LCSC C89809
R501, R502, R503, R504: 4.7k; R_1206_3216Metric; MPN 1206W4F4701T5E; LCSC C17936
RN501: 4x1k; R_Array_Convex_4x0603; MPN 4D03WGJ0102T5E; LCSC C20197
U501: TLP290-4; SOP-16_L10.3-W4.4-P1.27-LS7.0-BL; MPN TLP290-4(GB-TP,E; LCSC C39031

Connections:
0V_IO: J501.3, J502.3, J503.3, J504.3
+3V3: C521.1, RN501.1 (R1.1), RN501.2 (R2.1), RN501.3 (R3.1), RN501.4 (R4.1)
COM: C501.2, C502.2, C503.2, C504.2, U501.2 (IN1B), U501.4 (IN2B), U501.6 (IN3B), U501.8 (IN4B)
GND_L: C521.2, U501.9 (E4), U501.11 (E3), U501.13 (E2), U501.15 (E1)
LA1: LED501.2 (A), RN501.5 (R4.2)
LA2: LED502.2 (A), RN501.6 (R3.2)
LA3: LED503.2 (A), RN501.7 (R2.2)
LA4: LED504.2 (A), RN501.8 (R1.2)
unnamed: C501.1, R501.2, U501.1 (IN1A)
unnamed: C502.1, R502.2, U501.3 (IN2A)
unnamed: C503.1, R503.2, U501.5 (IN3A)
unnamed: C504.1, R504.2, U501.7 (IN4A)
unnamed: J501.2, R501.1
unnamed: J502.2, R502.1
unnamed: J503.2, R503.1
unnamed: J504.2, R504.1
OUT1: LED501.1 (K), U501.16 (C1)
OUT2: LED502.1 (K), U501.14 (C2)
OUT3: LED503.1 (K), U501.12 (C3)
OUT4: LED504.1 (K), U501.10 (C4)
SENSE24: J501.1, J502.1, J503.1, J504.1

Notes on the sheet:
AC-input optocoupler: one COM jumper per group (parent sheet) selects PNP (COM = 0V_IO) or NPN (COM = +24V_IO) sensors. Per channel 4.7 k in series and 10 nF across the optocoupler input (47 us filter).
5 INPUTS - 4 channels (one TLP290-4); DI1-4, DI5-8, SEL1-4, SEL5-8 and SEL9-12 use this sheet
LOGIC (GND_L)
FIELD (0V_IO)
