yi-aditya/LCEC-IO/hardware/06_mpg.kicad_sch

## KiCad design hardware/06_mpg.kicad_sch (2026-11-06)

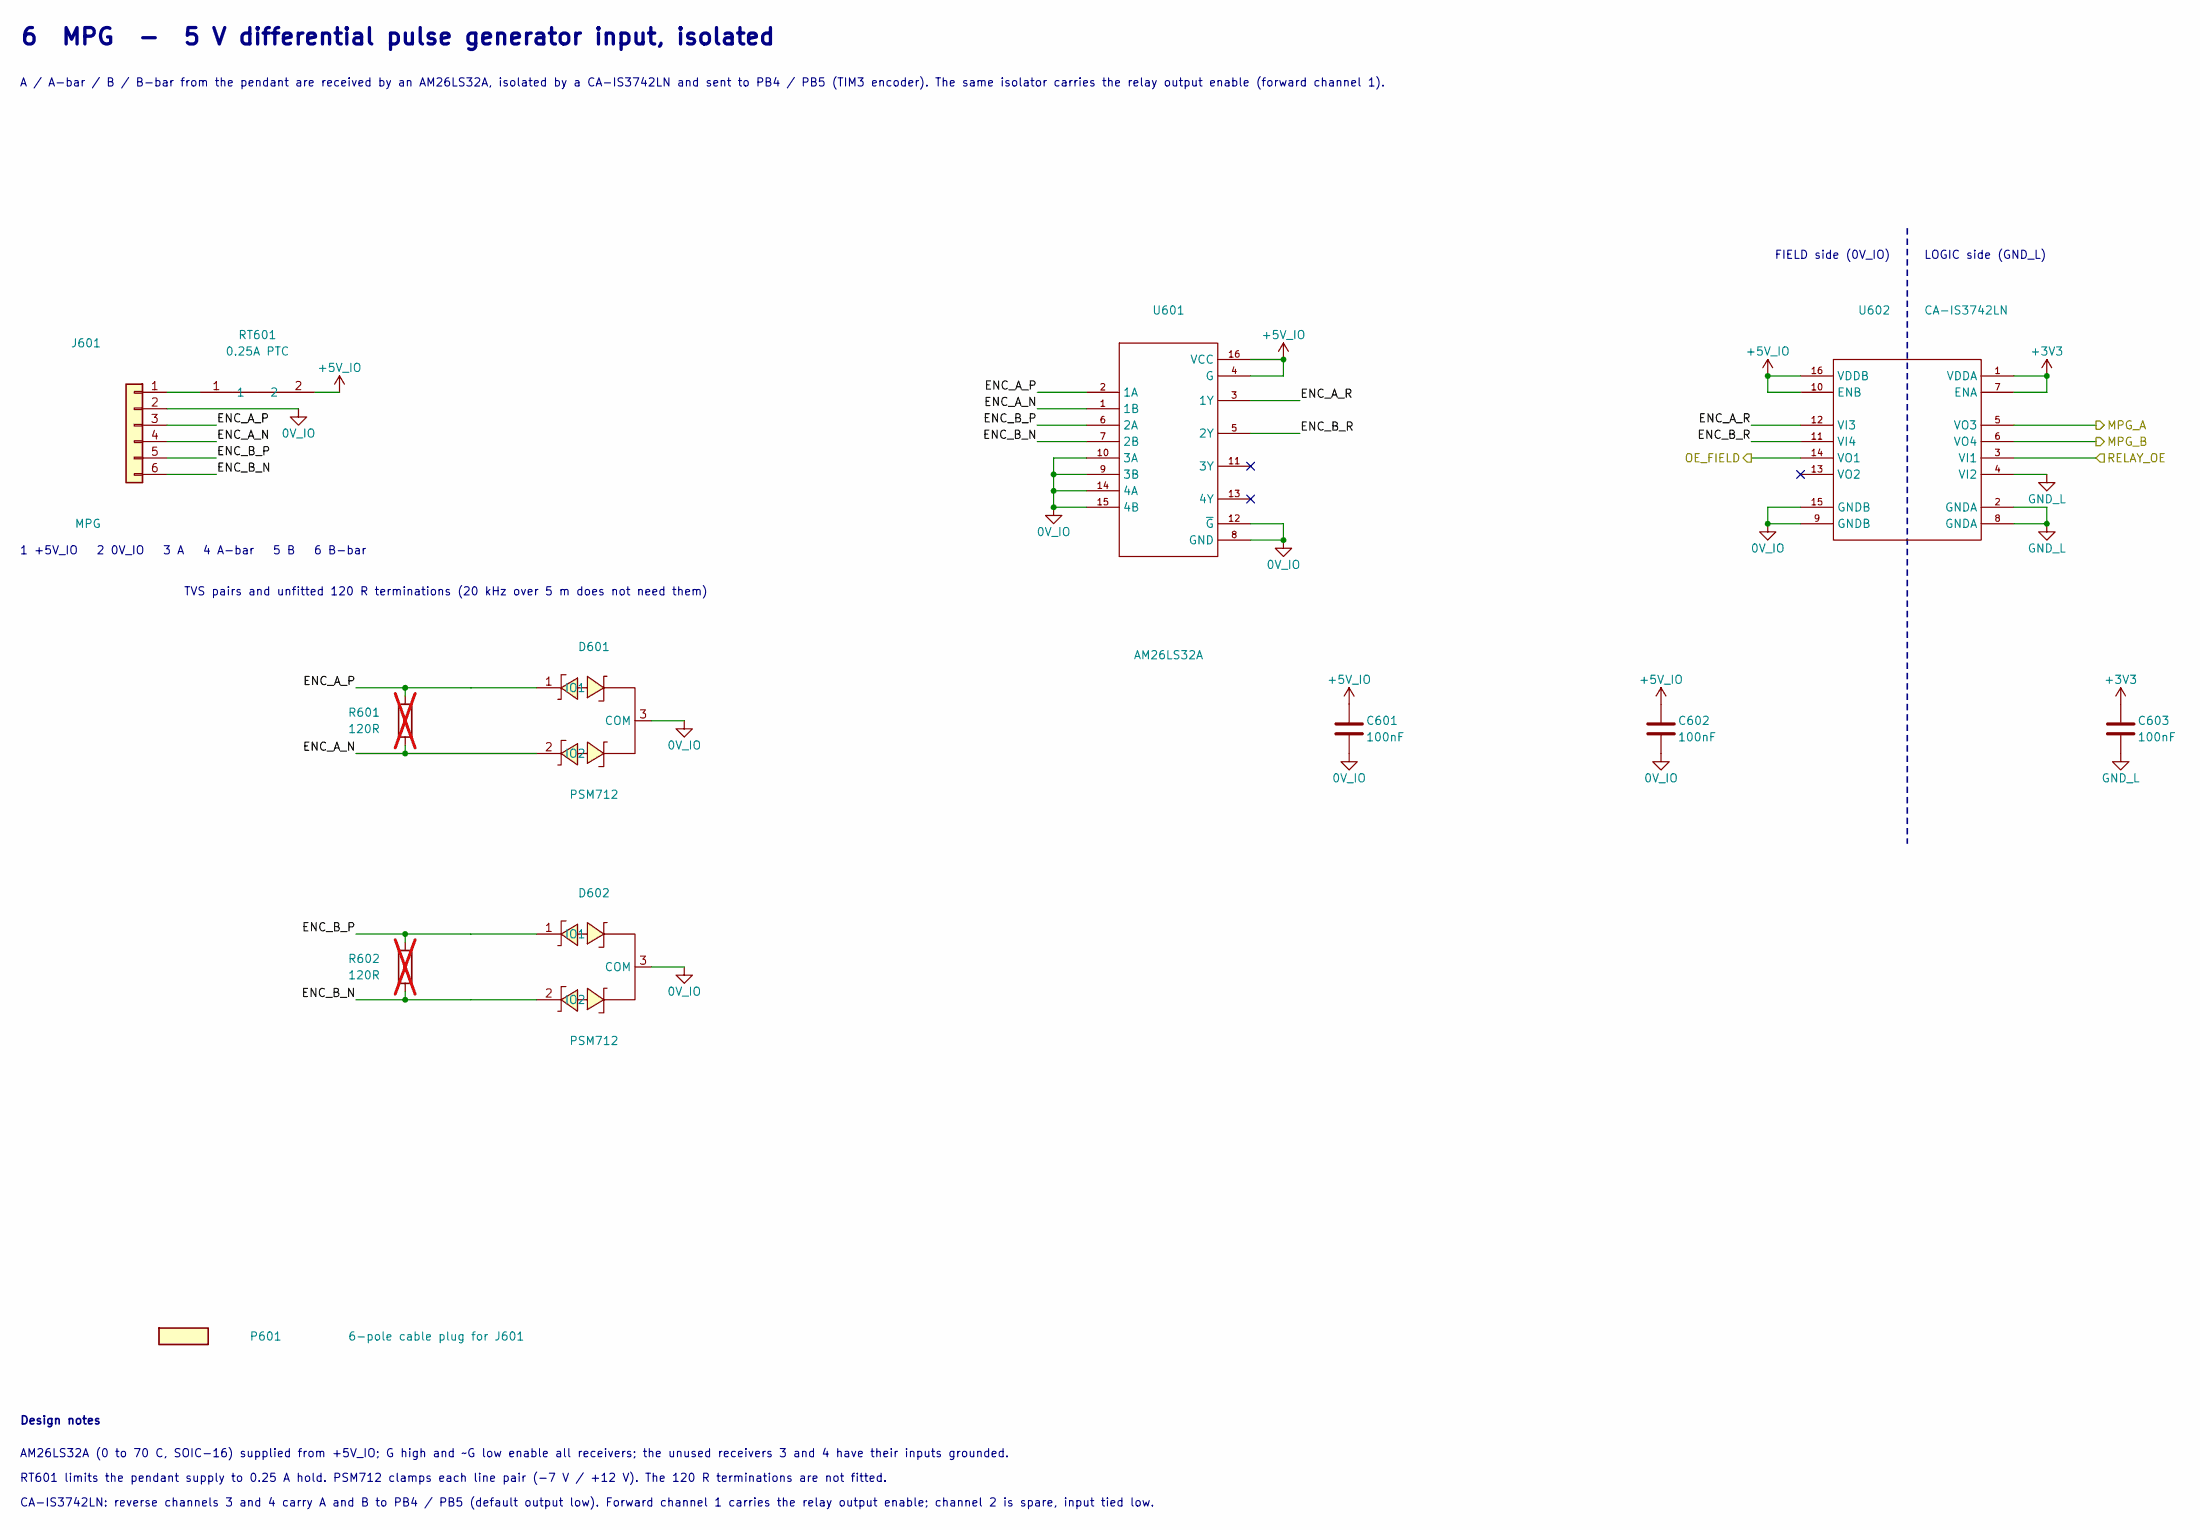
[picture p41: schematic 06_mpg.kicad_sch]

Parts:
C601, C602, C603: 100nF; C_0603_1608Metric; MPN CL10B104KB8NNNC; LCSC C1591
D601, D602: PSM712; SOT-23-3_L3.0-W1.7-P0.95-LS2.9-BR; MPN PSM712-LF-T7; LCSC C32677
J601: MPG; CONN-TH_6P-P5.08_KF2EDGR-5.08-6P; MPN KF2EDGR-5.08-6P; LCSC C441208
P601: 6-pole cable plug for J601; MPN KF2EDGK-5.08-6P; LCSC C440884
R601, R602: 120R; R_0603_1608Metric; MPN 0603WAF1200T5E; LCSC C22787; not fitted
RT601: 0.25A PTC; F1206; MPN nSMD025; LCSC C70068
U601: AM26LS32A; SOIC-16_L9.9-W3.9-P1.27-LS6.0-BL; MPN AM26LS32ACDR; LCSC C6180
U602: CA-IS3742LN; SOP-16_L10.0-W3.9-P1.27-LS6.0-BL; MPN CA-IS3742LN; LCSC C5347249

Connections:
0V_IO: C601.2, C602.2, D601.3 (COM), D602.3 (COM), J601.2, U601.8 (GND), U601.9 (3B), U601.10 (3A), U601.12 (~G), U601.14 (4A), U601.15 (4B), U602.9 (GNDB), U602.15 (GNDB)
+3V3: C603.1, U602.1 (VDDA), U602.7 (ENA)
+5V_IO: C601.1, C602.1, RT601.2, U601.4 (G), U601.16 (VCC), U602.10 (ENB), U602.16 (VDDB)
ENC_A_N: D601.2 (IO2), J601.4, R601.2, U601.1 (1B)
ENC_A_P: D601.1 (IO1), J601.3, R601.1, U601.2 (1A)
ENC_A_R: U601.3 (1Y), U602.12 (VI3)
ENC_B_N: D602.2 (IO2), J601.6, R602.2, U601.7 (2B)
ENC_B_P: D602.1 (IO1), J601.5, R602.1, U601.6 (2A)
ENC_B_R: U601.5 (2Y), U602.11 (VI4)
GND_L: C603.2, U602.2 (GNDA), U602.4 (VI2), U602.8 (GNDA)
MPG_A: U602.5 (VO3)
MPG_B: U602.6 (VO4)
unnamed: J601.1, RT601.1
OE_FIELD: U602.14 (VO1)
RELAY_OE: U602.3 (VI1)

Notes on the sheet:
6 MPG - 5 V differential pulse generator input, isolated
Design notes
LOGIC side (GND_L)
CA-IS3742LN: reverse channels 3 and 4 carry A and B to PB4 / PB5 (default output low). Forward channel 1 carries the relay output enable; channel 2 is spare, input tied low.
TVS pairs and unfitted 120 R terminations (20 kHz over 5 m does not need them)
RT601 limits the pendant supply to 0.25 A hold. PSM712 clamps each line pair (-7 V / +12 V). The 120 R terminations are not fitted.
1 +5V_IO 2 0V_IO 3 A 4 A-bar 5 B 6 B-bar
FIELD side (0V_IO)
AM26LS32A (0 to 70 C, SOIC-16) supplied from +5V_IO; G high and ~G low enable all receivers; the unused receivers 3 and 4 have their inputs grounded.
A / A-bar / B / B-bar from the pendant are received by an AM26LS32A, isolated by a CA-IS3742LN and sent to PB4 / PB5 (TIM3 encoder). The same isolator carries the relay output enable (forward channel 1).
