yi-aditya/LCEC-IO/hardware/07_relays.kicad_sch

## KiCad design hardware/07_relays.kicad_sch (2026-11-06)

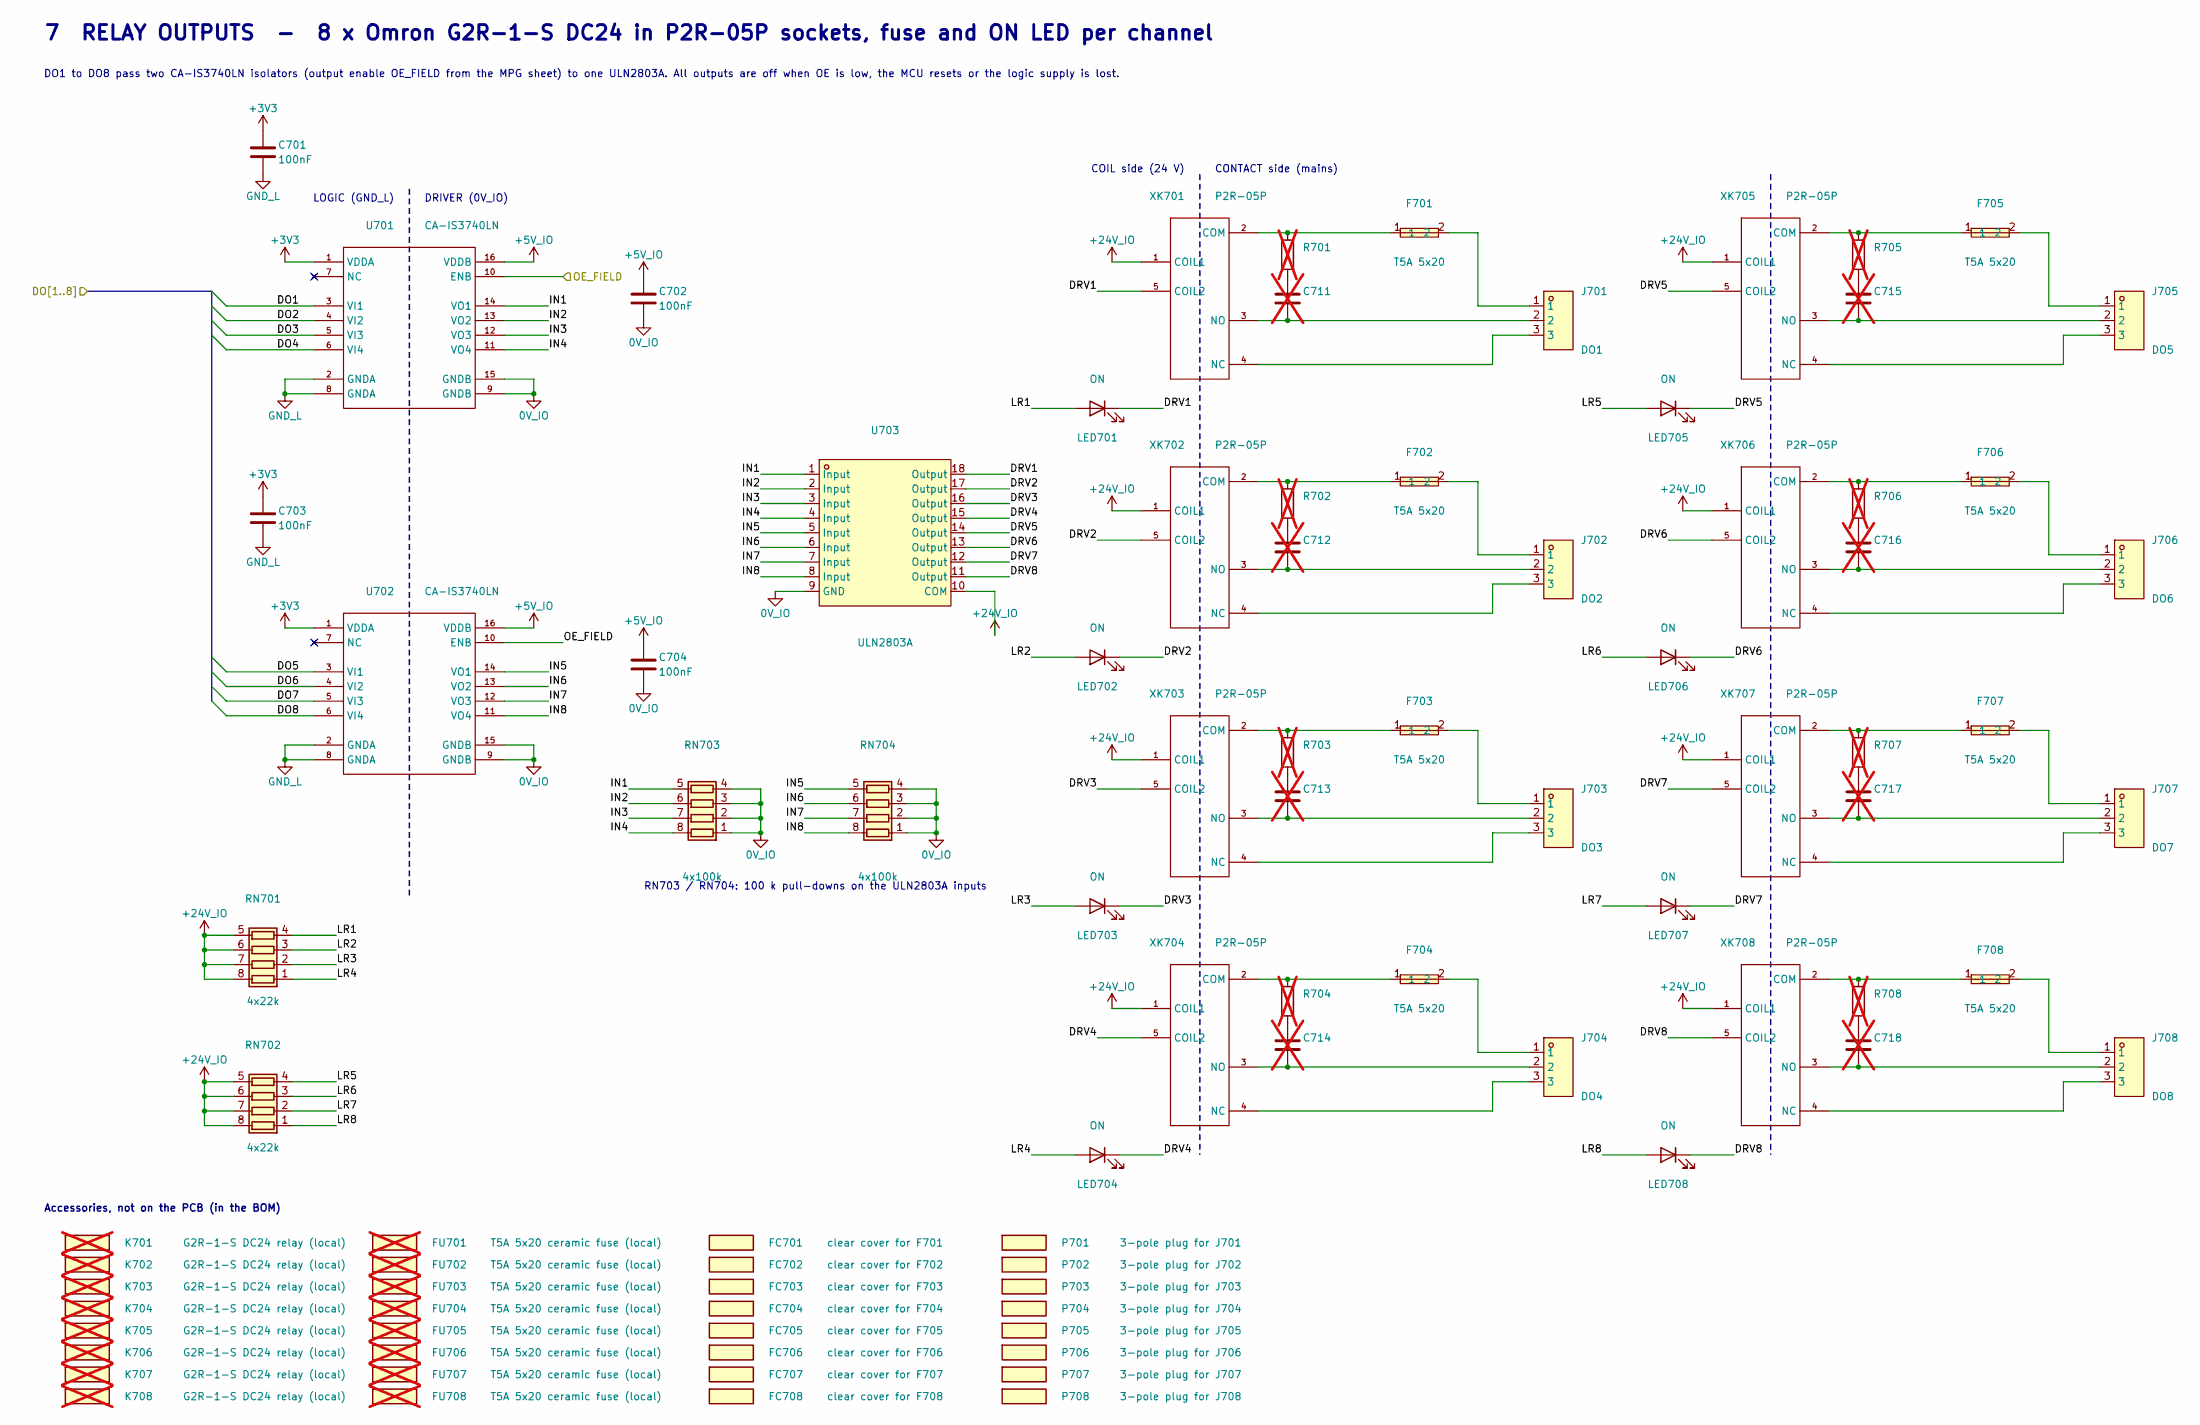
[picture p42: schematic 07_relays.kicad_sch]

Parts:
C701, C702, C703, C704: 100nF; C_0603_1608Metric; MPN CL10B104KB8NNNC; LCSC C1591
C711, C712, C713, C714, C715, C716, C717, C718: 47nF X2; C_Rect_L18.0mm_W8.0mm_P15.00mm_FKS3_FKP3; MPN RC snubber, value set at layout; LCSC DNP (footprint only); not fitted
F701, F702, F703, F704, F705, F706, F707, F708: T5A 5x20; 64600001003; MPN 64600001003; LCSC C206887
FC701: clear cover for F701; MPN 64800001009; LCSC C187509
FC702: clear cover for F702; MPN 64800001009; LCSC C187509
FC703: clear cover for F703; MPN 64800001009; LCSC C187509
FC704: clear cover for F704; MPN 64800001009; LCSC C187509
FC705: clear cover for F705; MPN 64800001009; LCSC C187509
FC706: clear cover for F706; MPN 64800001009; LCSC C187509
FC707: clear cover for F707; MPN 64800001009; LCSC C187509
FC708: clear cover for F708; MPN 64800001009; LCSC C187509
FU701, FU702, FU703, FU704, FU705, FU706, FU707, FU708: T5A 5x20 ceramic fuse (local); MPN T5A 250 V 5x20 ceramic; LCSC LOCAL (India); not fitted
J701: DO1; CONN-TH_3P-P5.08_KF2EDGR-5.08-3P; MPN KF2EDGR-5.08-3P; LCSC C441205
J702: DO2; CONN-TH_3P-P5.08_KF2EDGR-5.08-3P; MPN KF2EDGR-5.08-3P; LCSC C441205
J703: DO3; CONN-TH_3P-P5.08_KF2EDGR-5.08-3P; MPN KF2EDGR-5.08-3P; LCSC C441205
J704: DO4; CONN-TH_3P-P5.08_KF2EDGR-5.08-3P; MPN KF2EDGR-5.08-3P; LCSC C441205
J705: DO5; CONN-TH_3P-P5.08_KF2EDGR-5.08-3P; MPN KF2EDGR-5.08-3P; LCSC C441205
J706: DO6; CONN-TH_3P-P5.08_KF2EDGR-5.08-3P; MPN KF2EDGR-5.08-3P; LCSC C441205
J707: DO7; CONN-TH_3P-P5.08_KF2EDGR-5.08-3P; MPN KF2EDGR-5.08-3P; LCSC C441205
J708: DO8; CONN-TH_3P-P5.08_KF2EDGR-5.08-3P; MPN KF2EDGR-5.08-3P; LCSC C441205
K701, K702, K703, K704, K705, K706, K707, K708: G2R-1-S DC24 relay (local); MPN G2R-1-S DC24; LCSC LOCAL (India); not fitted
LED701, LED702, LED703, LED704, LED705, LED706, LED707, LED708: ON; LED_0603_1608Metric; MPN NCD0603C3; LCSC C89809
P701: 3-pole plug for J701; MPN KF2EDGK-5.08-3P-AA; LCSC C440881
P702: 3-pole plug for J702; MPN KF2EDGK-5.08-3P-AA; LCSC C440881
P703: 3-pole plug for J703; MPN KF2EDGK-5.08-3P-AA; LCSC C440881
P704: 3-pole plug for J704; MPN KF2EDGK-5.08-3P-AA; LCSC C440881
P705: 3-pole plug for J705; MPN KF2EDGK-5.08-3P-AA; LCSC C440881
P706: 3-pole plug for J706; MPN KF2EDGK-5.08-3P-AA; LCSC C440881
P707: 3-pole plug for J707; MPN KF2EDGK-5.08-3P-AA; LCSC C440881
P708: 3-pole plug for J708; MPN KF2EDGK-5.08-3P-AA; LCSC C440881
R701, R702, R703, R704, R705, R706, R707, R708: 100R; R_2512_6332Metric; MPN RC snubber, value set at layout; LCSC DNP (footprint only); not fitted
RN701, RN702: 4x22k; R_Array_Convex_4x0603; MPN 4D03WGJ0223T5E; LCSC C25729
RN703, RN704: 4x100k; R_Array_Convex_4x0603; MPN 4D03WGJ0104T5E; LCSC C1996
U701, U702: CA-IS3740LN; SOIC-16_L9.9-W3.9-P1.27-LS6.0-BL; MPN CA-IS3740LN; LCSC C428888
U703: ULN2803A; SOP-18_L11.4-W7.6-P1.27-LS10.6-BL; MPN ULN2803A; LCSC C845537
XK701, XK702, XK703, XK704, XK705, XK706, XK707, XK708: P2R-05P; RELAY-TH_P2R-05P; MPN P2R-05P; LCSC C1524860

Connections:
0V_IO: C702.2, C704.2, RN703.1 (R1.1), RN703.2 (R2.1), RN703.3 (R3.1), RN703.4 (R4.1), RN704.1 (R1.1), RN704.2 (R2.1), RN704.3 (R3.1), RN704.4 (R4.1), U701.9 (GNDB), U701.15 (GNDB), U702.9 (GNDB), U702.15 (GNDB), U703.9 (GND)
+3V3: C701.1, C703.1, U701.1 (VDDA), U702.1 (VDDA)
+5V_IO: C702.1, C704.1, U701.16 (VDDB), U702.16 (VDDB)
+24V_IO: RN701.5 (R4.2), RN701.6 (R3.2), RN701.7 (R2.2), RN701.8 (R1.2), RN702.5 (R4.2), RN702.6 (R3.2), RN702.7 (R2.2), RN702.8 (R1.2), U703.10 (COM), XK701.1 (COIL1), XK702.1 (COIL1), XK703.1 (COIL1), XK704.1 (COIL1), XK705.1 (COIL1), XK706.1 (COIL1), XK707.1 (COIL1), XK708.1 (COIL1)
DO1: U701.3 (VI1)
DO2: U701.4 (VI2)
DO3: U701.5 (VI3)
DO4: U701.6 (VI4)
DO5: U702.3 (VI1)
DO6: U702.4 (VI2)
DO7: U702.5 (VI3)
DO8: U702.6 (VI4)
DRV1: LED701.1 (K), U703.18 (Output), XK701.5 (COIL2)
DRV2: LED702.1 (K), U703.17 (Output), XK702.5 (COIL2)
DRV3: LED703.1 (K), U703.16 (Output), XK703.5 (COIL2)
DRV4: LED704.1 (K), U703.15 (Output), XK704.5 (COIL2)
DRV5: LED705.1 (K), U703.14 (Output), XK705.5 (COIL2)
DRV6: LED706.1 (K), U703.13 (Output), XK706.5 (COIL2)
DRV7: LED707.1 (K), U703.12 (Output), XK707.5 (COIL2)
DRV8: LED708.1 (K), U703.11 (Output), XK708.5 (COIL2)
GND_L: C701.2, C703.2, U701.2 (GNDA), U701.8 (GNDA), U702.2 (GNDA), U702.8 (GNDA)
IN1: RN703.5 (R4.2), U701.14 (VO1), U703.1 (Input)
IN2: RN703.6 (R3.2), U701.13 (VO2), U703.2 (Input)
IN3: RN703.7 (R2.2), U701.12 (VO3), U703.3 (Input)
IN4: RN703.8 (R1.2), U701.11 (VO4), U703.4 (Input)
IN5: RN704.5 (R4.2), U702.14 (VO1), U703.5 (Input)
IN6: RN704.6 (R3.2), U702.13 (VO2), U703.6 (Input)
IN7: RN704.7 (R2.2), U702.12 (VO3), U703.7 (Input)
IN8: RN704.8 (R1.2), U702.11 (VO4), U703.8 (Input)
LR1: LED701.2 (A), RN701.4 (R4.1)
LR2: LED702.2 (A), RN701.3 (R3.1)
LR3: LED703.2 (A), RN701.2 (R2.1)
LR4: LED704.2 (A), RN701.1 (R1.1)
LR5: LED705.2 (A), RN702.4 (R4.1)
LR6: LED706.2 (A), RN702.3 (R3.1)
LR7: LED707.2 (A), RN702.2 (R2.1)
LR8: LED708.2 (A), RN702.1 (R1.1)
unnamed: C711.1, R701.2
unnamed: C711.2, J701.2, XK701.3 (NO)
unnamed: C712.1, R702.2
unnamed: C712.2, J702.2, XK702.3 (NO)
unnamed: C713.1, R703.2
unnamed: C713.2, J703.2, XK703.3 (NO)
unnamed: C714.1, R704.2
unnamed: C714.2, J704.2, XK704.3 (NO)
unnamed: C715.1, R705.2
unnamed: C715.2, J705.2, XK705.3 (NO)
unnamed: C716.1, R706.2
unnamed: C716.2, J706.2, XK706.3 (NO)
unnamed: C717.1, R707.2
unnamed: C717.2, J707.2, XK707.3 (NO)
unnamed: C718.1, R708.2
unnamed: C718.2, J708.2, XK708.3 (NO)
unnamed: F701.1, R701.1, XK701.2 (COM)
unnamed: F701.2, J701.1
unnamed: F702.1, R702.1, XK702.2 (COM)
unnamed: F702.2, J702.1
unnamed: F703.1, R703.1, XK703.2 (COM)
unnamed: F703.2, J703.1
unnamed: F704.1, R704.1, XK704.2 (COM)
unnamed: F704.2, J704.1
unnamed: F705.1, R705.1, XK705.2 (COM)
unnamed: F705.2, J705.1
unnamed: F706.1, R706.1, XK706.2 (COM)
unnamed: F706.2, J706.1
unnamed: F707.1, R707.1, XK707.2 (COM)
unnamed: F707.2, J707.1
unnamed: F708.1, R708.1, XK708.2 (COM)
unnamed: F708.2, J708.1
unnamed: J701.3, XK701.4 (NC)
unnamed: J702.3, XK702.4 (NC)
unnamed: J703.3, XK703.4 (NC)
unnamed: J704.3, XK704.4 (NC)
unnamed: J705.3, XK705.4 (NC)
unnamed: J706.3, XK706.4 (NC)
unnamed: J707.3, XK707.4 (NC)
unnamed: J708.3, XK708.4 (NC)
OE_FIELD: U701.10 (ENB), U702.10 (ENB)

Notes on the sheet:
CONTACT side (mains)
COIL side (24 V)
RN703 / RN704: 100 k pull-downs on the ULN2803A inputs
DO1 to DO8 pass two CA-IS3740LN isolators (output enable OE_FIELD from the MPG sheet) to one ULN2803A. All outputs are off when OE is low, the MCU resets or the logic supply is lost.
LOGIC (GND_L)
7 RELAY OUTPUTS - 8 x Omron G2R-1-S DC24 in P2R-05P sockets, fuse and ON LED per channel
DRIVER (0V_IO)
Accessories, not on the PCB (in the BOM)
