yi-aditya/LCEC-IO/hardware/08_analog.kicad_sch

## KiCad design hardware/08_analog.kicad_sch (2026-11-06)

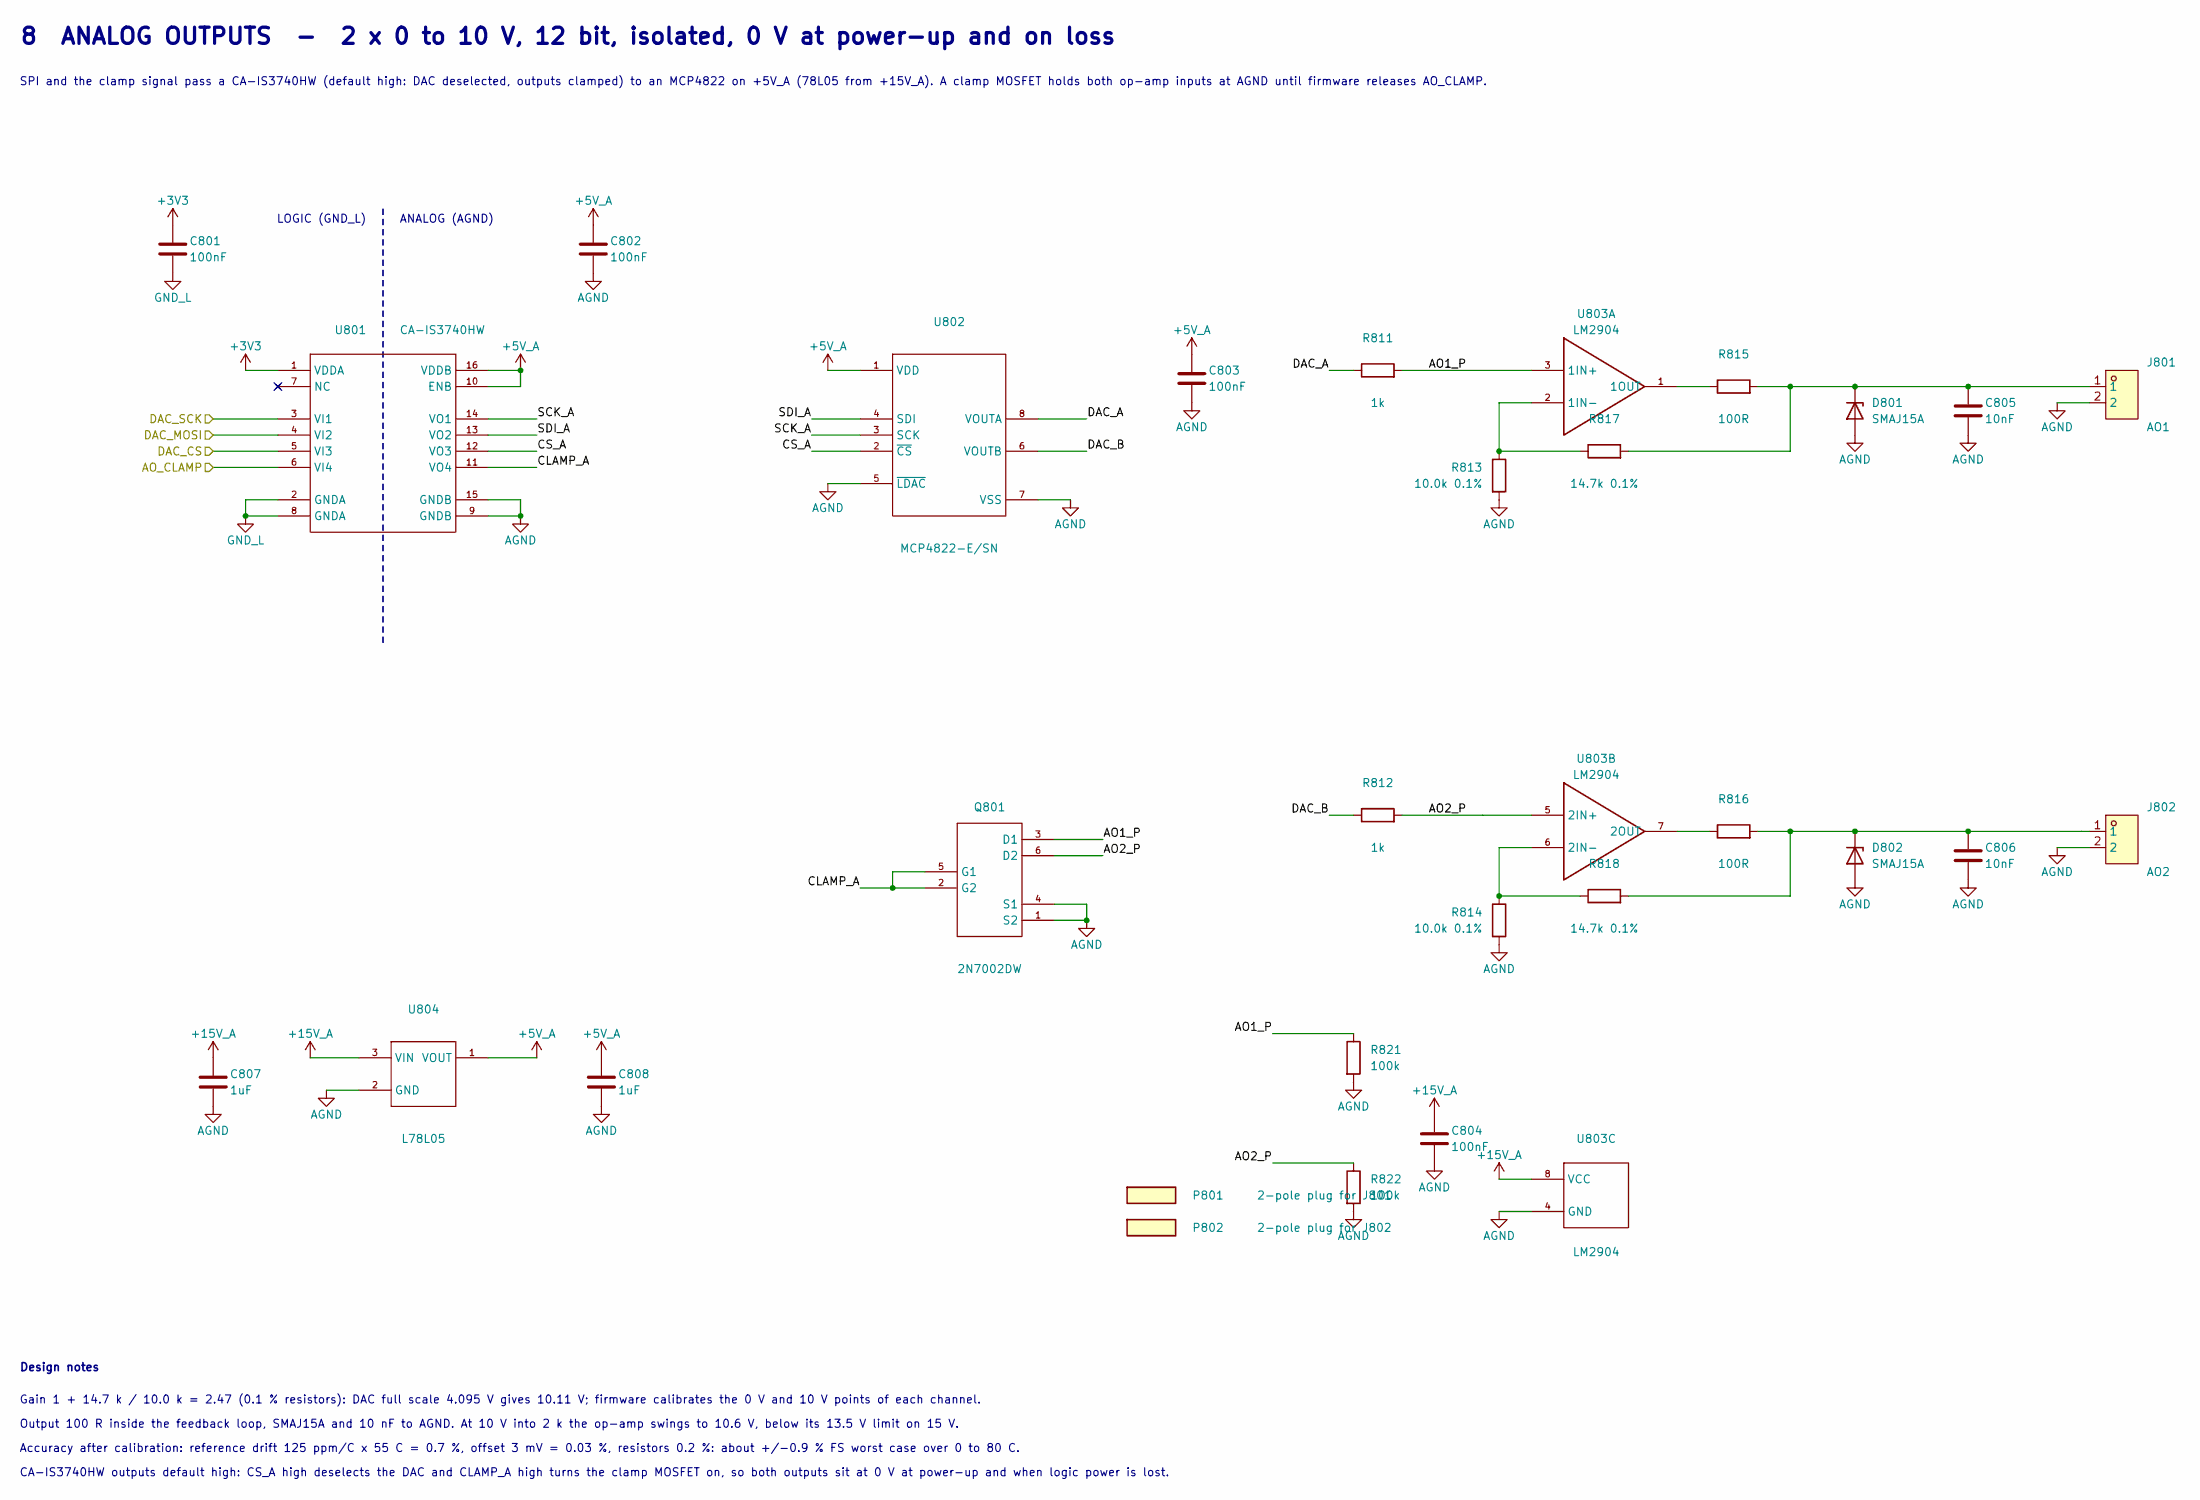
[picture p43: schematic 08_analog.kicad_sch]

Parts:
C801, C802, C803, C804: 100nF; C_0603_1608Metric; MPN CL10B104KB8NNNC; LCSC C1591
C805, C806: 10nF; C_0603_1608Metric; MPN CL10B103KB8NNNC; LCSC C1589
C807, C808: 1uF; C_0603_1608Metric; MPN CC0603KRX7R9BB105; LCSC C559769
D801, D802: SMAJ15A; SMA_L4.3-W2.6-LS5.2-RD; MPN SMAJ15A; LCSC C148216
J801: AO1; CONN-TH_2P-P5.08_KF2EDGR-5.08-2P; MPN KF2EDGR-5.08-2P; LCSC C441204
J802: AO2; CONN-TH_2P-P5.08_KF2EDGR-5.08-2P; MPN KF2EDGR-5.08-2P; LCSC C441204
P801: 2-pole plug for J801; MPN KF2EDGK-5.08-2P-AA; LCSC C440880
P802: 2-pole plug for J802; MPN KF2EDGK-5.08-2P-AA; LCSC C440880
Q801: 2N7002DW; SOT-363_L2.0-W1.3-P0.65-LS2.1-TL; MPN 2N7002DW-7-F; LCSC C83571
R811, R812: 1k; R_0603_1608Metric; MPN 0603WAF1001T5E; LCSC C21190
R813, R814: 10.0k 0.1%; R_0603_1608Metric; MPN RT0603BRD0710KL; LCSC C95204
R815, R816: 100R; R_0603_1608Metric; MPN 0603WAF1000T5E; LCSC C22775
R817, R818: 14.7k 0.1%; R_0603_1608Metric; MPN RT0603BRD0714K7L; LCSC C705725
R821, R822: 100k; R_0603_1608Metric; MPN 0603WAF1003T5E; LCSC C25803
U801: CA-IS3740HW; SOIC-16_L10.3-W7.5-P1.27-LS10.3-BL; MPN CA-IS3740HW; LCSC C528653
U802: MCP4822-E/SN; SOIC-8_L4.9-W3.9-P1.27-LS6.0-BL; MPN MCP4822-E/SN; LCSC C16040
U803: LM2904; SOIC-8_L4.9-W3.9-P1.27-LS6.0-BL; MPN LM2904DR; LCSC C7934
U804: L78L05; SOT-89-3_L4.5-W2.5-P1.50-LS4.2-TL; MPN L78L05ABUTR; LCSC C42738

Connections:
+3V3: C801.1, U801.1 (VDDA)
+5V_A: C802.1, C803.1, C808.1, U801.10 (ENB), U801.16 (VDDB), U802.1 (VDD), U804.1 (VOUT)
+15V_A: C804.1, C807.1, U803.8 (VCC), U804.3 (VIN)
AGND: C802.2, C803.2, C804.2, C805.2, C806.2, C807.2, C808.2, D801.2 (A), D802.2 (A), J801.2, J802.2, Q801.1 (S2), Q801.4 (S1), R813.2, R814.2, R821.2, R822.2, U801.9 (GNDB), U801.15 (GNDB), U802.5 (~LDAC), U802.7 (VSS), U803.4 (GND), U804.2 (GND)
AO1_P: Q801.3 (D1), R811.2, R821.1, U803.3 (1IN+)
AO2_P: Q801.6 (D2), R812.2, R822.1, U803.5 (2IN+)
AO_CLAMP: U801.6 (VI4)
CLAMP_A: Q801.2 (G2), Q801.5 (G1), U801.11 (VO4)
CS_A: U801.12 (VO3), U802.2 (~CS)
DAC_A: R811.1, U802.8 (VOUTA)
DAC_B: R812.1, U802.6 (VOUTB)
DAC_CS: U801.5 (VI3)
DAC_MOSI: U801.4 (VI2)
DAC_SCK: U801.3 (VI1)
GND_L: C801.2, U801.2 (GNDA), U801.8 (GNDA)
unnamed: C805.1, D801.1 (K), J801.1, R815.2, R817.2
unnamed: C806.1, D802.1 (K), J802.1, R816.2, R818.2
unnamed: R813.1, R817.1, U803.2 (1IN-)
unnamed: R814.1, R818.1, U803.6 (2IN-)
unnamed: R815.1, U803.1 (1OUT)
unnamed: R816.1, U803.7 (2OUT)
SCK_A: U801.14 (VO1), U802.3 (SCK)
SDI_A: U801.13 (VO2), U802.4 (SDI)

Notes on the sheet:
8 ANALOG OUTPUTS - 2 x 0 to 10 V, 12 bit, isolated, 0 V at power-up and on loss
Gain 1 + 14.7 k / 10.0 k = 2.47 (0.1 % resistors): DAC full scale 4.095 V gives 10.11 V; firmware calibrates the 0 V and 10 V points of each channel.
Output 100 R inside the feedback loop, SMAJ15A and 10 nF to AGND. At 10 V into 2 k the op-amp swings to 10.6 V, below its 13.5 V limit on 15 V.
Design notes
Accuracy after calibration: reference drift 125 ppm/C x 55 C = 0.7 %, offset 3 mV = 0.03 %, resistors 0.2 %: about +/-0.9 % FS worst case over 0 to 80 C.
LOGIC (GND_L)
CA-IS3740HW outputs default high: CS_A high deselects the DAC and CLAMP_A high turns the clamp MOSFET on, so both outputs sit at 0 V at power-up and when logic power is lost.
SPI and the clamp signal pass a CA-IS3740HW (default high: DAC deselected, outputs clamped) to an MCP4822 on +5V_A (78L05 from +15V_A). A clamp MOSFET holds both op-amp inputs at AGND until firmware releases AO_CLAMP.
ANALOG (AGND)
