yi-aditya/LCEC-IO/hardware/lcec-io.kicad_sch

## KiCad design hardware/lcec-io.kicad_sch (2026-11-06)

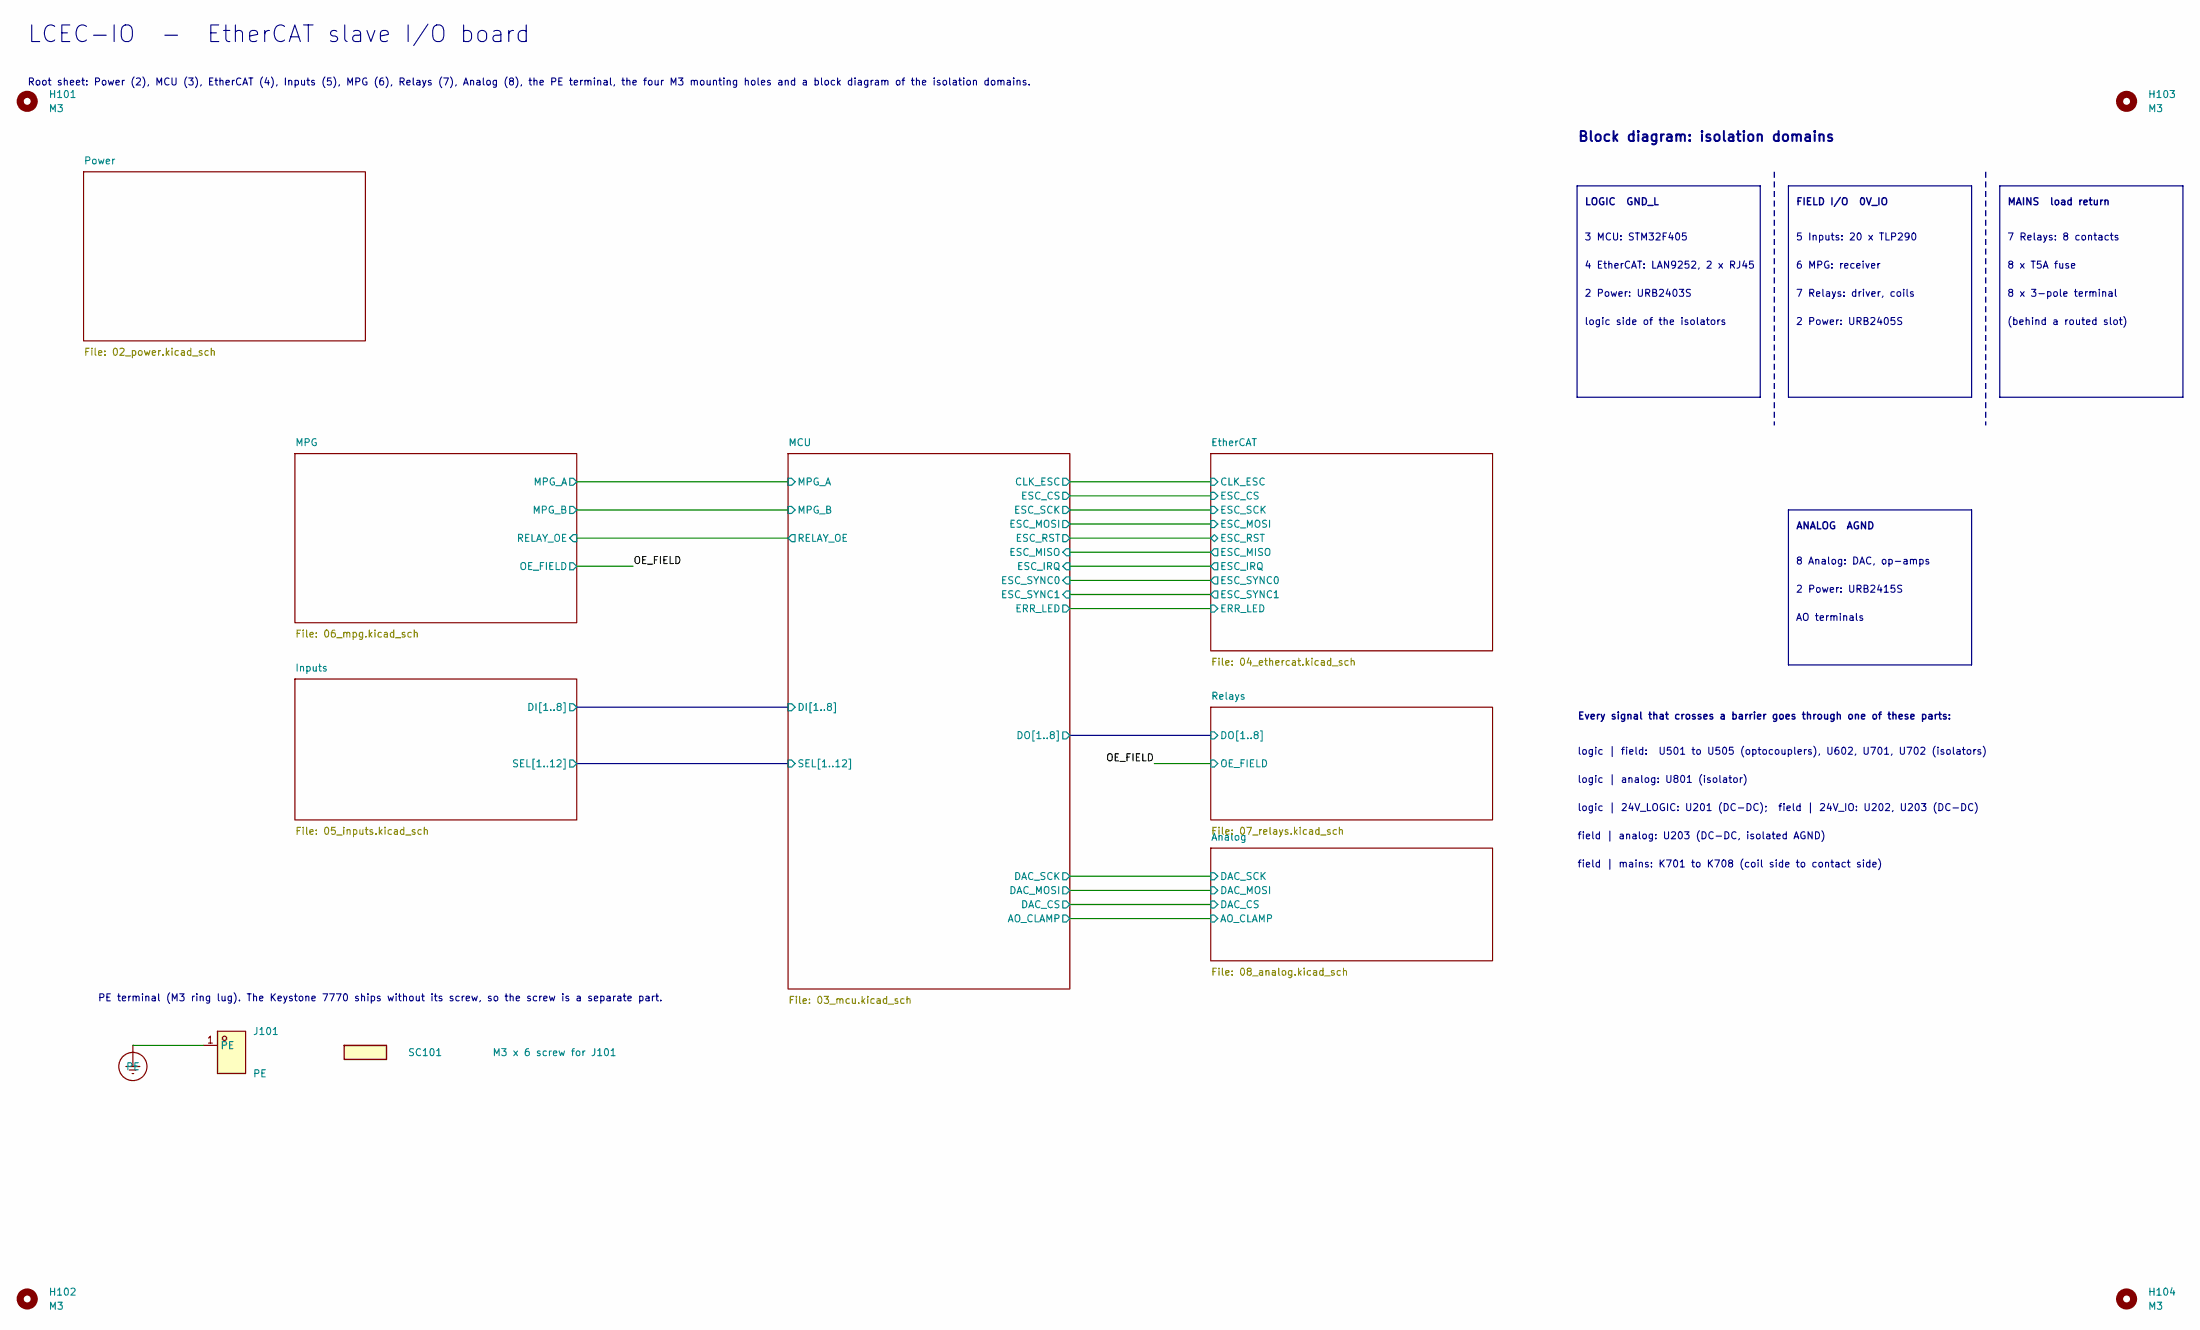
[picture p44: schematic lcec-io.kicad_sch]

Parts:
H101, H102, H103, H104: M3; MountingHole_3.2mm_M3; LCSC n/a (mechanical)
J101: PE; Keystone_7770_M3_PCB_Terminal; MPN 7770; LCSC C5272782
SC101: M3 x 6 screw for J101; MPN PM3X6; LCSC C357543

Connections:
PE: J101.1

Notes on the sheet:
5 Inputs: 20 x TLP290
2 Power: URB2405S
7 Relays: 8 contacts
Block diagram: isolation domains
2 Power: URB2403S
8 Analog: DAC, op-amps
6 MPG: receiver
2 Power: URB2415S
PE terminal (M3 ring lug). The Keystone 7770 ships without its screw, so the screw is a separate part.
8 x T5A fuse
7 Relays: driver, coils
MAINS load return
LCEC-IO - EtherCAT slave I/O board
Root sheet: Power (2), MCU (3), EtherCAT (4), Inputs (5), MPG (6), Relays (7), Analog (8), the PE terminal, the four M3 mounting holes and a block diagram of the isolation domains.
8 x 3-pole terminal
4 EtherCAT: LAN9252, 2 x RJ45
ANALOG AGND
logic side of the isolators
LOGIC GND_L
FIELD I/O 0V_IO
AO terminals
logic | 24V_LOGIC: U201 (DC-DC); field | 24V_IO: U202, U203 (DC-DC)
logic | analog: U801 (isolator)
field | mains: K701 to K708 (coil side to contact side)
(behind a routed slot)
Every signal that crosses a barrier goes through one of these parts:
logic | field: U501 to U505 (optocouplers), U602, U701, U702 (isolators)
3 MCU: STM32F405
field | analog: U203 (DC-DC, isolated AGND)
