yi-aditya/LCEC-IO/(commit log)

2026-11-05 M1: parts list (bom/parts.csv) with live LCSC checks
    bom/parts.csv covers every part in docs/plan.md plus the commodity
    parts and passives, each with LCSC number, rating, stock and price
    checked live. scripts/build_bom.py rebuilds and validates it;
    lcsc_lookup.py and jlc_search.py are the lookup helpers.
    docs/review/M1-parts.md is the browser-readable review sheet.
    Plan parts with problems are marked DECISION with a proposed
    replacement; nothing in docs/plan.md is changed.
    Claude-Session: https://claude.ai/code/session_017ueaijVDRjweiVc1vqF2Mp
    [parts.csv]
2026-11-05 M1: apply owner decisions from review
    - MPG receiver C6180, relay driver C845537 (plan numbers had no stock)
    - add 3 x 100 uF/100 V URB input capacitors
    - yellow-green status LEDs accepted
    - 24 V input fuses are replaceable 5x20 mm (holder C58066, fuses C3116/C3118)
    - keep 7 terminal sets; keep SMBJ33A, solve the 40 V module limit in M3
    - record all of the above in the plan's Decisions log
    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
    [parts.csv]
2026-11-05 M1: one connector per I/O
    20 inputs and 8 relays on 3-pole 5.08 mm connectors, 2 analog outputs
    on 2-pole. Removes the 8-, 10- and 14-pole terminals (and with them the
    14-pole stock problem). Logged in the plan's Decisions log.
    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
    [parts.csv]
2026-11-06 M2 (work in progress): LCSC library import, pin tables, checker
    - lib/: 39 of 42 LCSC parts imported with easyeda2kicad (3 cable plugs /
    PE terminal still retrying: EasyEDA API returns 403 intermittently)
    - scripts/import_lcsc.py: retrying importer, safe to re-run
    - scripts/pin_tables.py + pincheck.py: datasheet pin tables and checker
    - scripts/fix_symbols.py: corrects names, pin types and fields (not yet run)
    - hardware/: project symbol and footprint library tables
    - .gitignore: STEP models (80 MB) ignored, .wrl models committed
    Library is in raw imported state; fixes and review docs follow.
    Claude-Session: https://claude.ai/code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
    [build_bom.py, fix_symbols.py, import_lcsc.py, pin_tables.py, pincheck.py]
2026-11-06 M2: libraries imported, corrected and pin-checked against datasheets
    - lib/lcsc.kicad_sym: 42 symbols (39 easyeda2kicad + 3 made by hand where
    EasyEDA has no data: Keystone 7770 footprint drawn from the drawing,
    two cable plugs); lib/lcsc.pretty: 32 footprints; .wrl 3D models
    - scripts/fix_symbols.py corrects names, pin types and fields; log of the
    170 changes in docs/review/M2-symbol-fixes.md; raw import kept in lib/raw/
    - scripts/pin_tables.py + pincheck.py: 42/42 symbols match the datasheets,
    symbol pins match footprint pads (docs/review/M2-pin-check.md)
    - KiCad 10 loads the symbol library and all footprints
    - BOM footprints now come from the library
    - docs/review/M2-libraries.md: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
    [parts.csv]
2026-11-06 M2 review decisions: 100-pin STM32, lcsc.com-only sourcing, Littelfuse fuse blocks
    - MCU: STM32F405VGT6 (LQFP-100, C56621) replaces the 64-pin part; EtherCAT
    ERR LED on PD3 (LAN9252 has no ERR output); all other pins unchanged
    - Sourcing: PCBPower buys from lcsc.com only; JLCPCB stock lookup removed;
    four zero-stock capacitors replaced (C1591, C1589, C559769, C91185);
    rule added to CLAUDE.md
    - PE terminal: keep Keystone 7770, add M3 x 6 screw (C357543)
    - Fuse holder C58066 (no drawing) replaced by Littelfuse 646 block C206887
    plus 648 cover C187509; footprint matches the 22.6 mm hole pattern
    - pincheck now verifies footprint geometry against datasheet dimensions
    (RJ45, relay socket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
    [parts.csv]
2026-11-06 M3: power and MCU sheets, root sheet, schematic generator and checks
    - hardware/: KiCad project with root (page 1), Power (2) and MCU (3) sheets,
    generated by scripts/build_schematics.py via scripts/schgen.py
    - Power: two protected 24 V entries (fuse, SS54, SMBJ33A, bulk caps), three
    URB modules with the isolation barrier drawn through them, test points
    - MCU: STM32F405VGT6 (LQFP-100) with per-pin decoupling, 25 MHz oscillator,
    SWD and USART headers, fail-safe pull resistors, heartbeat LED, test
    points; buses DI/SEL/DO to the sheet edge; 30 free pins with NC flags
    - scripts/check_sheets.py: ERC, plan.md pin map vs netlist, power topology,
    isolation, fields, barrier crossings, BOM q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
    [02_power.kicad_sch, 03_mcu.kicad_sch, lcec-io.kicad_sch]
2026-11-06 M3: redraw Power and MCU sheets with rotation-free symbols, horizontal text and clean layout
    New lcec library of standard KiCad graphics pre-rotated for series/shunt use, two-unit STM32 symbol with no top/bottom pins, style check added to check_sheets.py, review PDF/PNG/ERC regenerated.
    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
    [02_power.kicad_sch, 03_mcu.kicad_sch]
2026-11-06 M3: TVS changed to SMBJ30A (C83851) per owner decision; plan decisions log, BOM, library, sheets and review files updated
    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
    [02_power.kicad_sch, 03_mcu.kicad_sch, parts.csv]
2026-11-06 M4: EtherCAT sheet (LAN9252 SPI, ESI EEPROM, two RJ45 jacks, RUN/ERR LEDs), root wiring, relayout of LAN9252/RJ45/EEPROM symbols, netlist checks
    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
    [03_mcu.kicad_sch, 04_ethercat.kicad_sch, lcec-io.kicad_sch, parts.csv]
2026-11-06 M4: align EtherCAT sheet with the EVB-LAN9252-SPI reference (per-supply ferrite beads, per-port terminations, 22 nF centre-tap caps); BOM, checks and review notes updated
    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
    [03_mcu.kicad_sch, 04_ethercat.kicad_sch, parts.csv]
2026-11-06 M5: Inputs, MPG, Relays and Analog sheets, root wiring, symbol relayouts, netlist checks, final BOM quantities
    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
    [03_mcu.kicad_sch, 04_ethercat.kicad_sch, 05_inputs.kicad_sch, 05b_input4.kicad_sch, 06_mpg.kicad_sch, 07_relays.kicad_sch, 08_analog.kicad_sch, lcec-io.kicad_sch]
2026-11-06 M5: record owner decisions (snubbers, COM jumper default, relay socket stock)
    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
2026-11-06 M6: root sheet (PE terminal, mounting holes, block diagram), BOM export, isolation and BOM-completeness checks, redrawn floor plan, plan review
    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
    [03_mcu.kicad_sch, 04_ethercat.kicad_sch, 08_analog.kicad_sch, M6-bom-assembly.csv, M6-bom.csv, lcec-io.kicad_sch]
2026-11-06 M6: floor plan v2 with stacked terminals (220 x 140 mm), owner decisions recorded
    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
2026-11-06 M6: keep both floor plans (v1 260 x 160 single row, v2 220 x 140 stacked), correct v2 area figure
    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
    [floorplan.py]
